laberge1/hw-openmower-universal/mech/PCB_02152026.FCStd

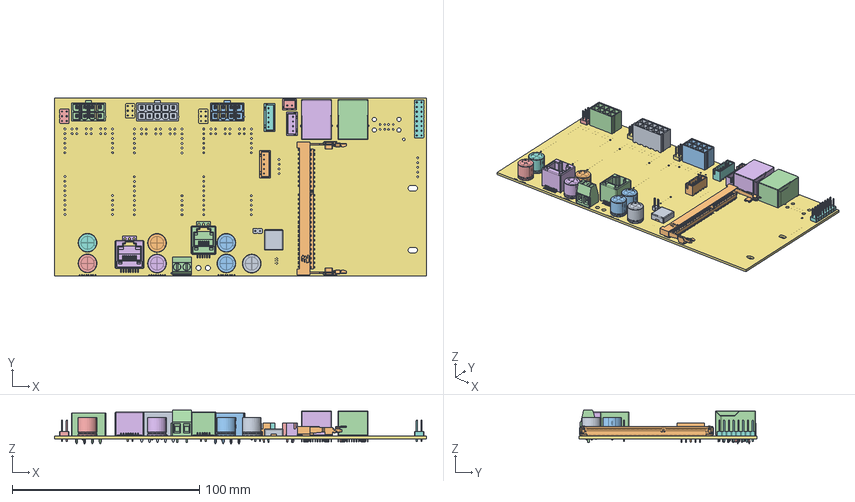
[picture p2: CAD file, 2026-03-07]
mech/PCB_02152026.FCStd
198.5 x 95.0 x 17.9 mm
10127820-1022LF
CP_Radial_D10.0mm_P5.00mm
CP_Radial_D10.0mm_P5.00mm001
10127820-082XXXLF
JST_XH_B2B-XH-A_1x02_P2.50mm_Vertical
JST_XH_B4B-XH-A_1x04_P2.50mm_Vertical
PinHeader_2x03_P2.54mm_Vertical
JST_XH_B5B-XH-A_1x05_P2.50mm_Vertical
CP_Radial_D10.0mm_P5.00mm002
JST_XH_B5B-XH-A_1x05_P2.50mm_Vertical002
10127820-082XXXLF001
HR911130A
HR911130A001
HR911130A002
HR911130A003
HR911130A004
HR911130A005
HR911130A006
HR911130A007
HR911130A008
HR911130A009
HR911130A010
HR911130A011
HR911130A012
HR911130A013
HR911130A014
HR911130A015
HR911130A016
HR911130A017
HR911130A018
HR911130A019
HR911130A020
HR911130A021
HR911130A022
HR911130A023
HR911130A024
HR911130A025
CP_Radial_D10.0mm_P5.00mm003
PinHeader_2x03_P2.54mm_Vertical001
CP_Radial_D10.0mm_P5.00mm004
hw-openmower-universal 1.61.005
hw-openmower-universal 1.61.006
hw-openmower-universal 1.61.007
TerminalBlock_Phoenix_MKDS-1,5-2-5.08_1x02_P5.08mm_Horizontal005
CP_Radial_D10.0mm_P5.00mm006
HR911130A027
HR911130A028
HR911130A029
HR911130A030
HR911130A031
HR911130A032
HR911130A033
HR911130A034
HR911130A035
HR911130A036
HR911130A037
HR911130A038
HR911130A039
HR911130A040
HR911130A041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
