laberge1/hw-openmower-universal/external_footprints/10127820_0621GLF/10127820-06xxlfc.stp

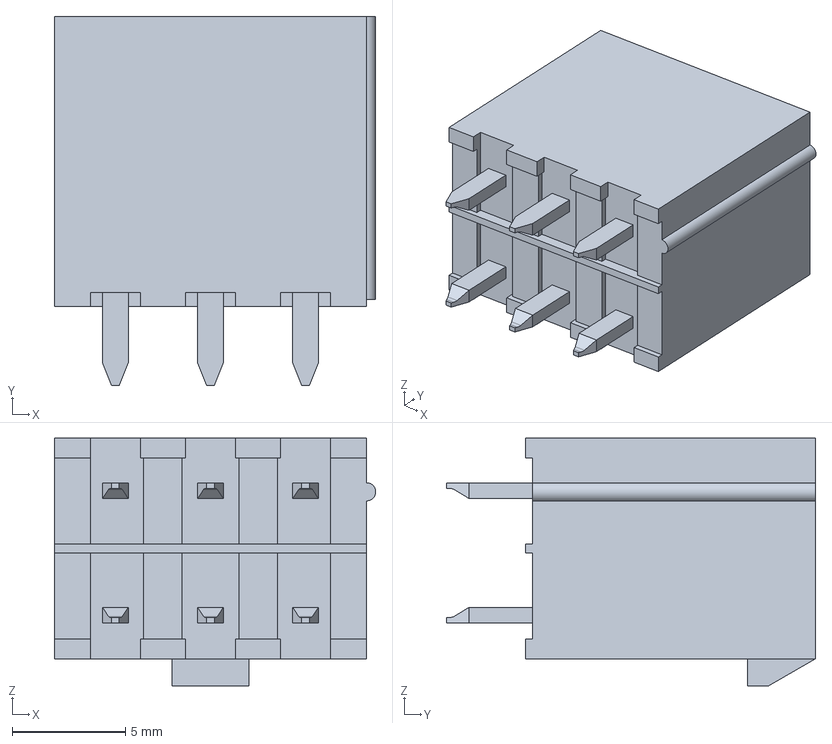
[picture p3: CAD file, 2026-03-07]
external_footprints/10127820_0621GLF/10127820-06xxlfc.stp
14.2 x 16.3 x 10.9 mm
