laberge1/hw-openmower-universal/external_footprints/10127820_0821LF/10127820-082XXXLF.stp

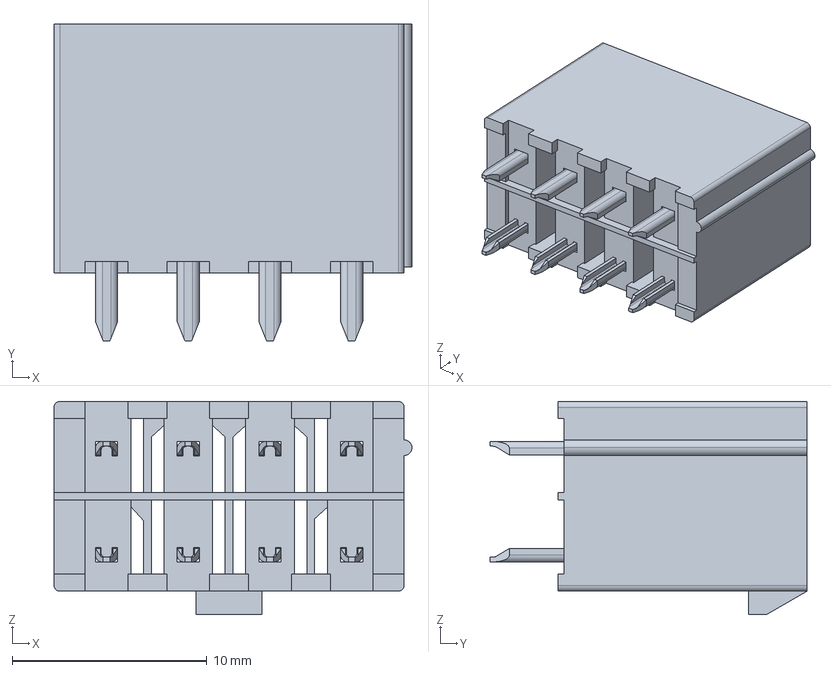
[picture p4: CAD file, 2026-03-07]
external_footprints/10127820_0821LF/10127820-082XXXLF.stp
18.4 x 16.3 x 11.0 mm
