laberge1/hw-openmower-universal/external_footprints/10127820_1022LF/10127820-10xxlfc.stp

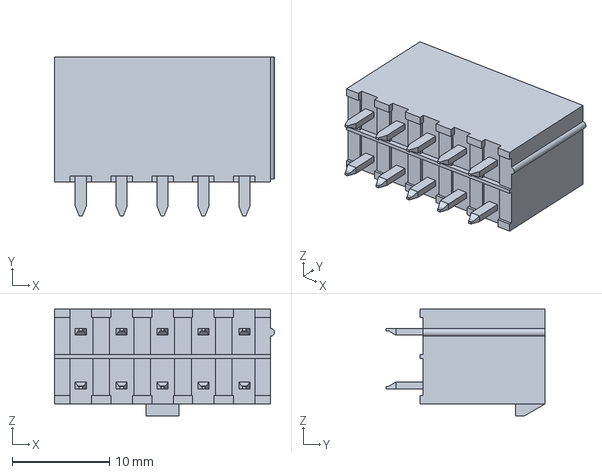
[picture p5: CAD file, 2026-03-07]
external_footprints/10127820_1022LF/10127820-10xxlfc.stp
22.6 x 16.3 x 10.9 mm
