laberge1/hw-openmower-universal/external_footprints/855135002/855135002.stp

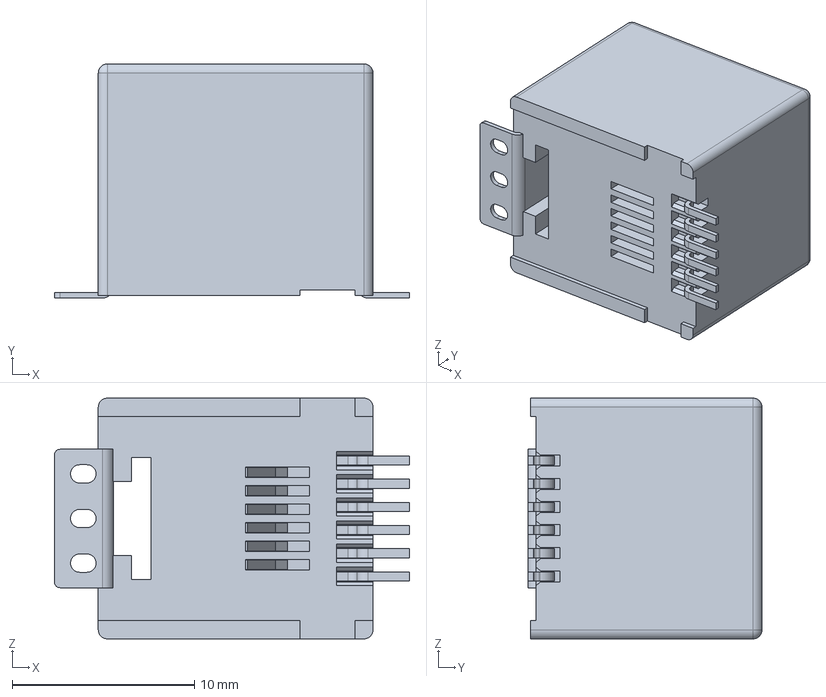
[picture p6: CAD file, 2026-03-07]
external_footprints/855135002/855135002.stp
19.5 x 12.8 x 13.2 mm
