laberge1/hw-openmower-universal/external_footprints/RJ45/855135113.stp

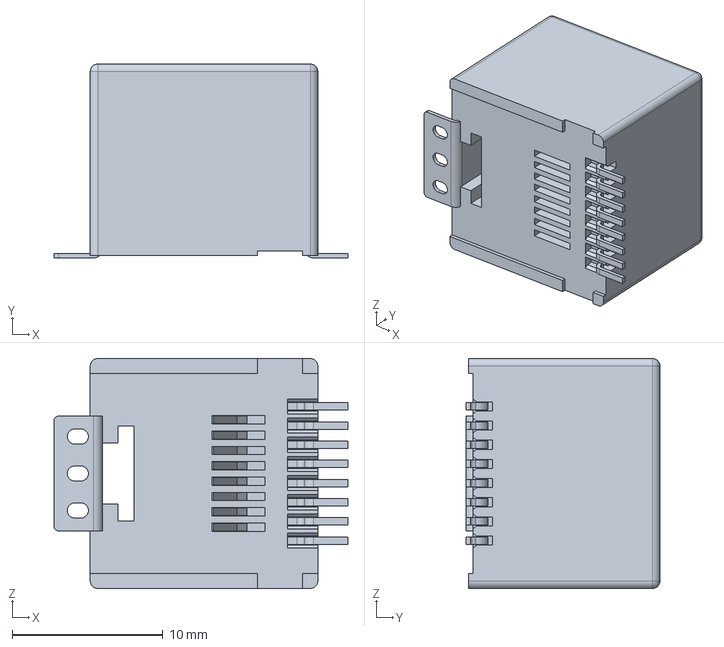
[picture p7: CAD file, 2026-03-07]
external_footprints/RJ45/855135113.stp
19.5 x 12.8 x 15.2 mm
