laberge1/hw-openmower-universal/(list of files, cad)

Other CAD files:
mech/2.FCStd
external_footprints/10127820_1022LF/10127820-1022LF.step
