laberge1/hw-openmower-universal/schematics/hw-openmower-universal.pdf

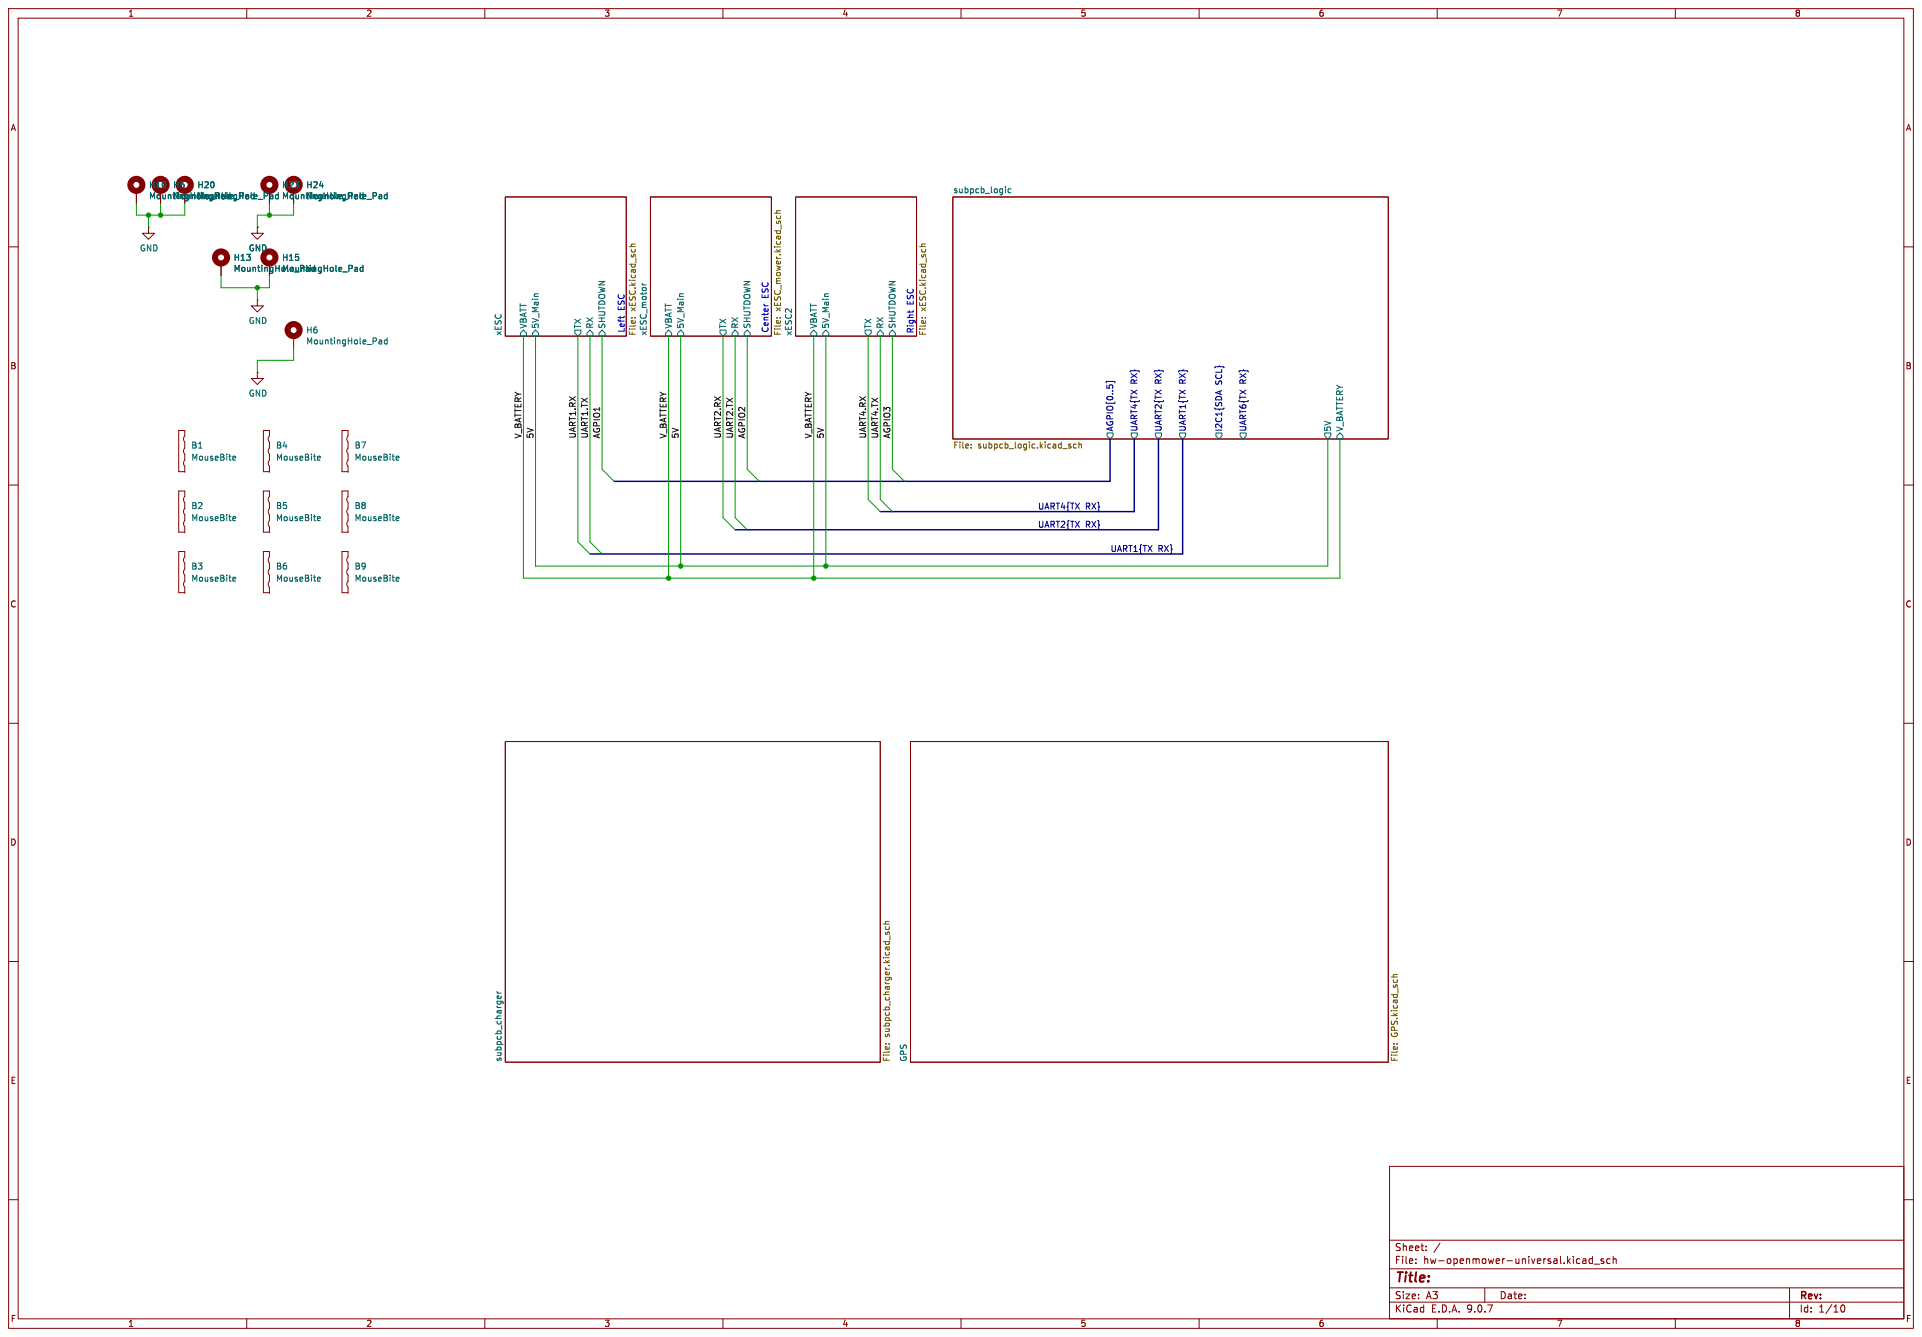
[picture p8: page 1]

UART1{TX RX} Right ESC Center ESC Left ESC

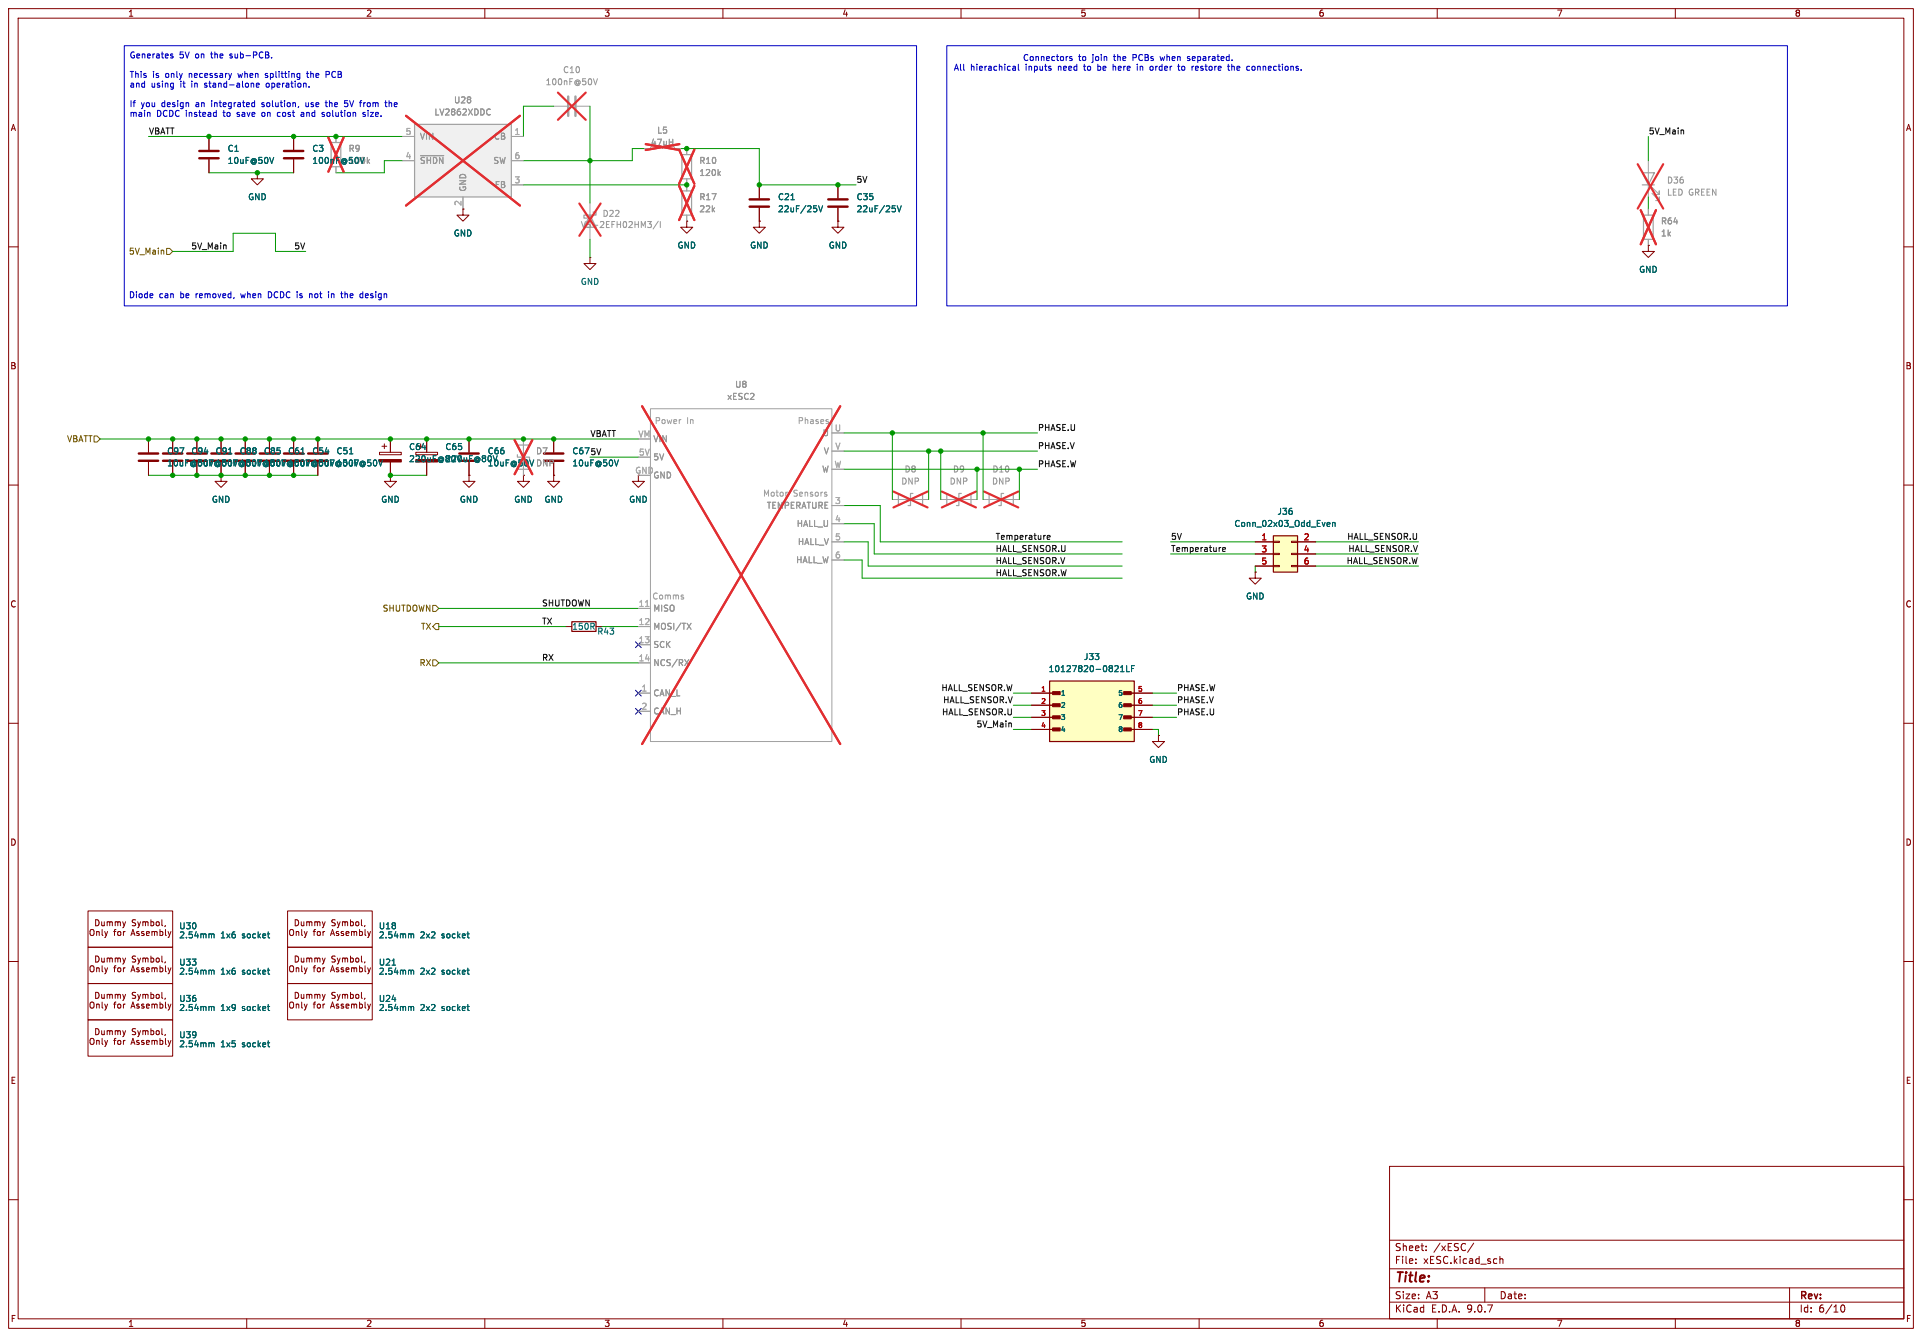
[picture p9: page 2]

2 CB 1 SW 6 FB 3 GND

D10 DNP D9 DNP D8 DNP GND

Id: 6/10 Title: File: xESC.kicad_sch Sheet: /xESC/

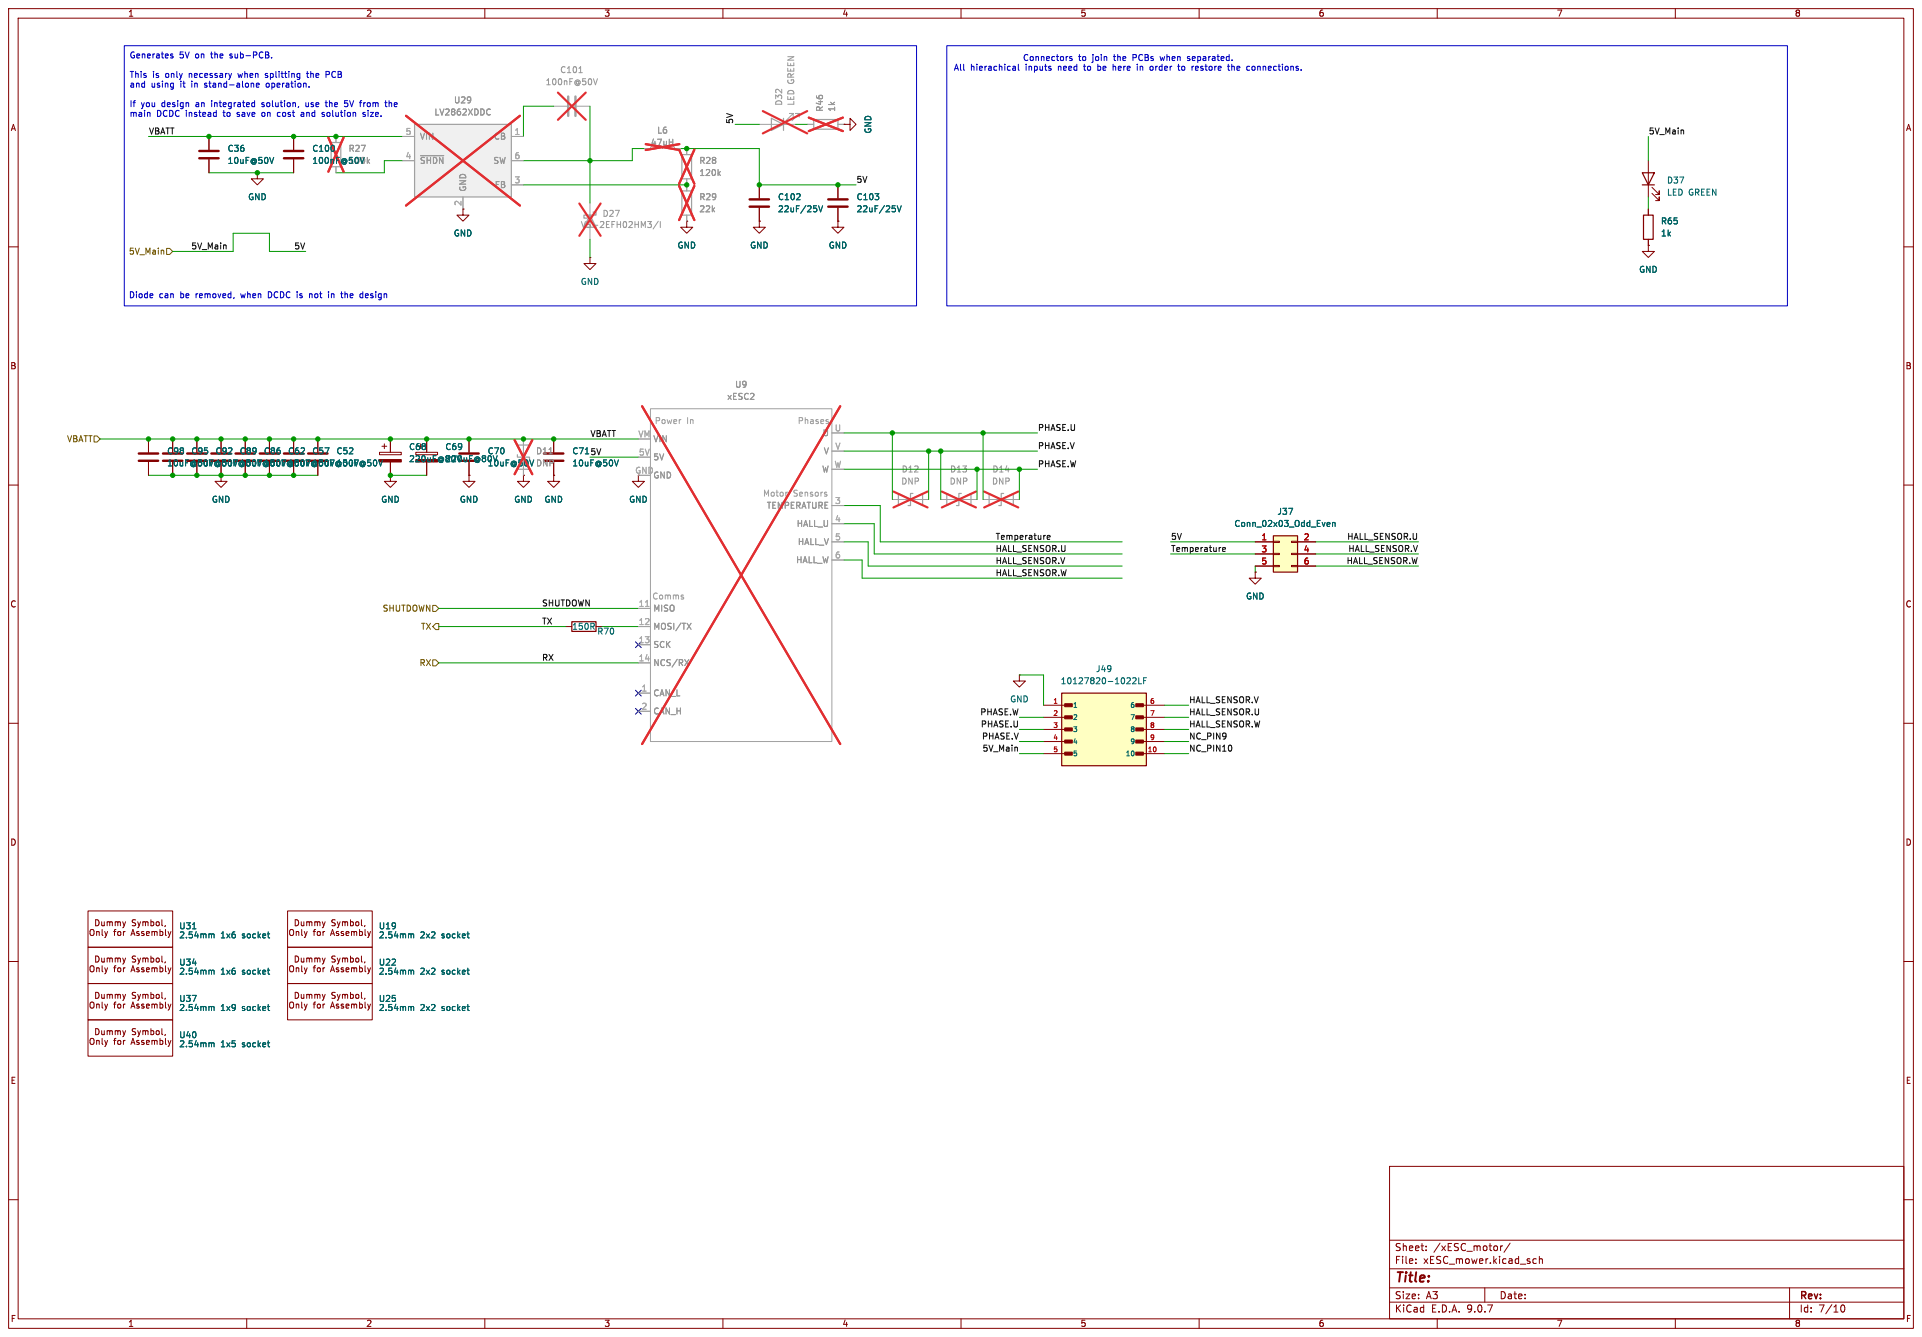
[picture p10: page 3]

2 CB 1 SW 6 FB 3 GND R46 1k L6 GND

Id: 7/10 Title: File: xESC_mower.kicad_sch Sheet: /xESC_motor/

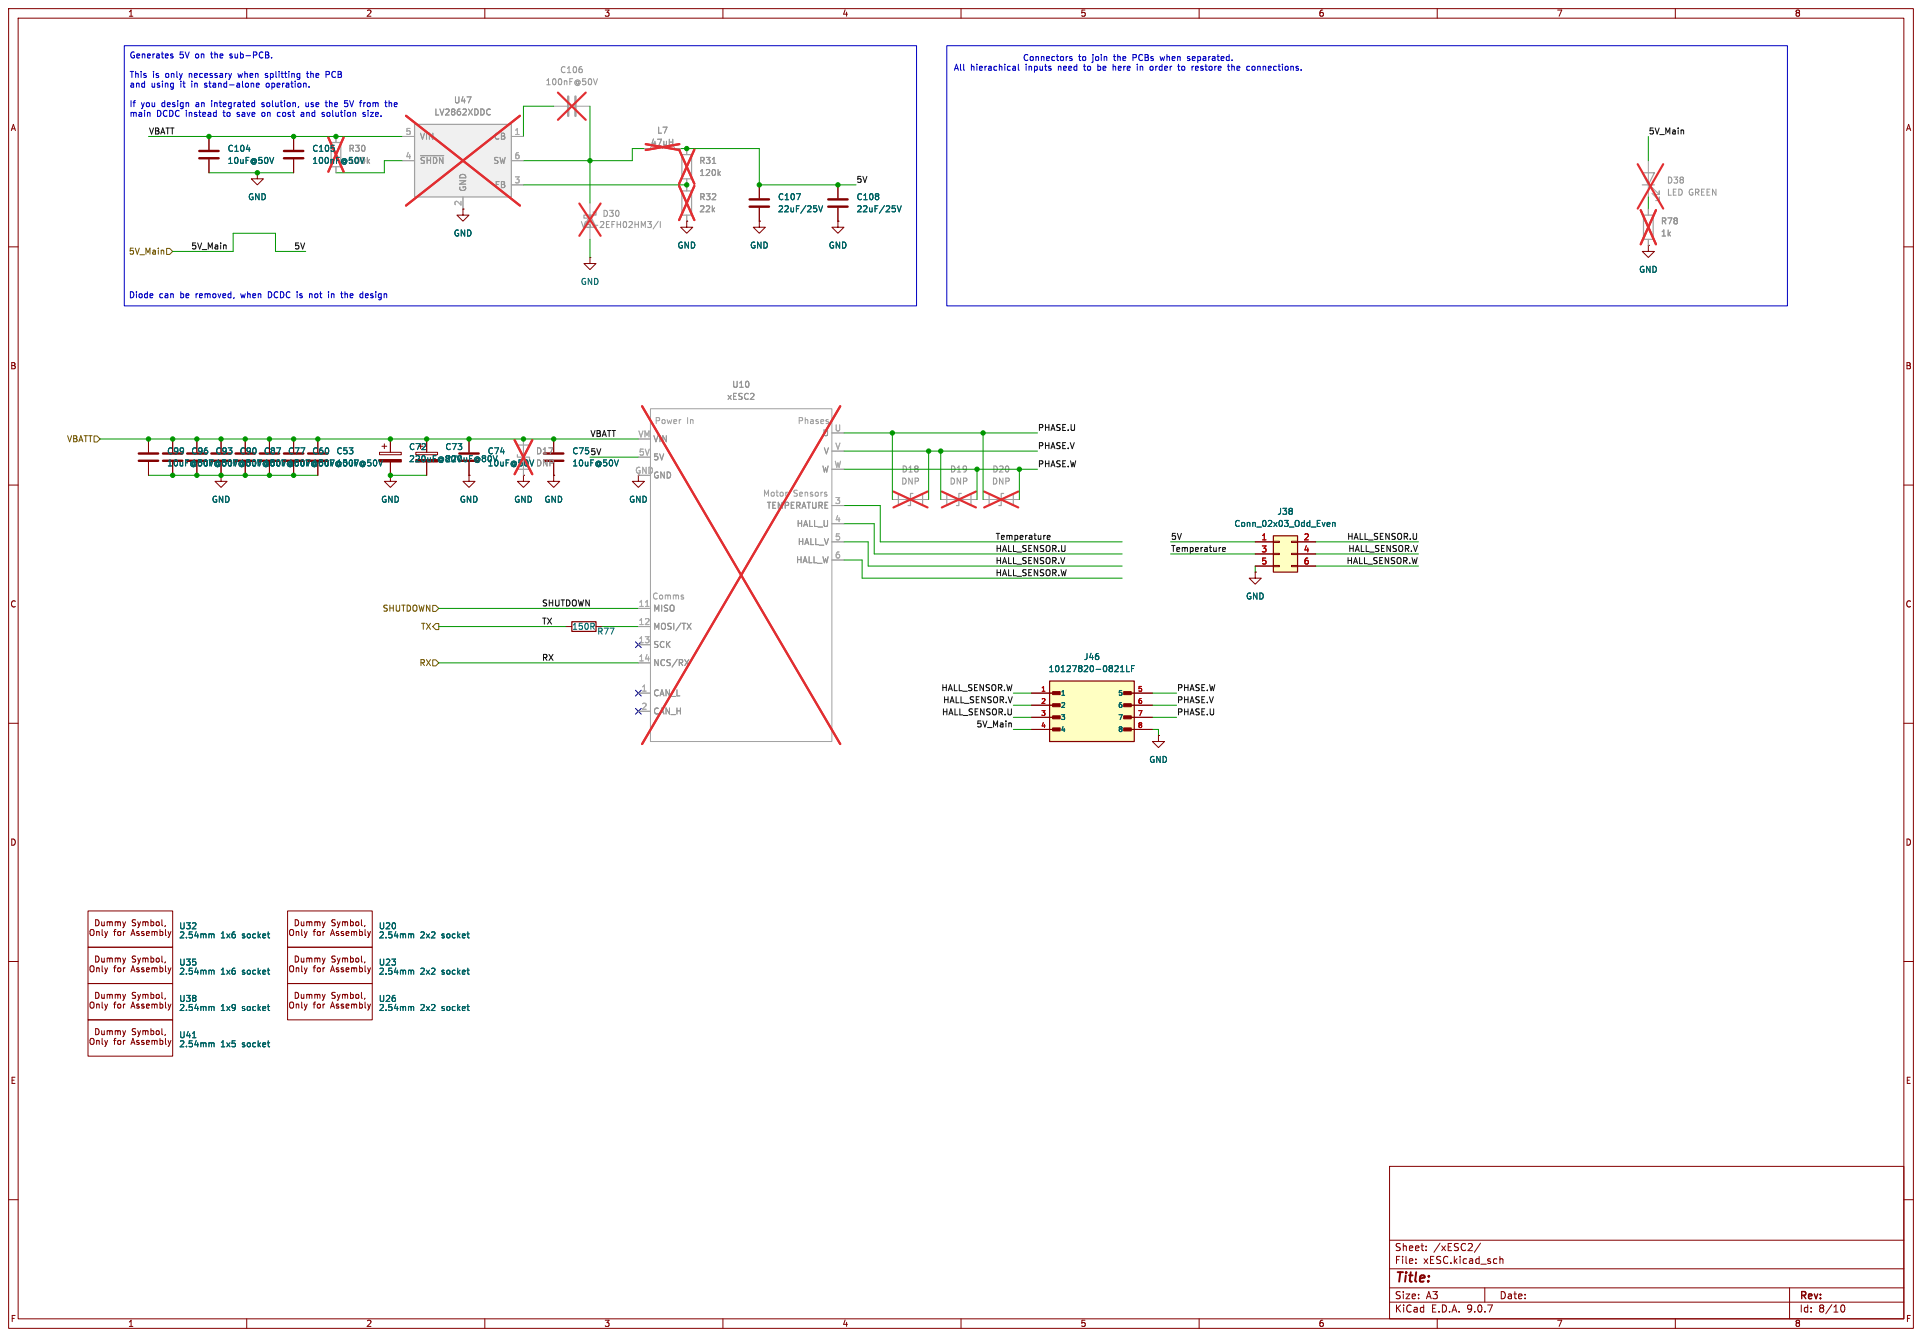
[picture p11: page 4]

2 CB 1 SW 6 FB 3 GND GND

Id: 8/10 Title: File: xESC.kicad_sch Sheet: /xESC2/

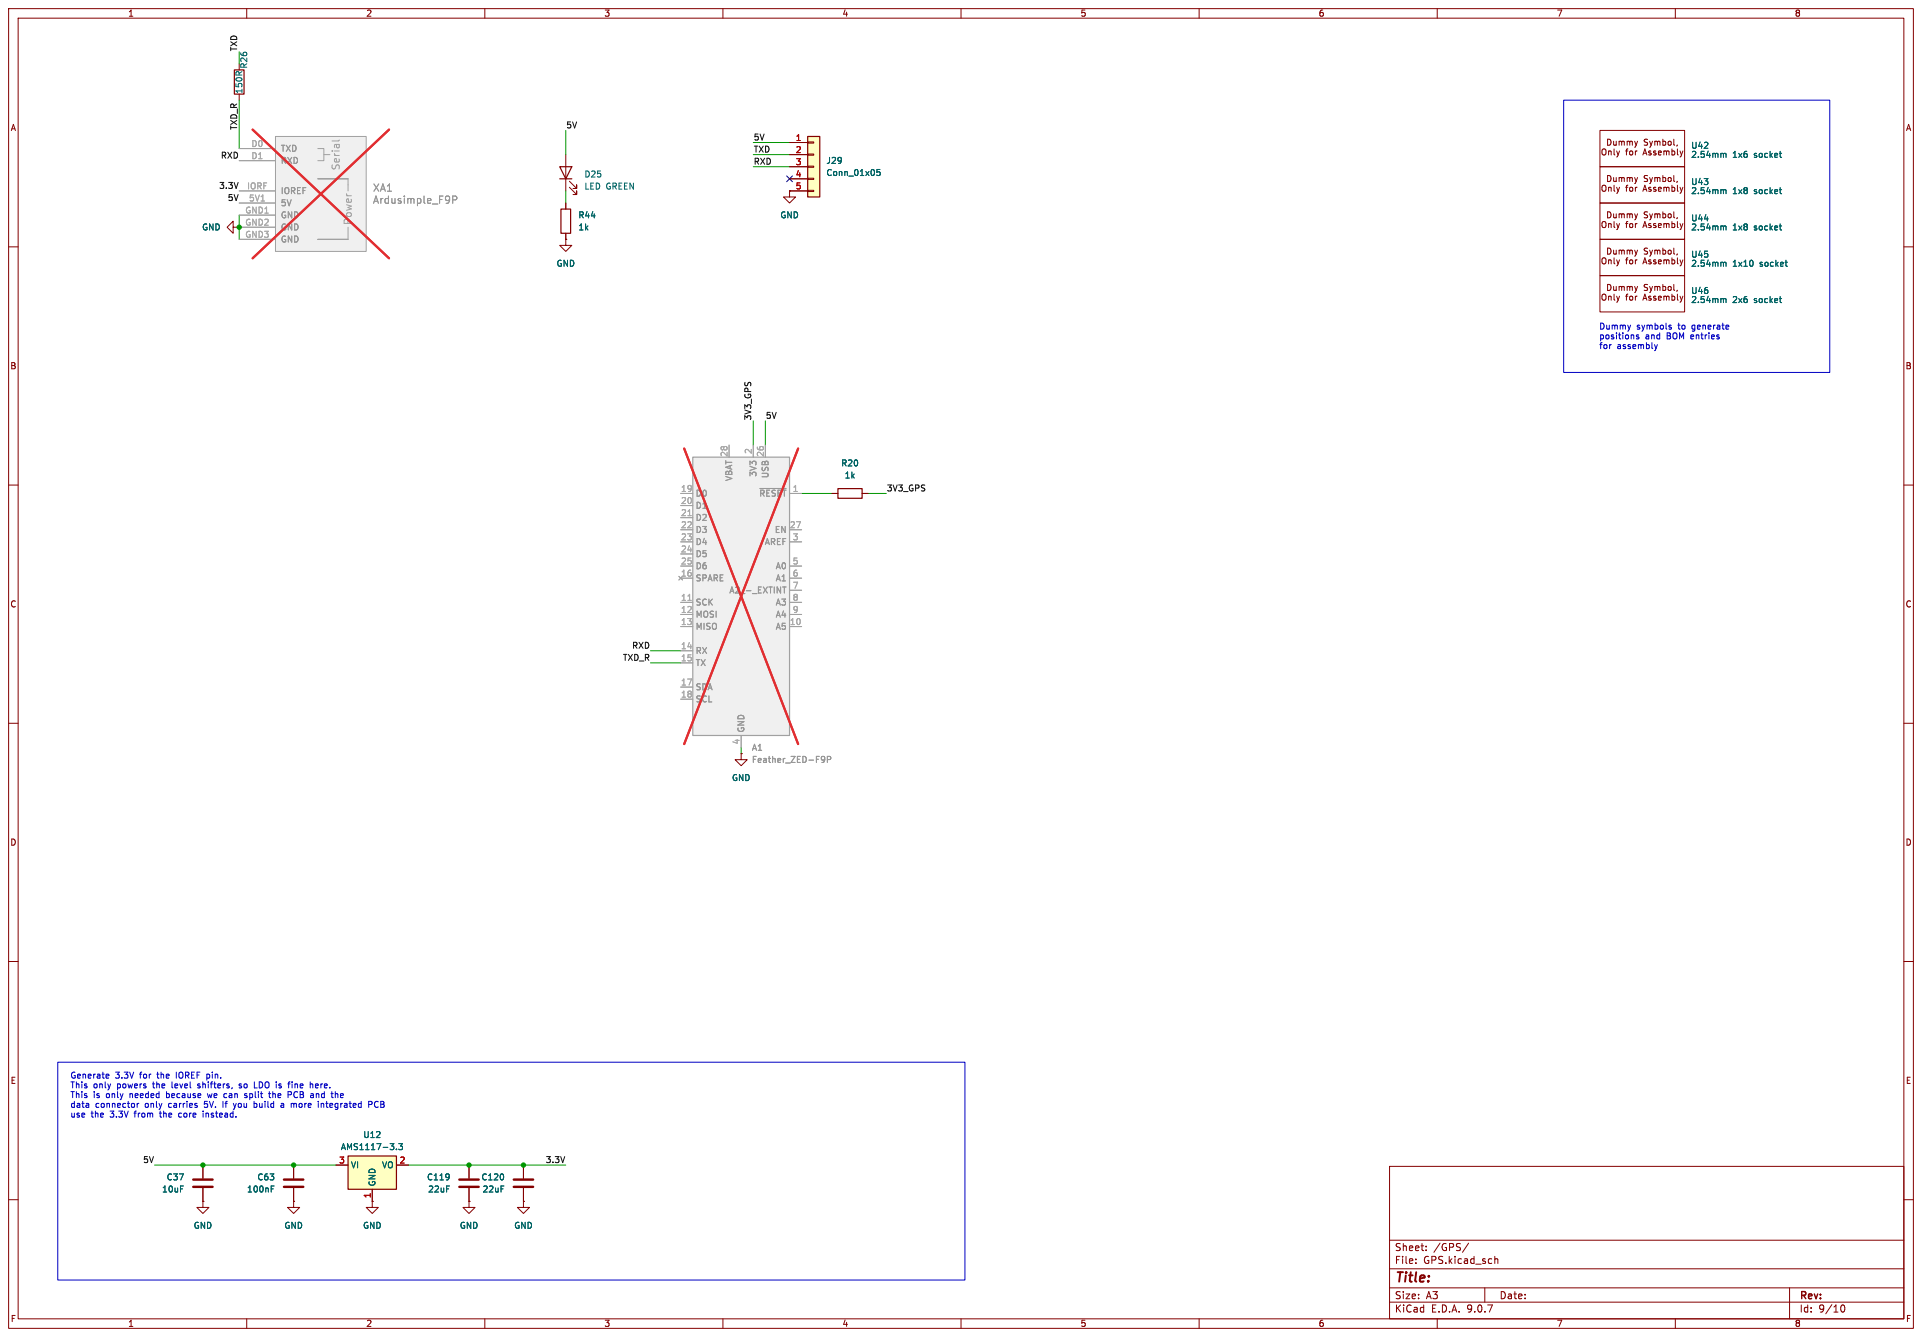
[picture p12: page 5]

Dummy symbols to generate
for assembly

use the 3.3V from the core instead.

Id: 9/10 Title: File: GPS.kicad_sch Sheet: /GPS/

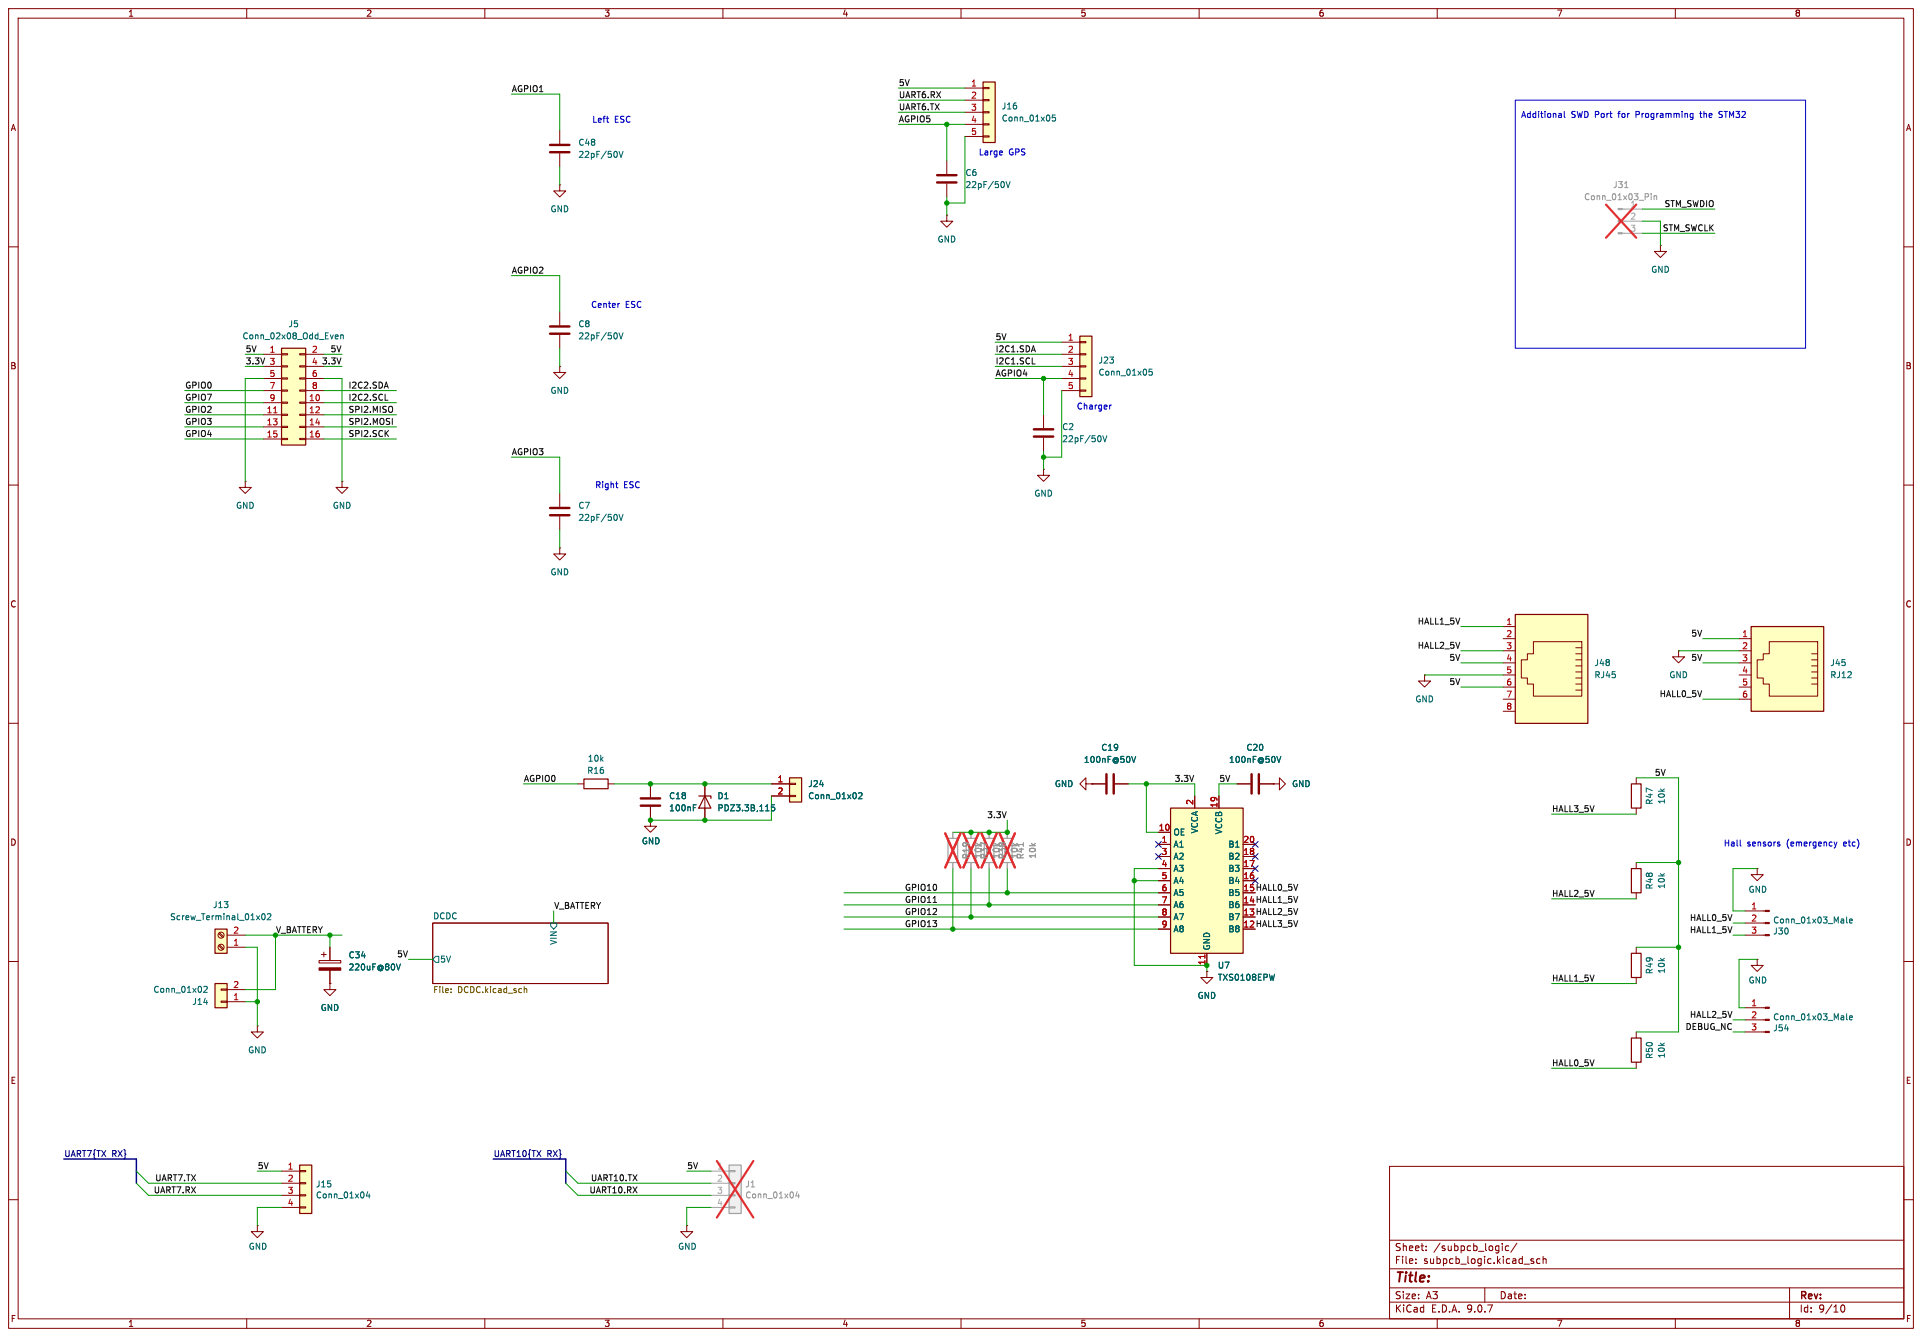
[picture p13: page 6]

Id: 9/10 Title: File: subpcb_logic.kicad_sch Sheet: /subpcb_logic/

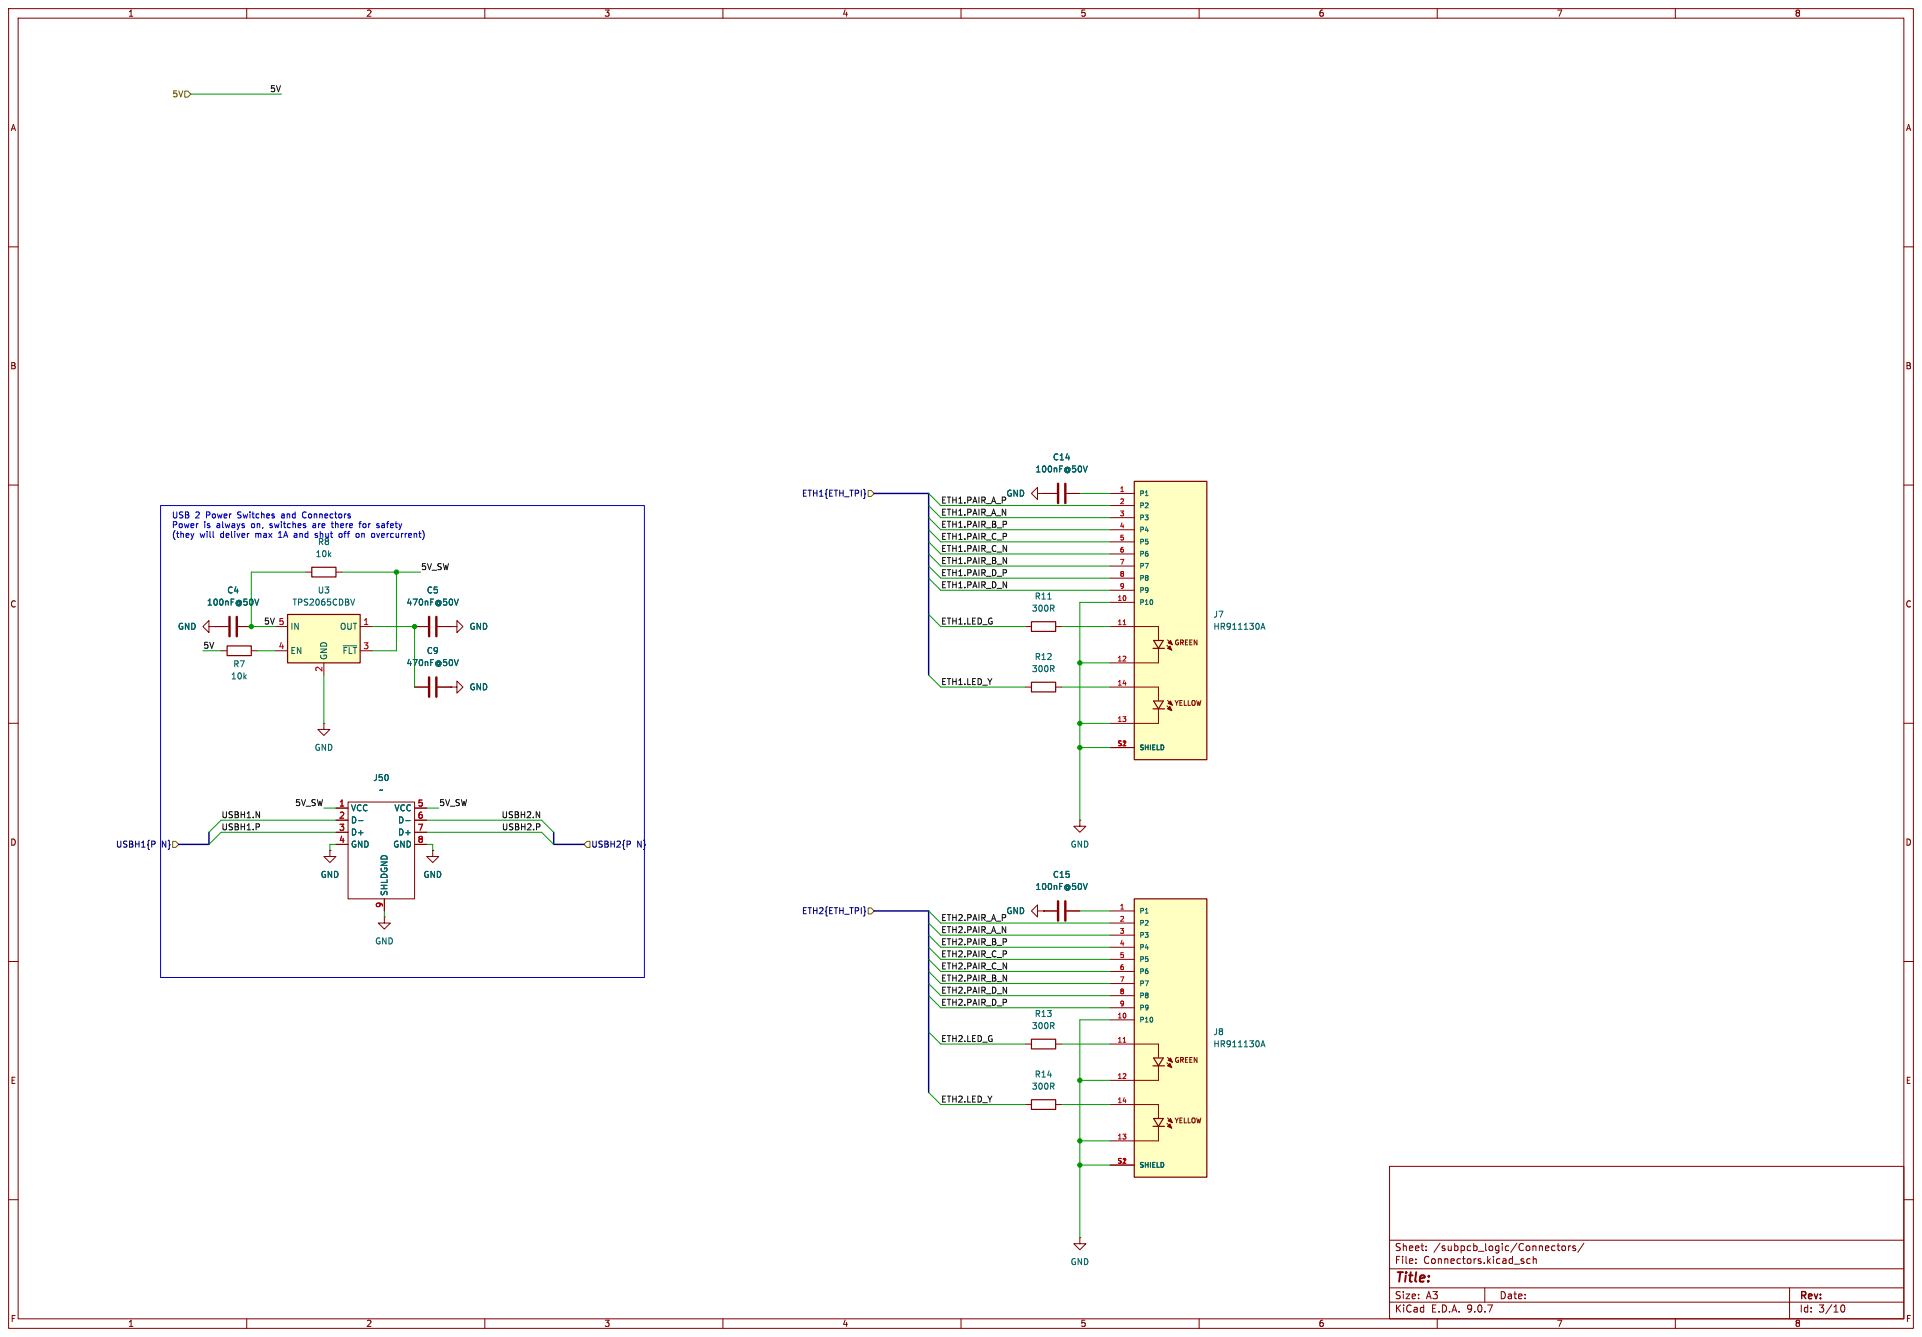
[picture p14: page 7]

USB 2 Power Switches and Connectors Power is always on, switches are there for safety

Id: 3/10 Title: File: Connectors.kicad_sch Sheet: /subpcb_logic/Connectors/

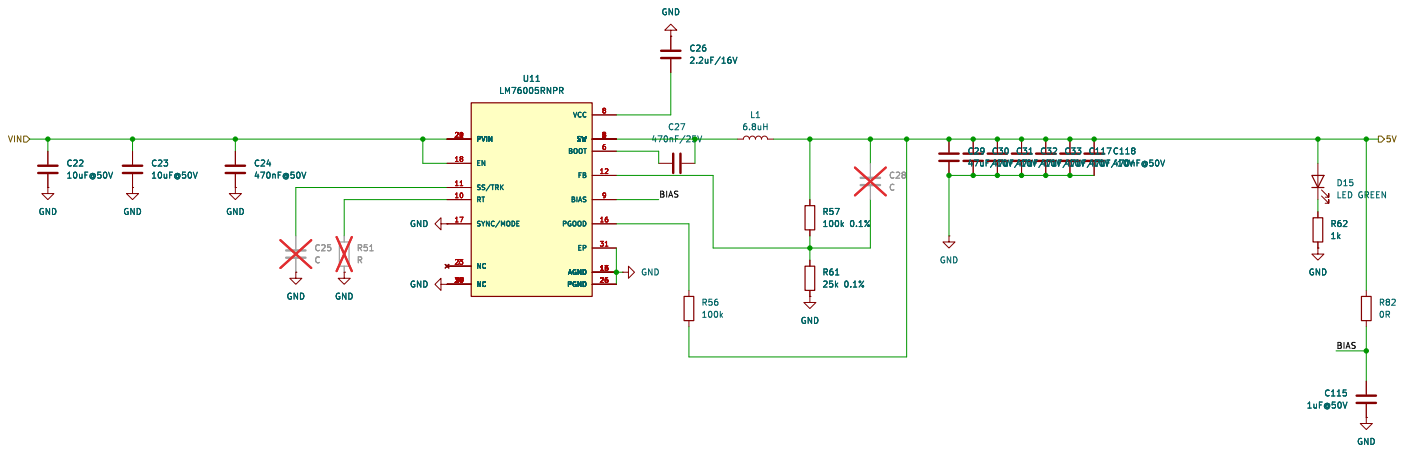
[picture p15: page 8]

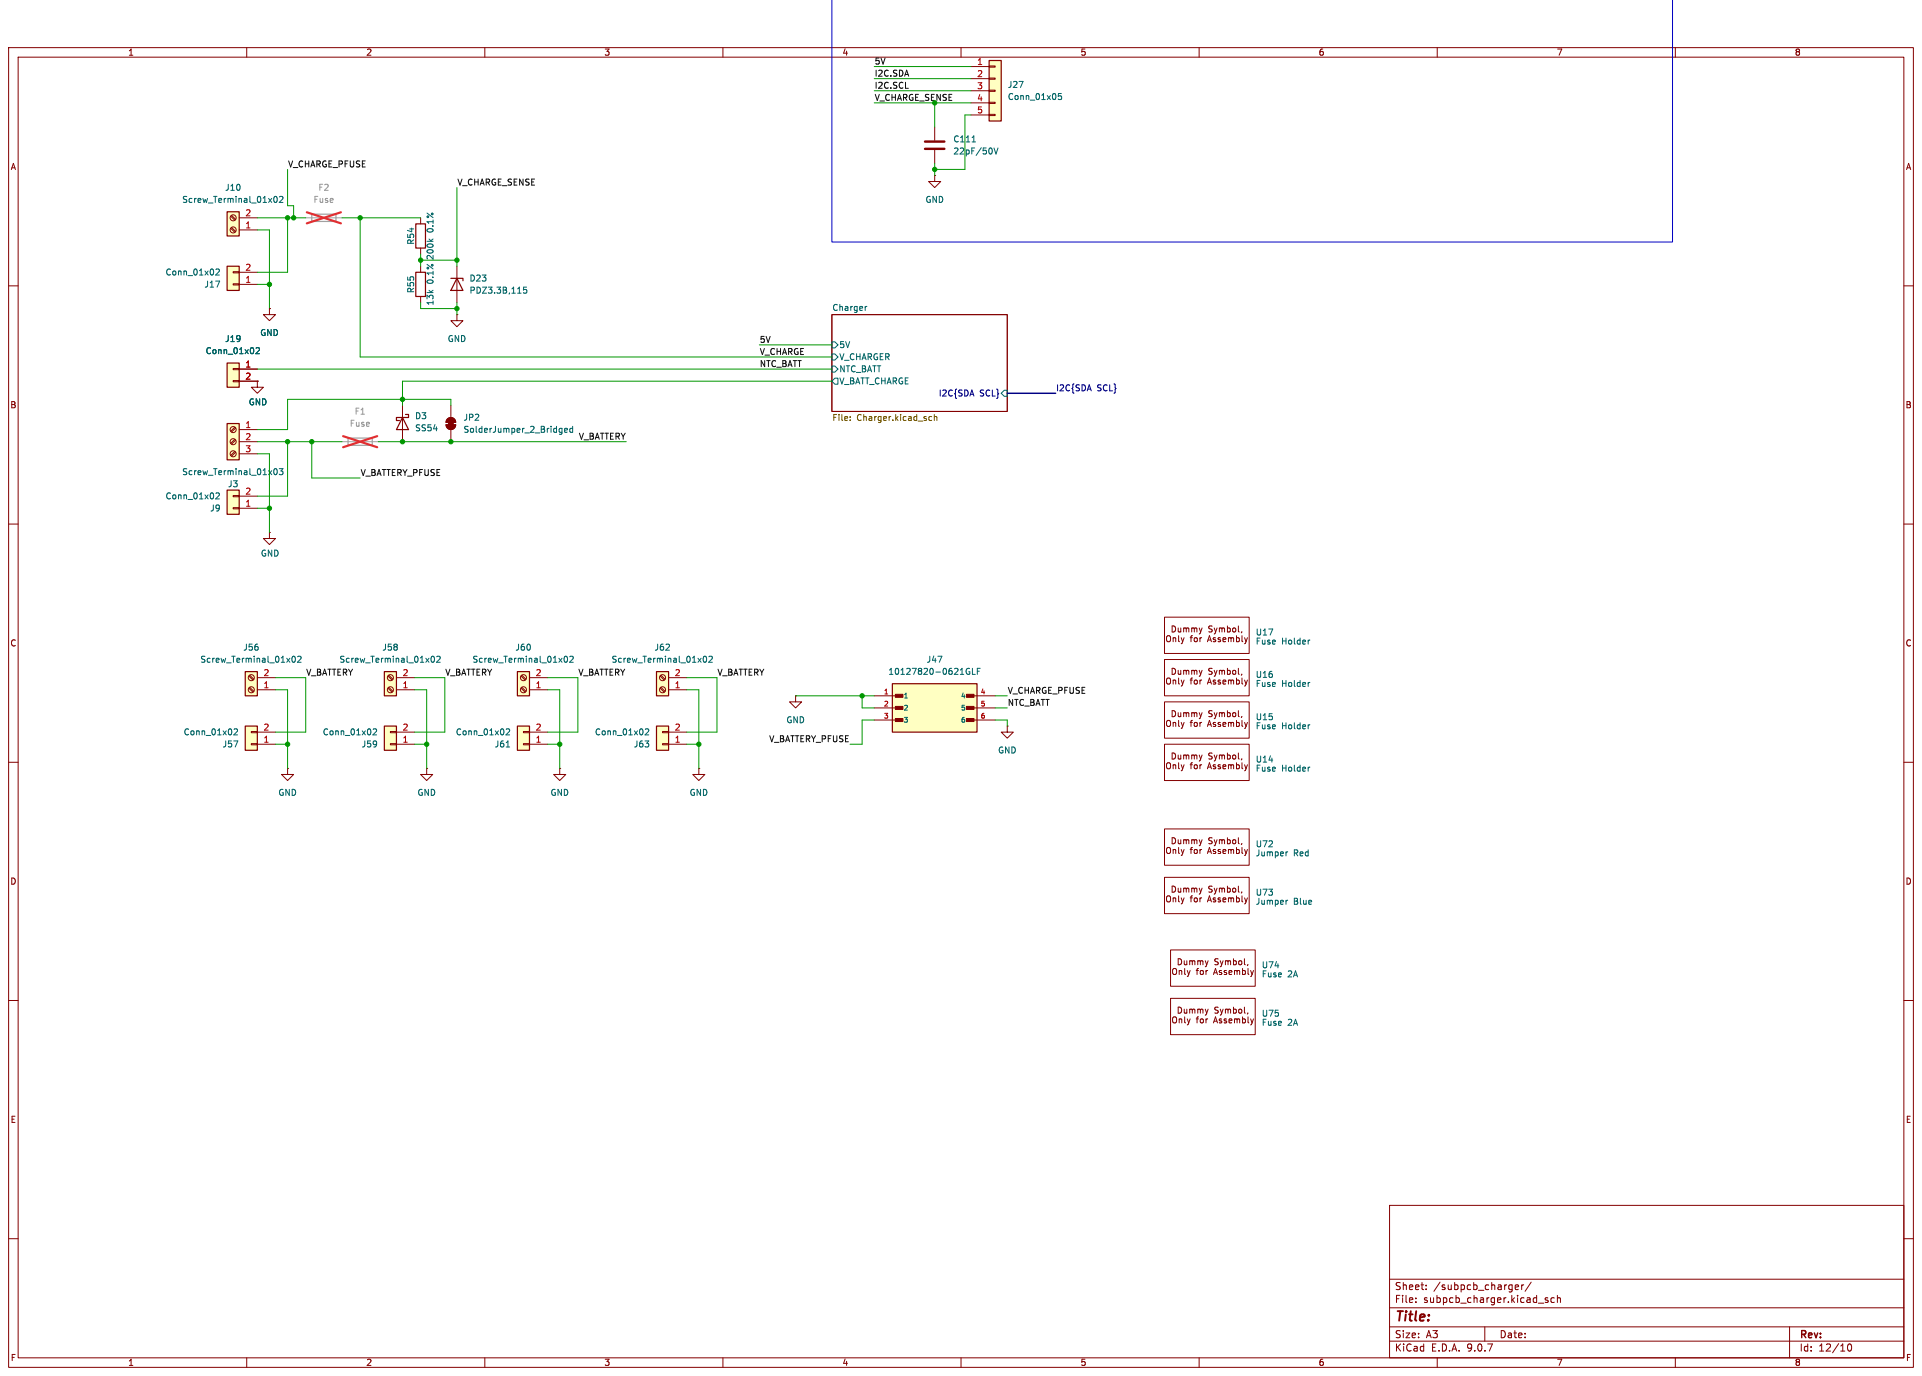
[picture p16: page 9]

I2C{SDA SCL} 5V Charger File: Charger.kicad_sch

Id: 12/10 Title: File: subpcb_charger.kicad_sch Sheet: /subpcb_charger/

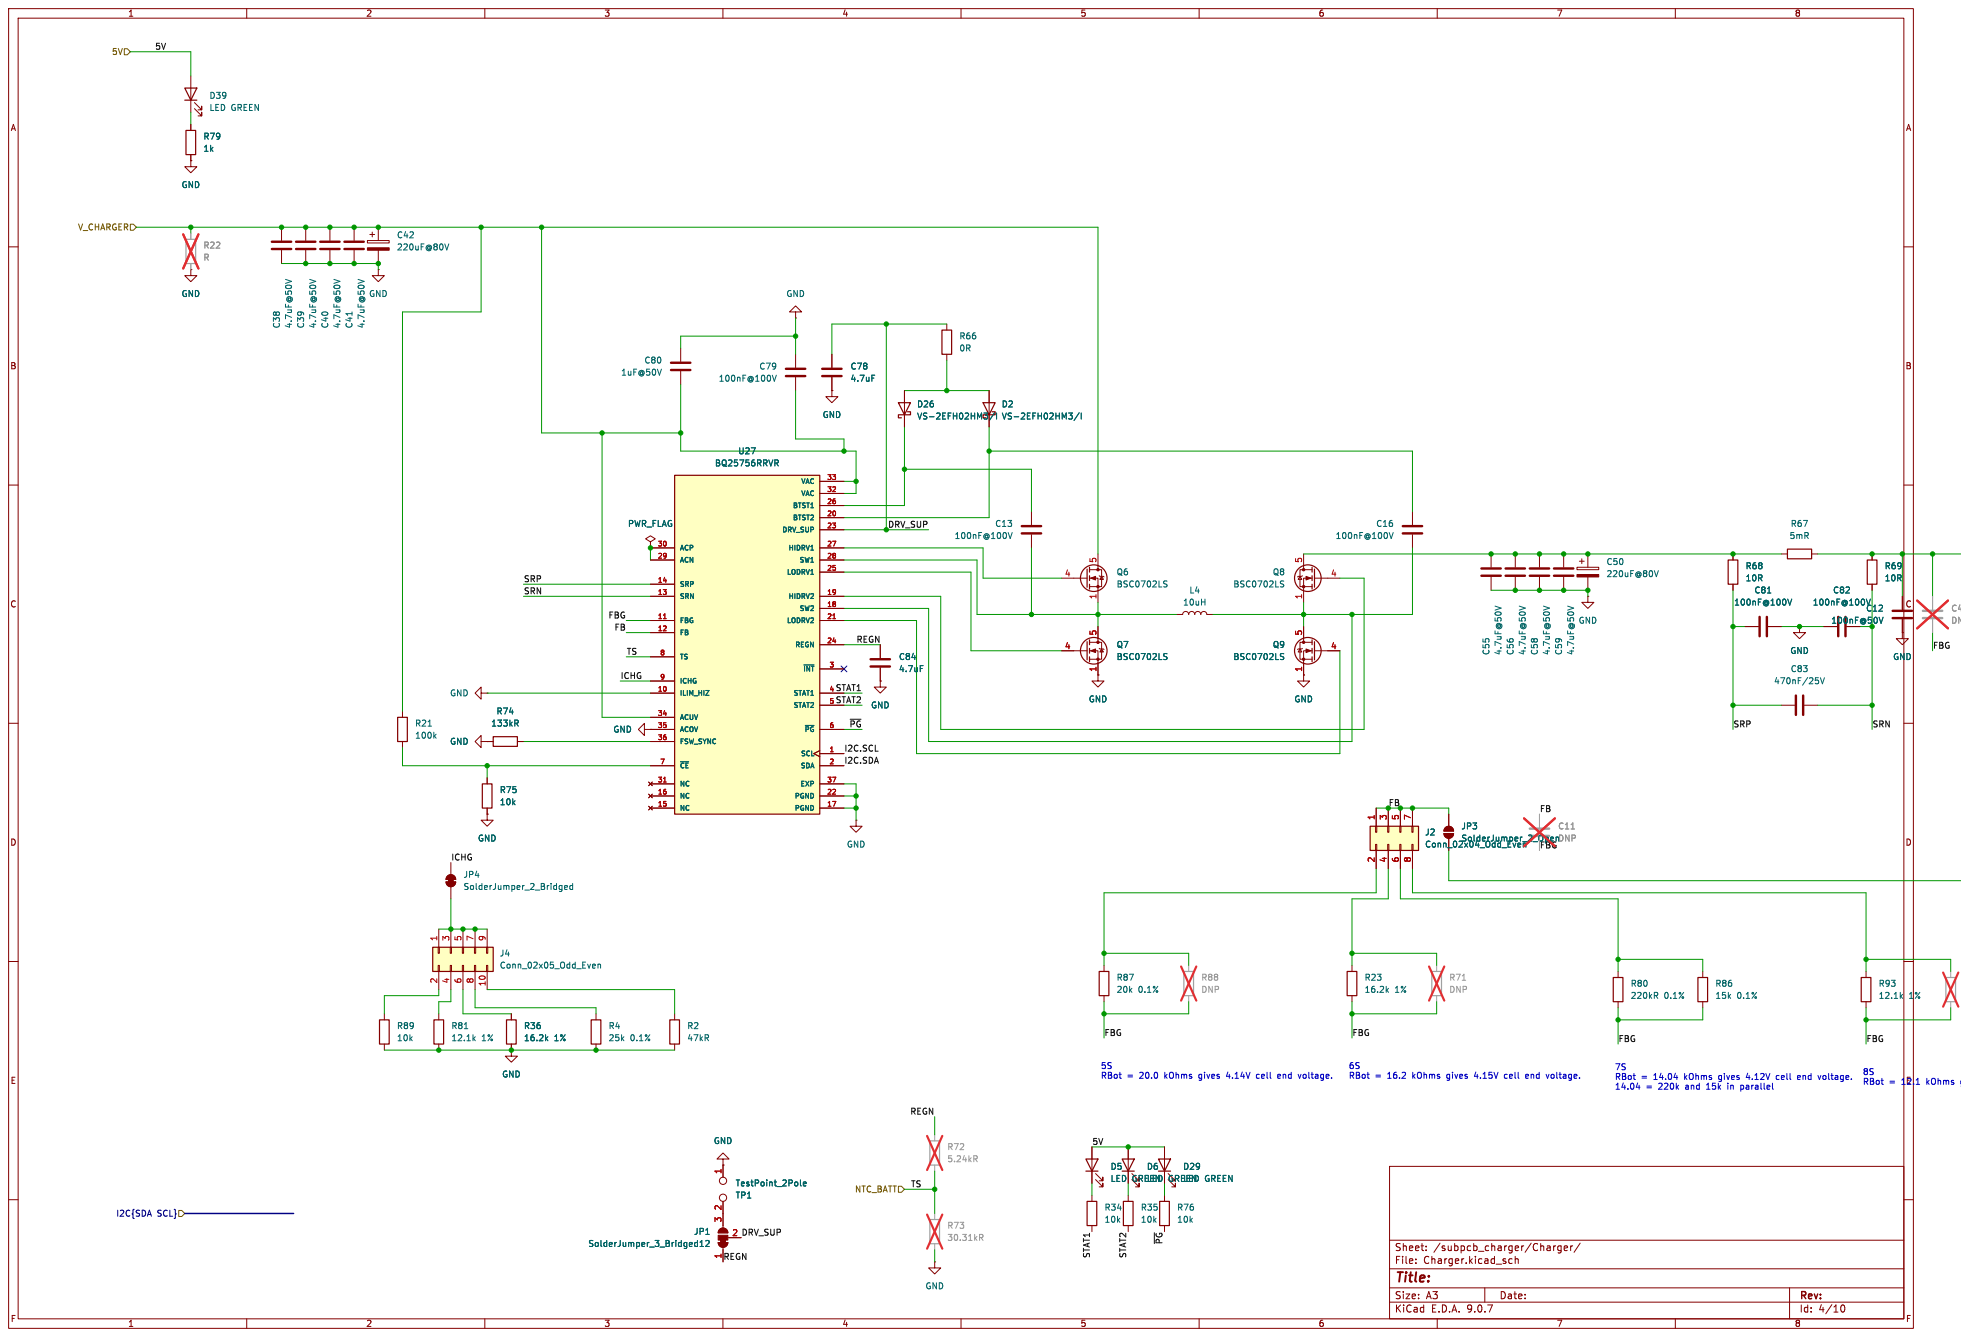
[picture p17: page 10]

Id: 4/10 Title: File: Charger.kicad_sch Sheet: /subpcb_charger/Charger/
