laberge1/hw-openmower-universal/hw-openmower-universal.kicad_pcb

## KiCad design hw-openmower-universal.kicad_pcb (2026-05-27)

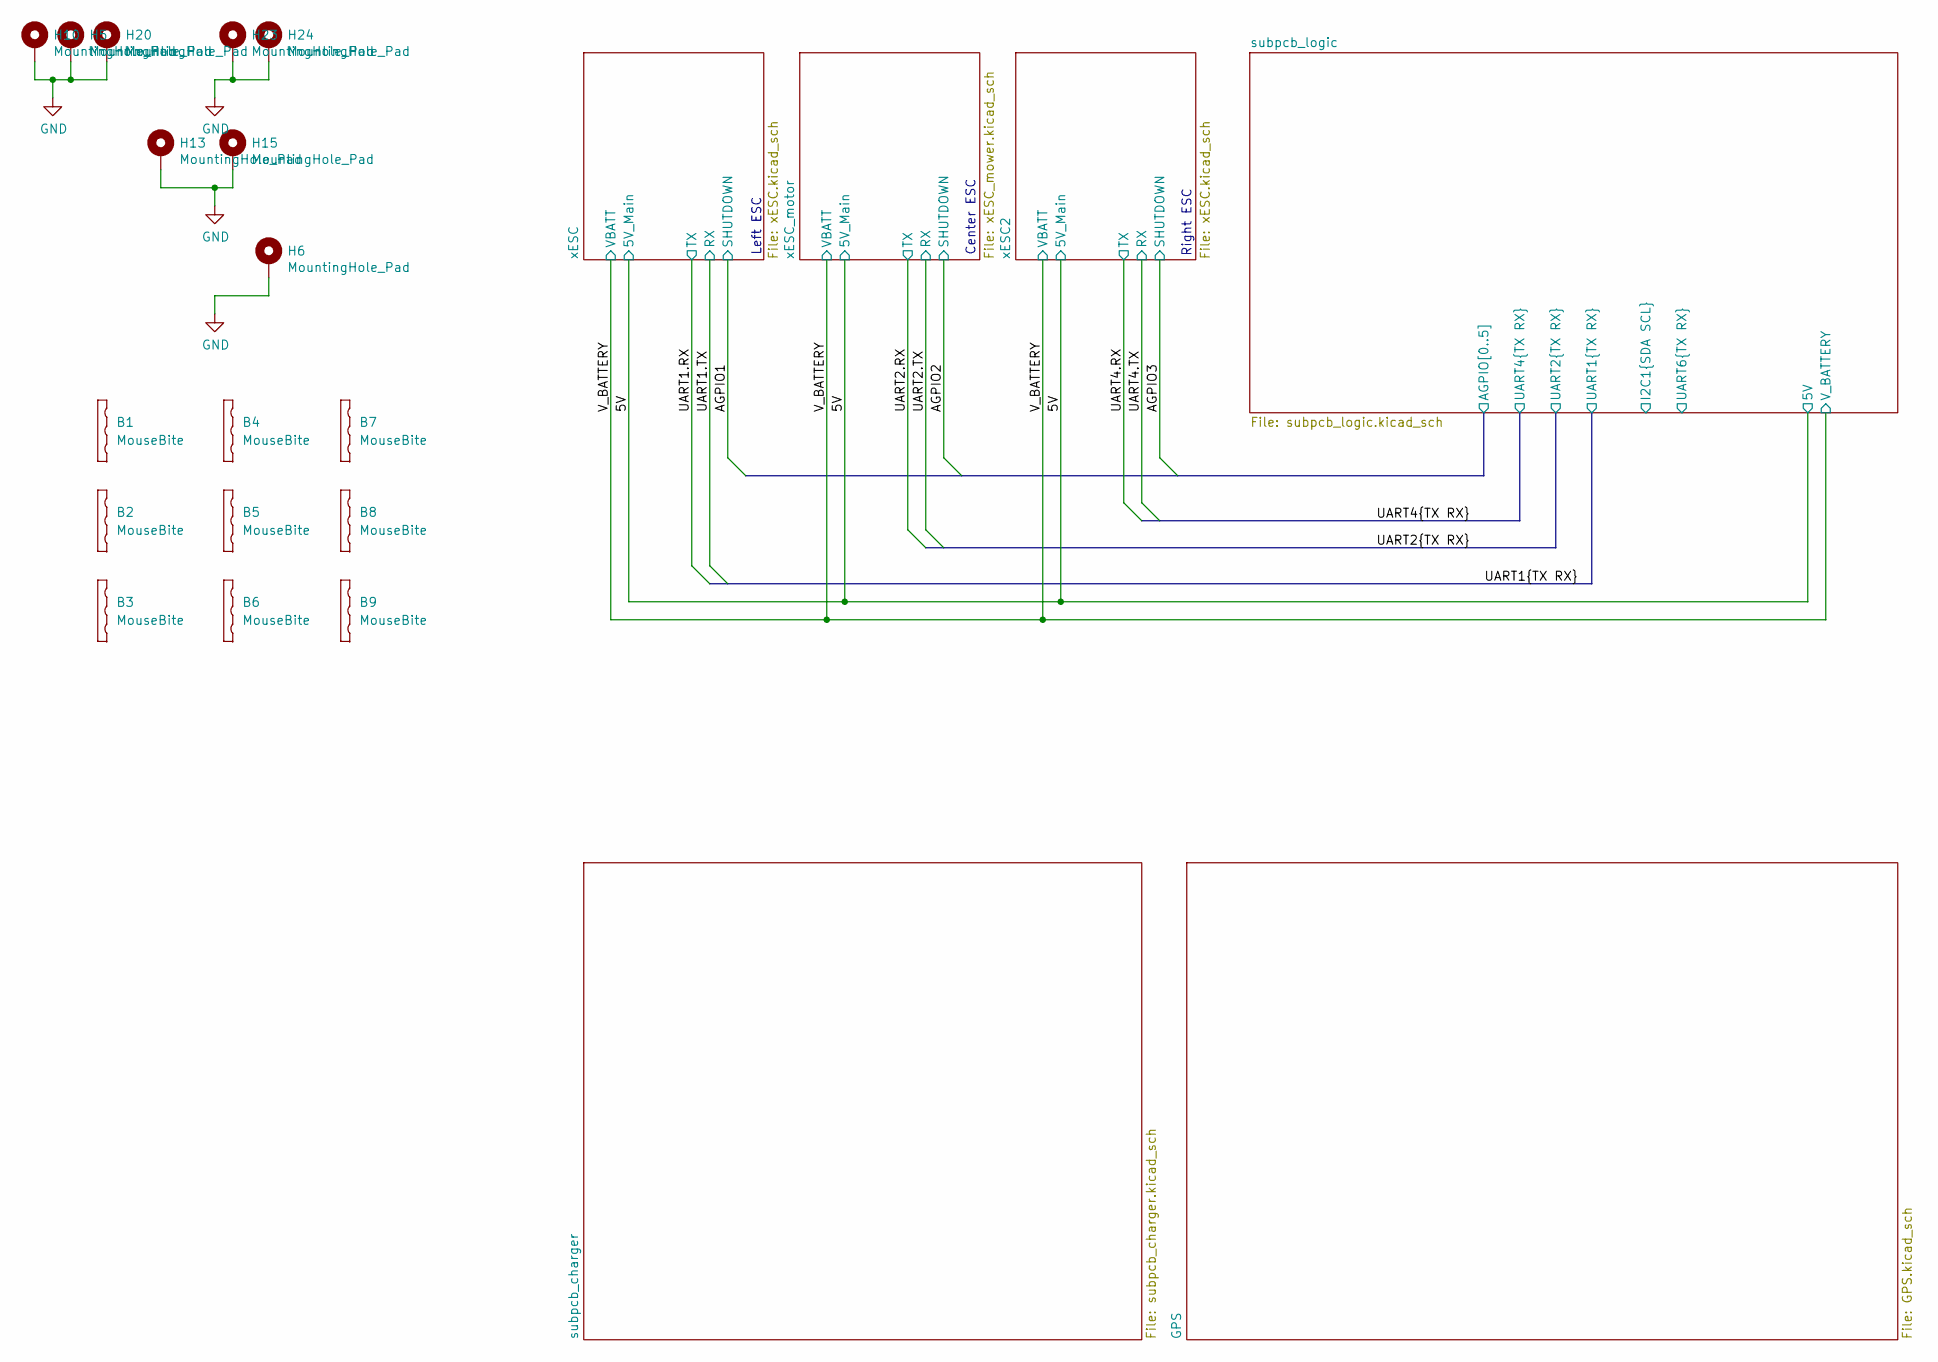
[picture p18: schematic hw-openmower-universal.kicad_sch]

Parts:
B1, B2, B3, B4, B5, B6, B7, B8, B9: MouseBite; MouseBite-Slot_2.0x2.0mm_inset_D0.5mm_P0.85mm_4h_Trace
H5, H6, H10, H13, H15, H20, H23, H24: MountingHole_Pad; MountingHole_4.3mm_M4_Pad_Via

Connections:
GND: H5.1, H6.1, H10.1, H13.1, H15.1, H20.1, H23.1, H24.1; also elsewhere on the board

Notes on the sheet:
Left ESC
Center ESC
Right ESC

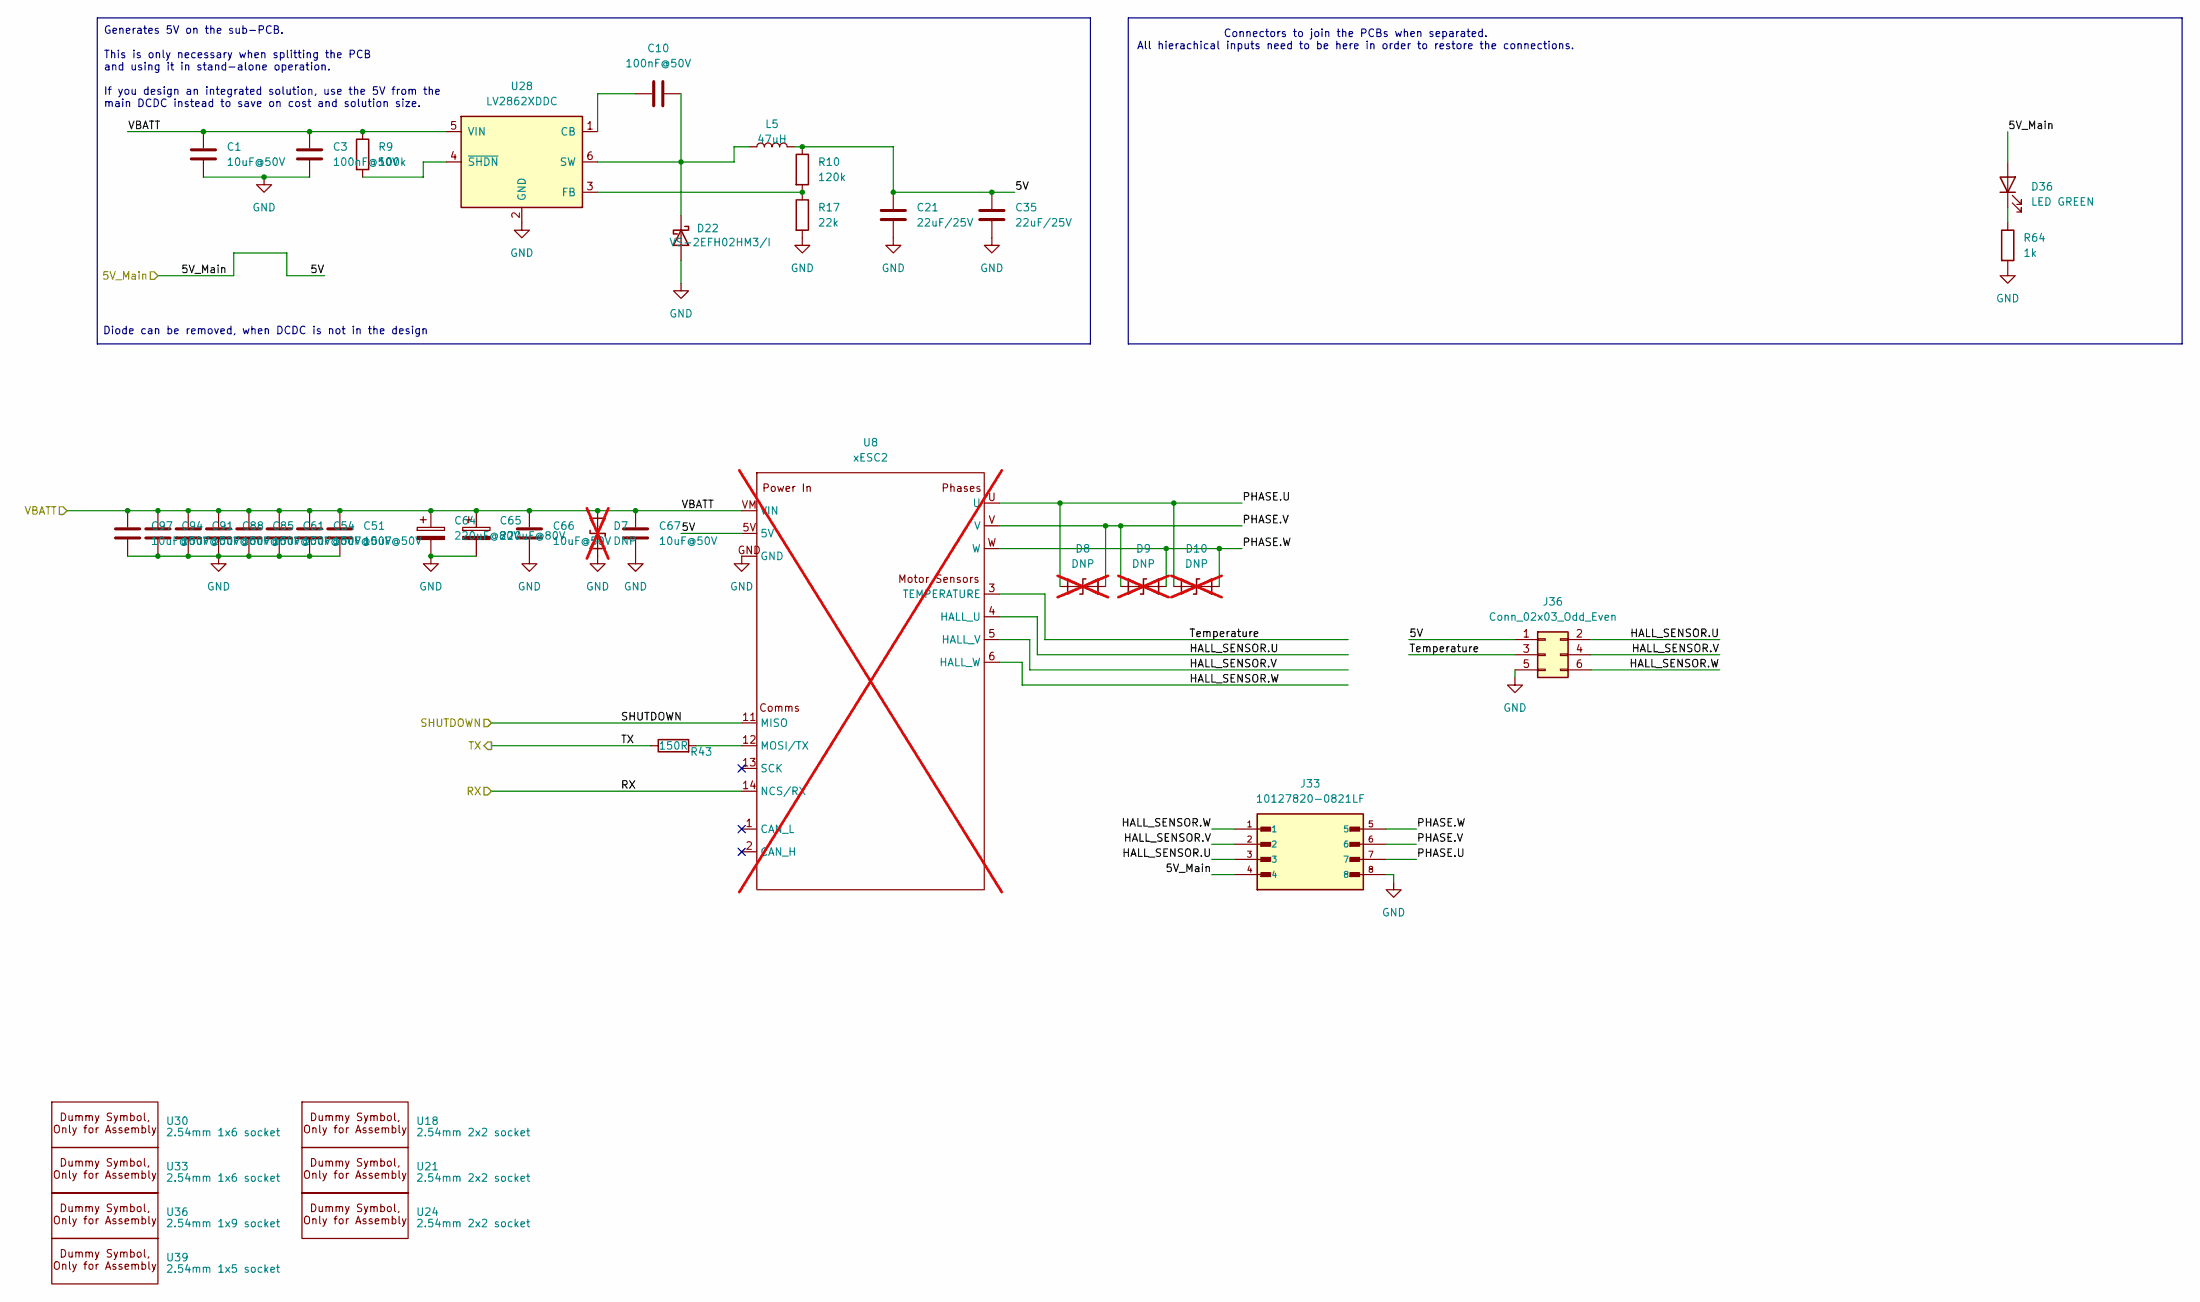
[picture p19: schematic xESC.kicad_sch]

Parts:
C1, C51, C54, C61, C66, C67, C85, C88, C91, C94, C97: 10uF@50V; C_1206_3216Metric; JLC C13585
C3, C10: 100nF@50V; C_0402_1005Metric; JLC C307331
C21, C35: 22uF/25V; C_0805_2012Metric; JLC C45783
C64, C65: 220uF@80V; CP_Radial_D10.0mm_P5.00mm; JLC C106516
D7: DNP; D_SMA; not fitted
D8, D9, D10: DNP; D_SMB; not fitted
D22: VS-2EFH02HM3/I; D_SMF; JLC C241868
D36: LED GREEN; LED_0805_2012Metric; JLC C2297
J33: 10127820-0821LF; AMPHENOL_10127820-0821LF; PARTREV R; DigikeyPN 609-10127820-0821LF-ND
J36: Conn_02x03_Odd_Even; PinHeader_2x03_P2.54mm_Vertical; JLC C5383104
L5: 47uH; L_Sunlord_SWPA5040S; JLC C86617
R9: 100k; R_0402_1005Metric; JLC C25741
R10: 120k; R_0603_1608Metric; JLC C25808
R17: 22k; R_0603_1608Metric; JLC C31850
R43: 150R; R_0603_1608Metric; JLC C22808
R64: 1k; R_0805_2012Metric; JLC C17513
U8: xESC2; xESC2-mini; not fitted
U18, U21, U24: 2.54mm 2x2 socket; Dummy; JLC C92273
U28: LV2862XDDC; SOT-23-6; JLC C3200285
U30, U33: 2.54mm 1x6 socket; Dummy; JLC C7509518
U36: 2.54mm 1x9 socket; Dummy; JLC C7509520
U39: 2.54mm 1x5 socket; Dummy; JLC C7509517

Connections:
/5V: C21.1, C35.1, D36.2 (A), J33.4, J36.1, L5.2, R10.1, U8.5V; also elsewhere on the board
/UART1.RX: R43.1; also elsewhere on the board
/UART1.TX: U8.14 (NCS/RX); also elsewhere on the board
/V_BATTERY: C1.1, C3.1, C51.1, C54.1, C61.1, C64.1, C65.1, C66.1, C67.1, C85.1, C88.1, C91.1, C94.1, C97.1, D7.2 (A2), R9.1, U8.VM (VIN), U28.5 (VIN); also elsewhere on the board
/subpcb_logic/AGPIO1: U8.11 (MISO); also elsewhere on the board
/xESC/HALL_SENSOR.U: J33.3, J36.2, U8.4 (HALL_U)
/xESC/HALL_SENSOR.V: J33.2, J36.4, U8.5 (HALL_V)
/xESC/HALL_SENSOR.W: J33.1, J36.6, U8.6 (HALL_W)
/xESC/PHASE.U: D8.2 (A2), D10.2 (A2), J33.7, U8.U
/xESC/PHASE.V: D8.1 (A1), D9.2 (A2), J33.6, U8.V
/xESC/PHASE.W: D9.1 (A1), D10.1 (A1), J33.5, U8.W
/xESC/Temperature: J36.3, U8.3 (TEMPERATURE)
GND: C1.2, C3.2, C21.2, C35.2, C51.2, C54.2, C61.2, C64.2, C65.2, C66.2, C67.2, C85.2, C88.2, C91.2, C94.2, C97.2, D7.1 (A1), D22.2 (A), J33.8, J36.5, R17.2, R64.2, U8.GND, U28.2 (GND); also elsewhere on the board
unnamed: C10.1, D22.1 (K), L5.1, U28.6 (SW)
unnamed: D36.1 (K), R64.1
unnamed: R43.2, U8.12 (MOSI/TX)
unnamed: C10.2, U28.1 (CB)
unnamed: R10.2, R17.1, U28.3 (FB)
unnamed: R9.2, U28.4 (~SHDN)

Parts of its further copies:
C53, C60, C74, C75, C77, C87, C90, C93, C96, C99, C104: 10uF@50V; C_1206_3216Metric; JLC C13585
C72, C73: 220uF@80V; CP_Radial_D10.0mm_P5.00mm; JLC C106516
C105, C106: 100nF@50V; C_0402_1005Metric; JLC C307331
C107, C108: 22uF/25V; C_0805_2012Metric; JLC C45783
D17: DNP; D_SMA; not fitted
D18, D19, D20: DNP; D_SMB; not fitted
D30: VS-2EFH02HM3/I; D_SMF; JLC C241868
D38: LED GREEN; LED_0805_2012Metric; JLC C2297
J38: Conn_02x03_Odd_Even; PinHeader_2x03_P2.54mm_Vertical; JLC C5383104
J46: 10127820-0821LF; AMPHENOL_10127820-0821LF; PARTREV R; DigikeyPN 609-10127820-0821LF-ND
L7: 47uH; L_Sunlord_SWPA5040S; JLC C86617
R30: 100k; R_0402_1005Metric; JLC C25741
R31: 120k; R_0603_1608Metric; JLC C25808
R32: 22k; R_0603_1608Metric; JLC C31850
R77: 150R; R_0603_1608Metric; JLC C22808
R78: 1k; R_0805_2012Metric; JLC C17513
U10: xESC2; xESC2-mini; not fitted
U20, U23, U26: 2.54mm 2x2 socket; Dummy; JLC C92273
U32, U35: 2.54mm 1x6 socket; Dummy; JLC C7509518
U38: 2.54mm 1x9 socket; Dummy; JLC C7509520
U41: 2.54mm 1x5 socket; Dummy; JLC C7509517
U47: LV2862XDDC; SOT-23-6; JLC C3200285

Connections of its further copies:
/5V: C107.1, C108.1, D38.2 (A), J38.1, J46.4, L7.2, R31.1, U10.5V; also elsewhere on the board
/UART4.RX: R77.1; also elsewhere on the board
/UART4.TX: U10.14 (NCS/RX); also elsewhere on the board
/V_BATTERY: C53.1, C60.1, C72.1, C73.1, C74.1, C75.1, C77.1, C87.1, C90.1, C93.1, C96.1, C99.1, C104.1, C105.1, D17.2 (A2), R30.1, U10.VM (VIN), U47.5 (VIN); also elsewhere on the board
/subpcb_logic/AGPIO3: U10.11 (MISO); also elsewhere on the board
/xESC2/HALL_SENSOR.U: J38.2, J46.3, U10.4 (HALL_U)
/xESC2/HALL_SENSOR.V: J38.4, J46.2, U10.5 (HALL_V)
/xESC2/HALL_SENSOR.W: J38.6, J46.1, U10.6 (HALL_W)
/xESC2/PHASE.U: D18.2 (A2), D20.2 (A2), J46.7, U10.U
/xESC2/PHASE.V: D18.1 (A1), D19.2 (A2), J46.6, U10.V
/xESC2/PHASE.W: D19.1 (A1), D20.1 (A1), J46.5, U10.W
/xESC2/Temperature: J38.3, U10.3 (TEMPERATURE)
GND: C53.2, C60.2, C72.2, C73.2, C74.2, C75.2, C77.2, C87.2, C90.2, C93.2, C96.2, C99.2, C104.2, C105.2, C107.2, C108.2, D17.1 (A1), D30.2 (A), J38.5, J46.8, R32.2, R78.2, U10.GND, U47.2 (GND); also elsewhere on the board
unnamed: C106.1, D30.1 (K), L7.1, U47.6 (SW)
unnamed: D38.1 (K), R78.1
unnamed: R77.2, U10.12 (MOSI/TX)
unnamed: C106.2, U47.1 (CB)
unnamed: R31.2, R32.1, U47.3 (FB)
unnamed: R30.2, U47.4 (~SHDN)

Notes on the sheet:
Diode can be removed, when DCDC is not in the design
Connectors to join the PCBs when separated. All hierachical inputs need to be here in order to restore the connections.
Generates 5V on the sub-PCB. This is only necessary when splitting the PCB and using it in stand-alone operation. If you design an integrated solution, use the 5V from the main DCDC instead to save on cost and solution size.

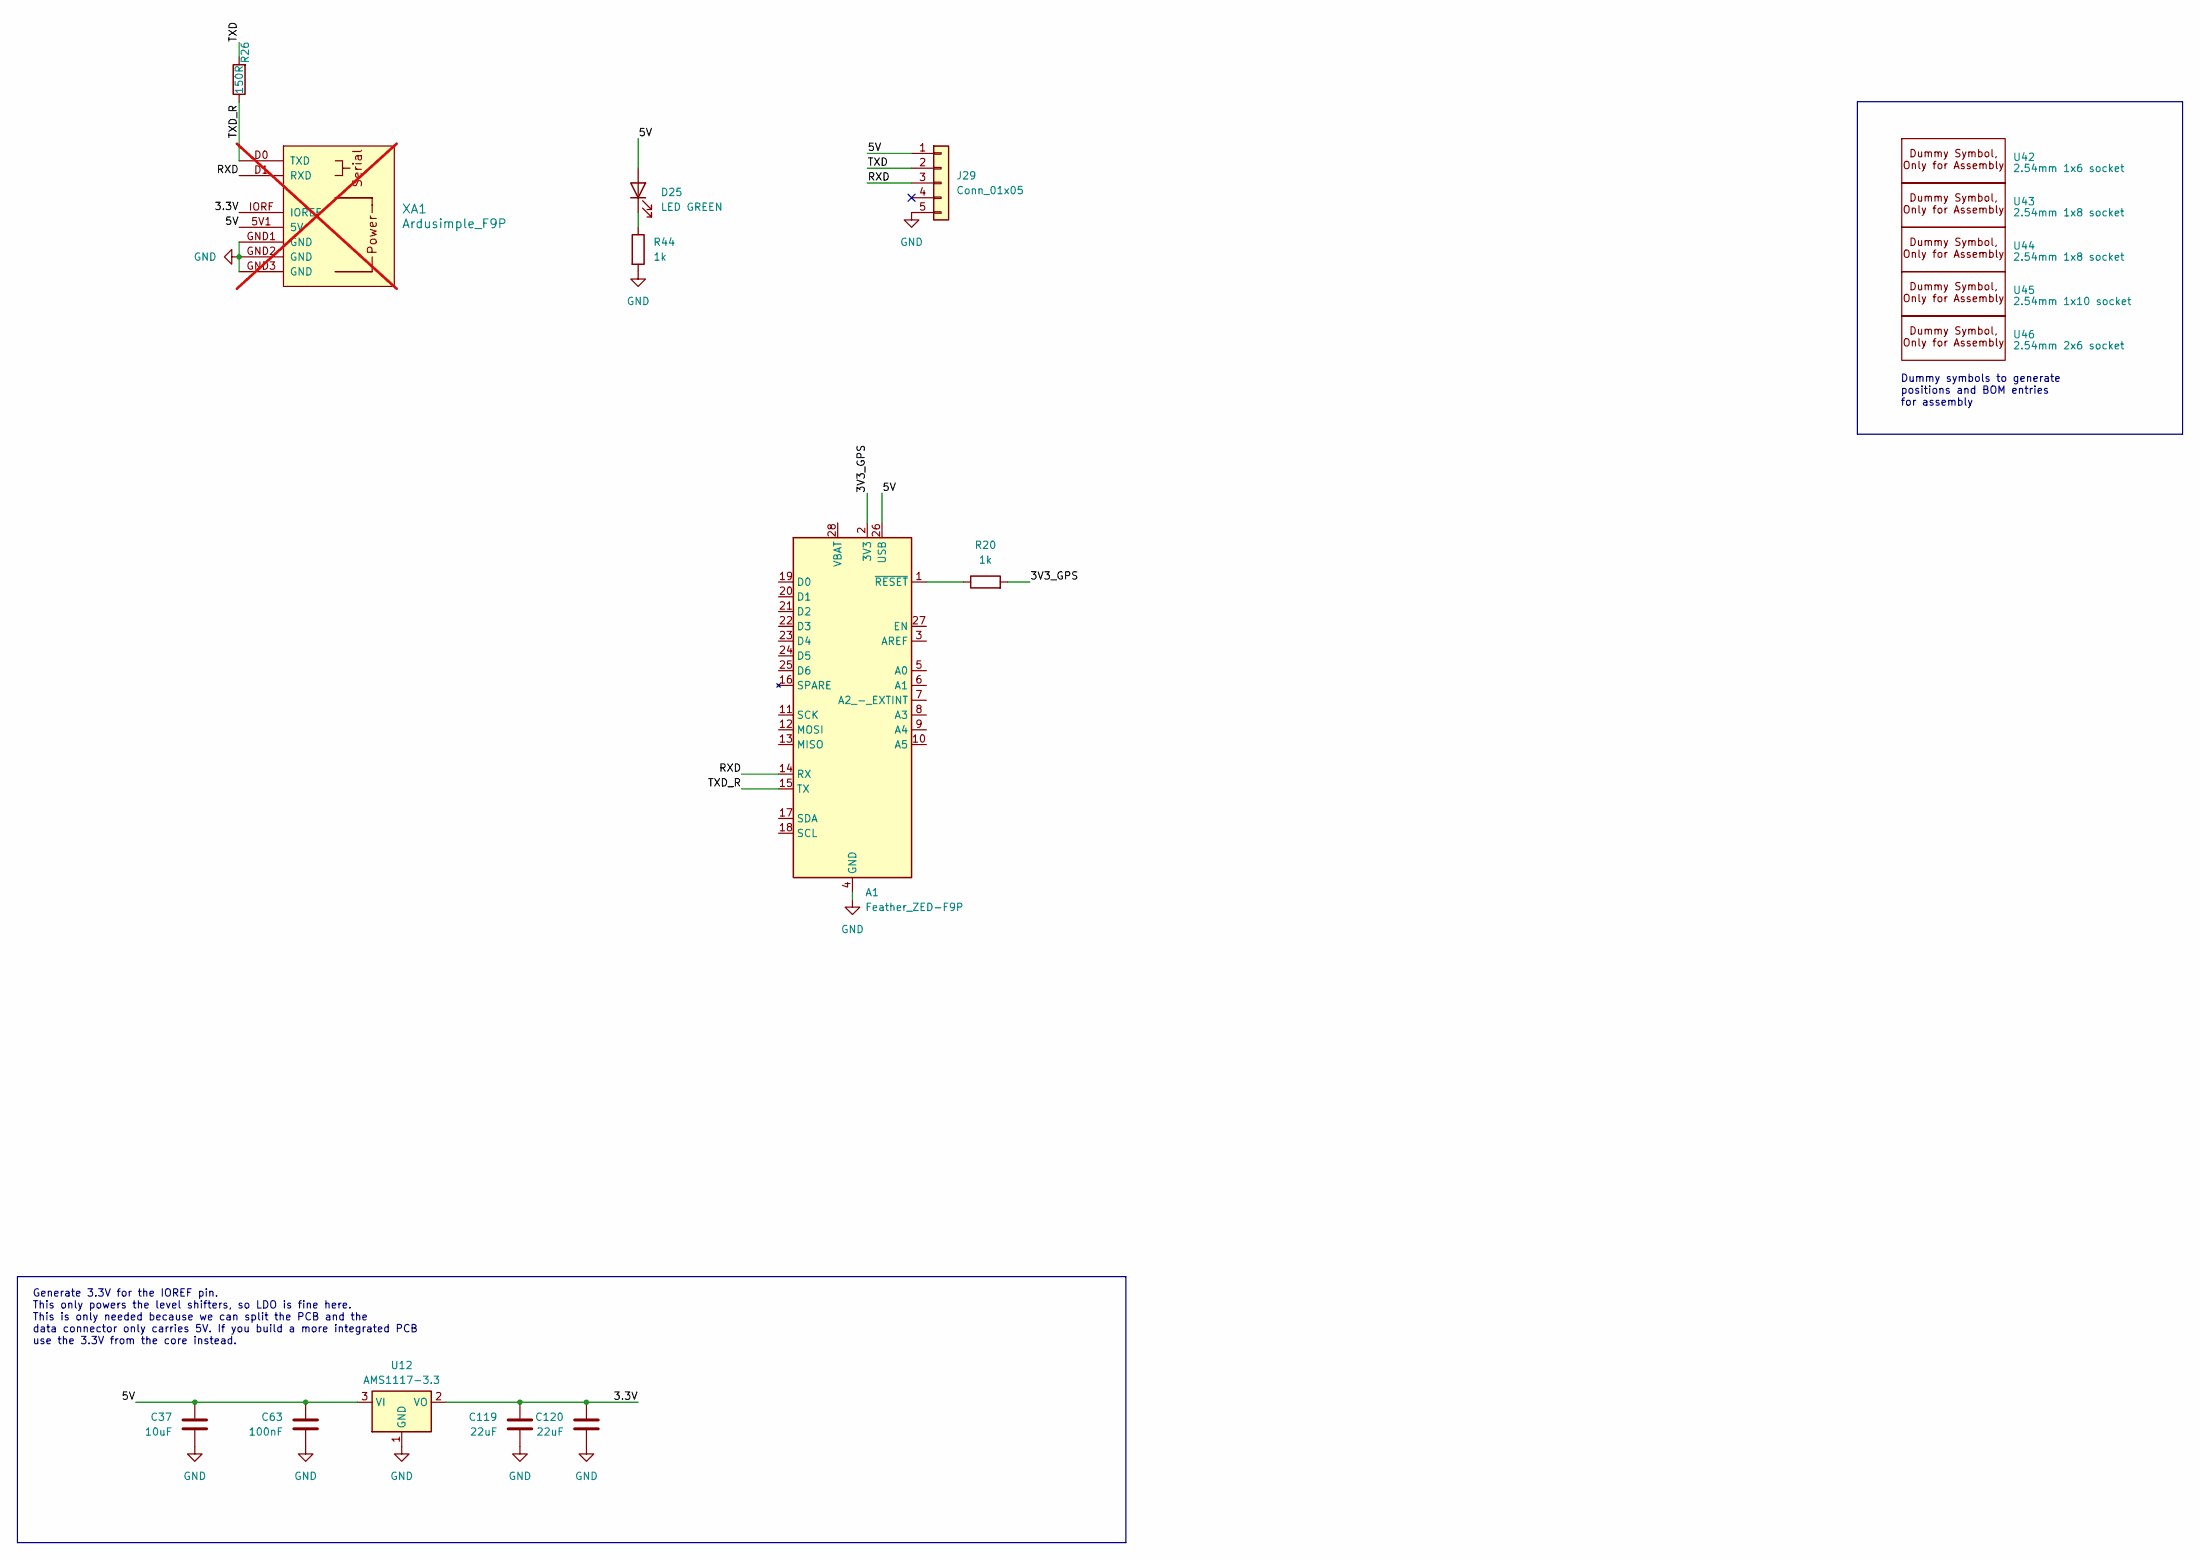
[picture p20: schematic GPS.kicad_sch]

Parts:
A1: Feather_ZED-F9P; Adafruit_Feather_WithMountingHoles
C37: 10uF; C_0402_1005Metric; JLC C15525
C63: 100nF; C_0402_1005Metric; JLC C307331
C119, C120: 22uF; C_0603_1608Metric; JLC C59461
D25: LED GREEN; LED_0805_2012Metric; JLC C2297
J29: Conn_01x05; JST_XH_B5B-XH-A_1x05_P2.50mm_Vertical; JLC C157991
R20, R44: 1k; R_0805_2012Metric; JLC C17513
R26: 150R; R_0603_1608Metric; JLC C22808
U12: AMS1117-3.3; SOT-223-3_TabPin2; JLC C6186
U42: 2.54mm 1x6 socket; Dummy; JLC C7509518
U43, U44: 2.54mm 1x8 socket; Dummy; JLC C7509515
U45: 2.54mm 1x10 socket; Dummy; JLC C7509514
U46: 2.54mm 2x6 socket; Dummy; JLC C718230
XA1: Ardusimple_F9P; Arduino_Uno_Shield_Ardusimple_Budget; not fitted

Connections:
/GPS/3.3V: C119.2, C120.2, U12.2 (VO), XA1.IORF (IOREF)
/GPS/3V3_GPS: A1.2 (3V3), R20.2
/GPS/5V: A1.26 (USB), C37.2, C63.2, D25.2 (A), J29.1, U12.3 (VI), XA1.5V1 (5V)
/GPS/RXD: A1.14 (RX), J29.3, XA1.D1 (RXD)
/GPS/TXD: J29.2, R26.2
/GPS/TXD_R: A1.15 (TX), R26.1, XA1.D0 (TXD)
GND: A1.4 (GND), C37.1, C63.1, C119.1, C120.1, J29.5, R44.2, U12.1 (GND), XA1.GND1 (GND), XA1.GND2 (GND), XA1.GND3 (GND); also elsewhere on the board
unnamed: A1.1 (~RESET), R20.1
unnamed: D25.1 (K), R44.1

Notes on the sheet:
Dummy symbols to generate positions and BOM entries for assembly
Generate 3.3V for the IOREF pin. This only powers the level shifters, so LDO is fine here. This is only needed because we can split the PCB and the data connector only carries 5V. If you build a more integrated PCB use the 3.3V from the core instead.

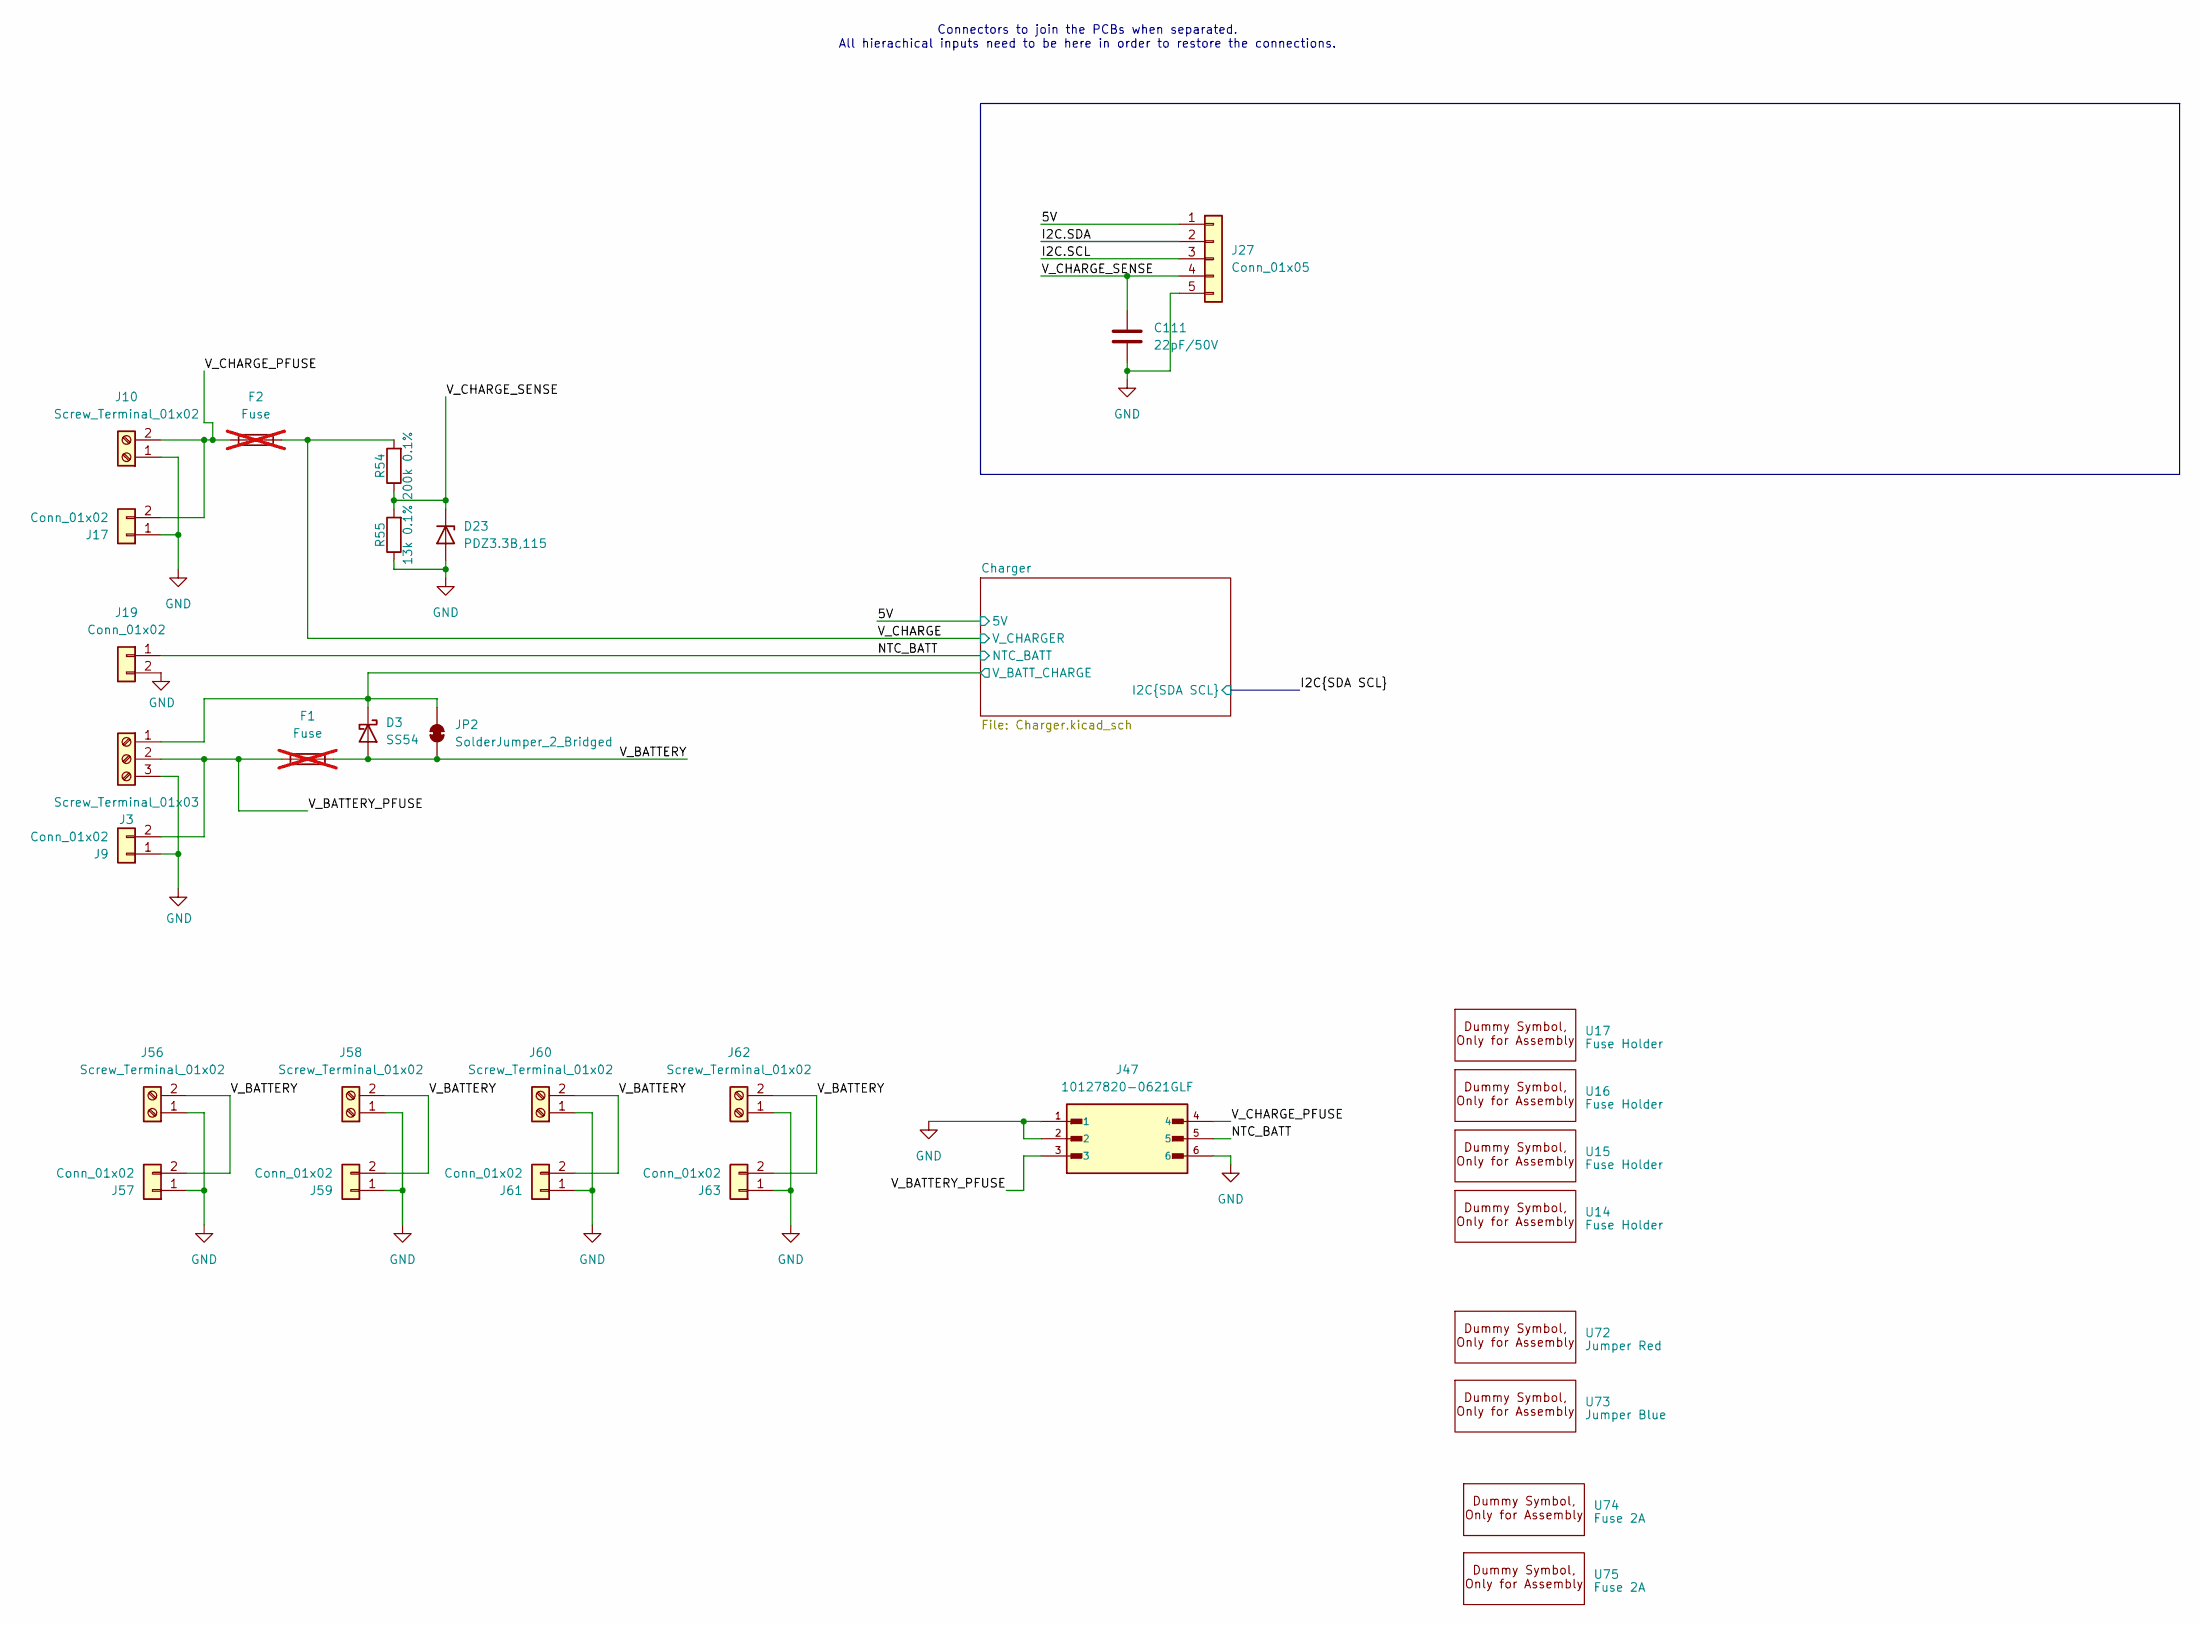
[picture p21: schematic subpcb_charger.kicad_sch]

Parts:
C111: 22pF/50V; C_0603_1608Metric; JLC C1653
D3: SS54; D_SMA; Part Number SB54AFC_R1_00001; Digikey 3757-SB54AFC_R1_00001CT-ND
D23: PDZ3.3B,115; D_SOD-323; JLC C426855
F1, F2: Fuse; Fuseholder5x20_horiz_open_inline_Type-I; not fitted
J3: Screw_Terminal_01x03; TerminalBlock_Phoenix_MKDS-1,5-3-5.08_1x03_P5.08mm_Horizont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; JLC C557666
J9, J17: Conn_01x02; AMASS_XT30U-M_1x02_P5.0mm_Vertical; JLC C99101
J10, J56, J58, J60, J62: Screw_Terminal_01x02; TerminalBlock_Phoenix_MKDS-1,5-2-5.08_1x02_P5.08mm_Horizont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; JLC C557665
J19: Conn_01x02; JST_XH_B2B-XH-A_1x02_P2.50mm_Vertical; JLC C2910525
J27: Conn_01x05; JST_XH_B5B-XH-A_1x05_P2.50mm_Vertical; JLC C157991
J47: 10127820-0621GLF; AMPHENOL_10127820-0621GLF; PARTREV R; Digikey PN 609-10127820-0621GLF-ND
J57, J59, J61, J63: Conn_01x02; AMASS_XT30U-F_1x02_P5.0mm_Vertical; JLC C99102
JP2: SolderJumper_2_Bridged; SolderJumper-2_P1.3mm_Bridged2Bar_Pad1.0x1.5mm
R54: 200k 0.1%; R_0402_1005Metric; JLC C728556
R55: 13k 0.1%; R_0402_1005Metric; JLC C852524
U14, U15, U16, U17: Fuse Holder; Dummy; JLC C3130
U72: Jumper Red; Dummy; JLC C20417889
U73: Jumper Blue; Dummy; JLC C20417886
U74, U75: Fuse 2A; Dummy; JLC C356459

Connections:
/subpcb_charger/5V: J27.1; also elsewhere on the board
/subpcb_charger/Charger/V_BATT_CHARGE: D3.1 (K), J3.1, JP2.2 (B); also elsewhere on the board
/subpcb_charger/I2C.SCL: J27.3; also elsewhere on the board
/subpcb_charger/I2C.SDA: J27.2; also elsewhere on the board
/subpcb_charger/NTC_BATT: J19.1, J47.5; also elsewhere on the board
/subpcb_charger/V_BATTERY: D3.2 (A), F1.2, J56.2, J57.2, J58.2, J59.2, J60.2, J61.2, J62.2, J63.2, JP2.1 (A)
/subpcb_charger/V_BATTERY_PFUSE: F1.1, J3.2, J9.2, J47.3
/subpcb_charger/V_CHARGE: F2.2, R54.2; also elsewhere on the board
/subpcb_charger/V_CHARGE_PFUSE: F2.1, J10.2, J17.2, J47.4
/subpcb_charger/V_CHARGE_SENSE: C111.1, D23.1 (K), J27.4, R54.1, R55.2
GND: C111.2, D23.2 (A), J3.3, J9.1, J10.1, J17.1, J19.2, J27.5, J47.1, J47.2, J47.6, J56.1, J57.1, J58.1, J59.1, J60.1, J61.1, J62.1, J63.1, R55.1; also elsewhere on the board

Notes on the sheet:
Connectors to join the PCBs when separated. All hierachical inputs need to be here in order to restore the connections.

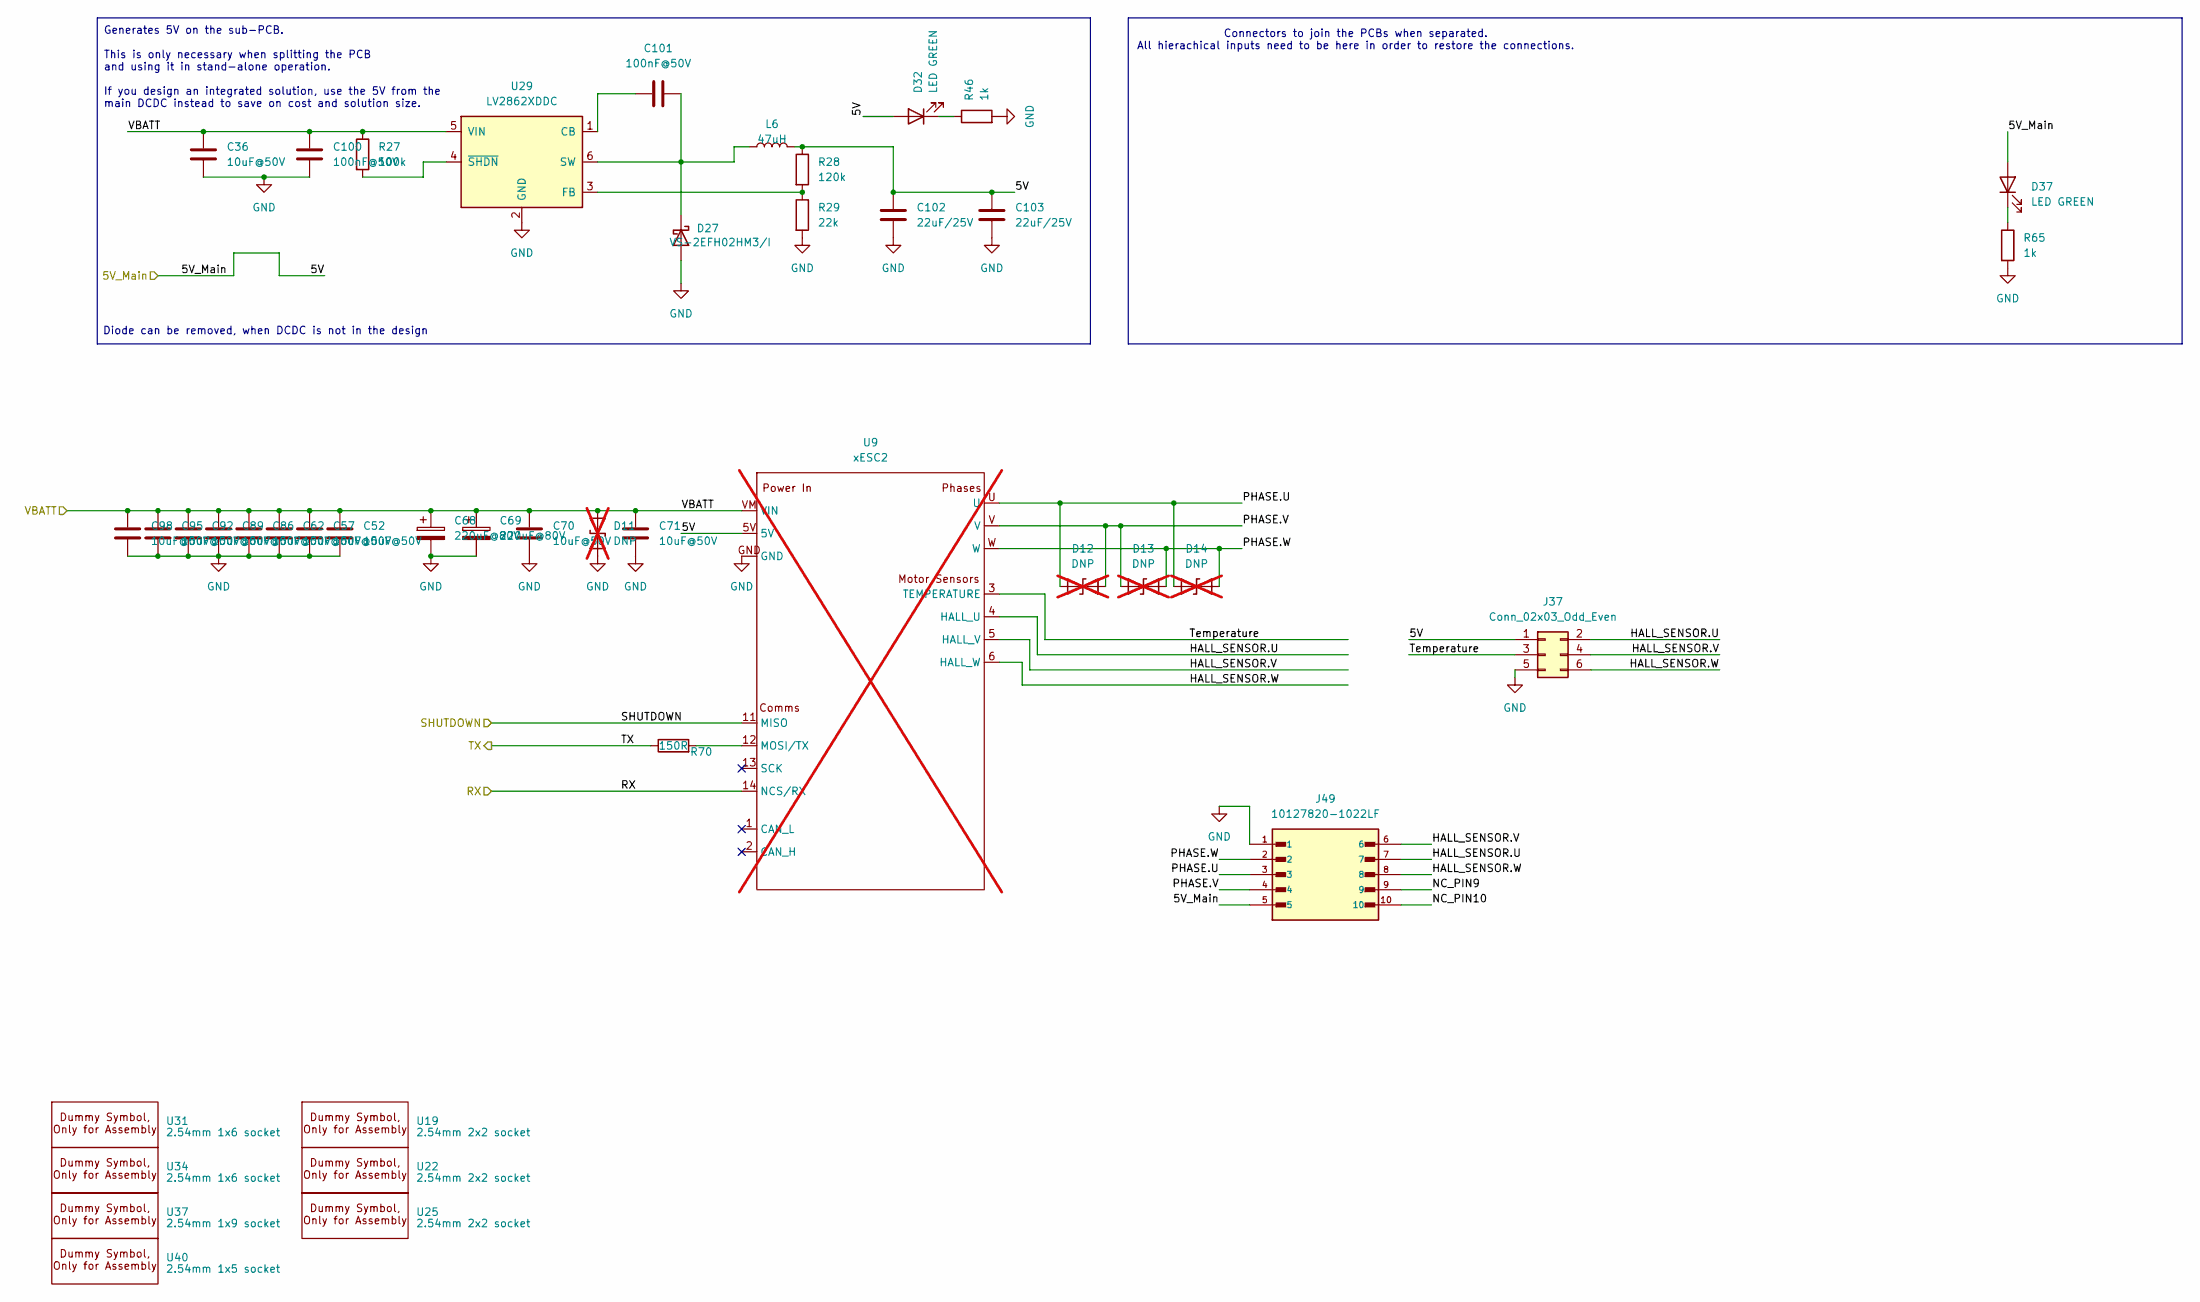
[picture p22: schematic xESC_mower.kicad_sch]

Parts:
C36, C52, C57, C62, C70, C71, C86, C89, C92, C95, C98: 10uF@50V; C_1206_3216Metric; JLC C13585
C68, C69: 220uF@80V; CP_Radial_D10.0mm_P5.00mm; JLC C106516
C100, C101: 100nF@50V; C_0402_1005Metric; JLC C307331
C102, C103: 22uF/25V; C_0805_2012Metric; JLC C45783
D11: DNP; D_SMA; not fitted
D12, D13, D14: DNP; D_SMB; not fitted
D27: VS-2EFH02HM3/I; D_SMF; JLC C241868
D32, D37: LED GREEN; LED_0805_2012Metric; JLC C2297
J37: Conn_02x03_Odd_Even; PinHeader_2x03_P2.54mm_Vertical; JLC C5383104
J49: 10127820-1022LF; AMPHENOL_10127820-1022LF; PARTREV R; Digikey PN 609-4876-ND
L6: 47uH; L_Sunlord_SWPA5040S; JLC C86617
R27: 100k; R_0402_1005Metric; JLC C25741
R28: 120k; R_0603_1608Metric; JLC C25808
R29: 22k; R_0603_1608Metric; JLC C31850
R46, R65: 1k; R_0805_2012Metric; JLC C17513
R70: 150R; R_0603_1608Metric; JLC C22808
U9: xESC2; xESC2-mini; not fitted
U19, U22, U25: 2.54mm 2x2 socket; Dummy; JLC C92273
U29: LV2862XDDC; SOT-23-6; JLC C3200285
U31, U34: 2.54mm 1x6 socket; Dummy; JLC C7509518
U37: 2.54mm 1x9 socket; Dummy; JLC C7509520
U40: 2.54mm 1x5 socket; Dummy; JLC C7509517

Connections:
/5V: C102.1, C103.1, D32.2 (A), D37.2 (A), J37.1, J49.5, L6.2, R28.1, U9.5V; also elsewhere on the board
/UART2.RX: R70.1; also elsewhere on the board
/UART2.TX: U9.14 (NCS/RX); also elsewhere on the board
/V_BATTERY: C36.1, C52.1, C57.1, C62.1, C68.1, C69.1, C70.1, C71.1, C86.1, C89.1, C92.1, C95.1, C98.1, C100.1, D11.2 (A2), R27.1, U9.VM (VIN), U29.5 (VIN); also elsewhere on the board
/subpcb_logic/AGPIO2: U9.11 (MISO); also elsewhere on the board
/xESC_motor/HALL_SENSOR.U: J37.2, J49.7, U9.4 (HALL_U)
/xESC_motor/HALL_SENSOR.V: J37.4, J49.6, U9.5 (HALL_V)
/xESC_motor/HALL_SENSOR.W: J37.6, J49.8, U9.6 (HALL_W)
/xESC_motor/NC_PIN9: J49.9
/xESC_motor/NC_PIN10: J49.10
/xESC_motor/PHASE.U: D12.2 (A2), D14.2 (A2), J49.3, U9.U
/xESC_motor/PHASE.V: D12.1 (A1), D13.2 (A2), J49.4, U9.V
/xESC_motor/PHASE.W: D13.1 (A1), D14.1 (A1), J49.2, U9.W
/xESC_motor/Temperature: J37.3, U9.3 (TEMPERATURE)
GND: C36.2, C52.2, C57.2, C62.2, C68.2, C69.2, C70.2, C71.2, C86.2, C89.2, C92.2, C95.2, C98.2, C100.2, C102.2, C103.2, D11.1 (A1), D27.2 (A), J37.5, J49.1, R29.2, R46.2, R65.2, U9.GND, U29.2 (GND); also elsewhere on the board
unnamed: C101.1, D27.1 (K), L6.1, U29.6 (SW)
unnamed: D32.1 (K), R46.1
unnamed: D37.1 (K), R65.1
unnamed: R70.2, U9.12 (MOSI/TX)
unnamed: C101.2, U29.1 (CB)
unnamed: R28.2, R29.1, U29.3 (FB)
unnamed: R27.2, U29.4 (~SHDN)

Notes on the sheet:
Diode can be removed, when DCDC is not in the design
Connectors to join the PCBs when separated. All hierachical inputs need to be here in order to restore the connections.
Generates 5V on the sub-PCB. This is only necessary when splitting the PCB and using it in stand-alone operation. If you design an integrated solution, use the 5V from the main DCDC instead to save on cost and solution size.
