laberge1/hw-openmower-universal/hw-openmower-universal.kicad_pcb

## KiCad design hw-openmower-universal.kicad_pcb (continued)

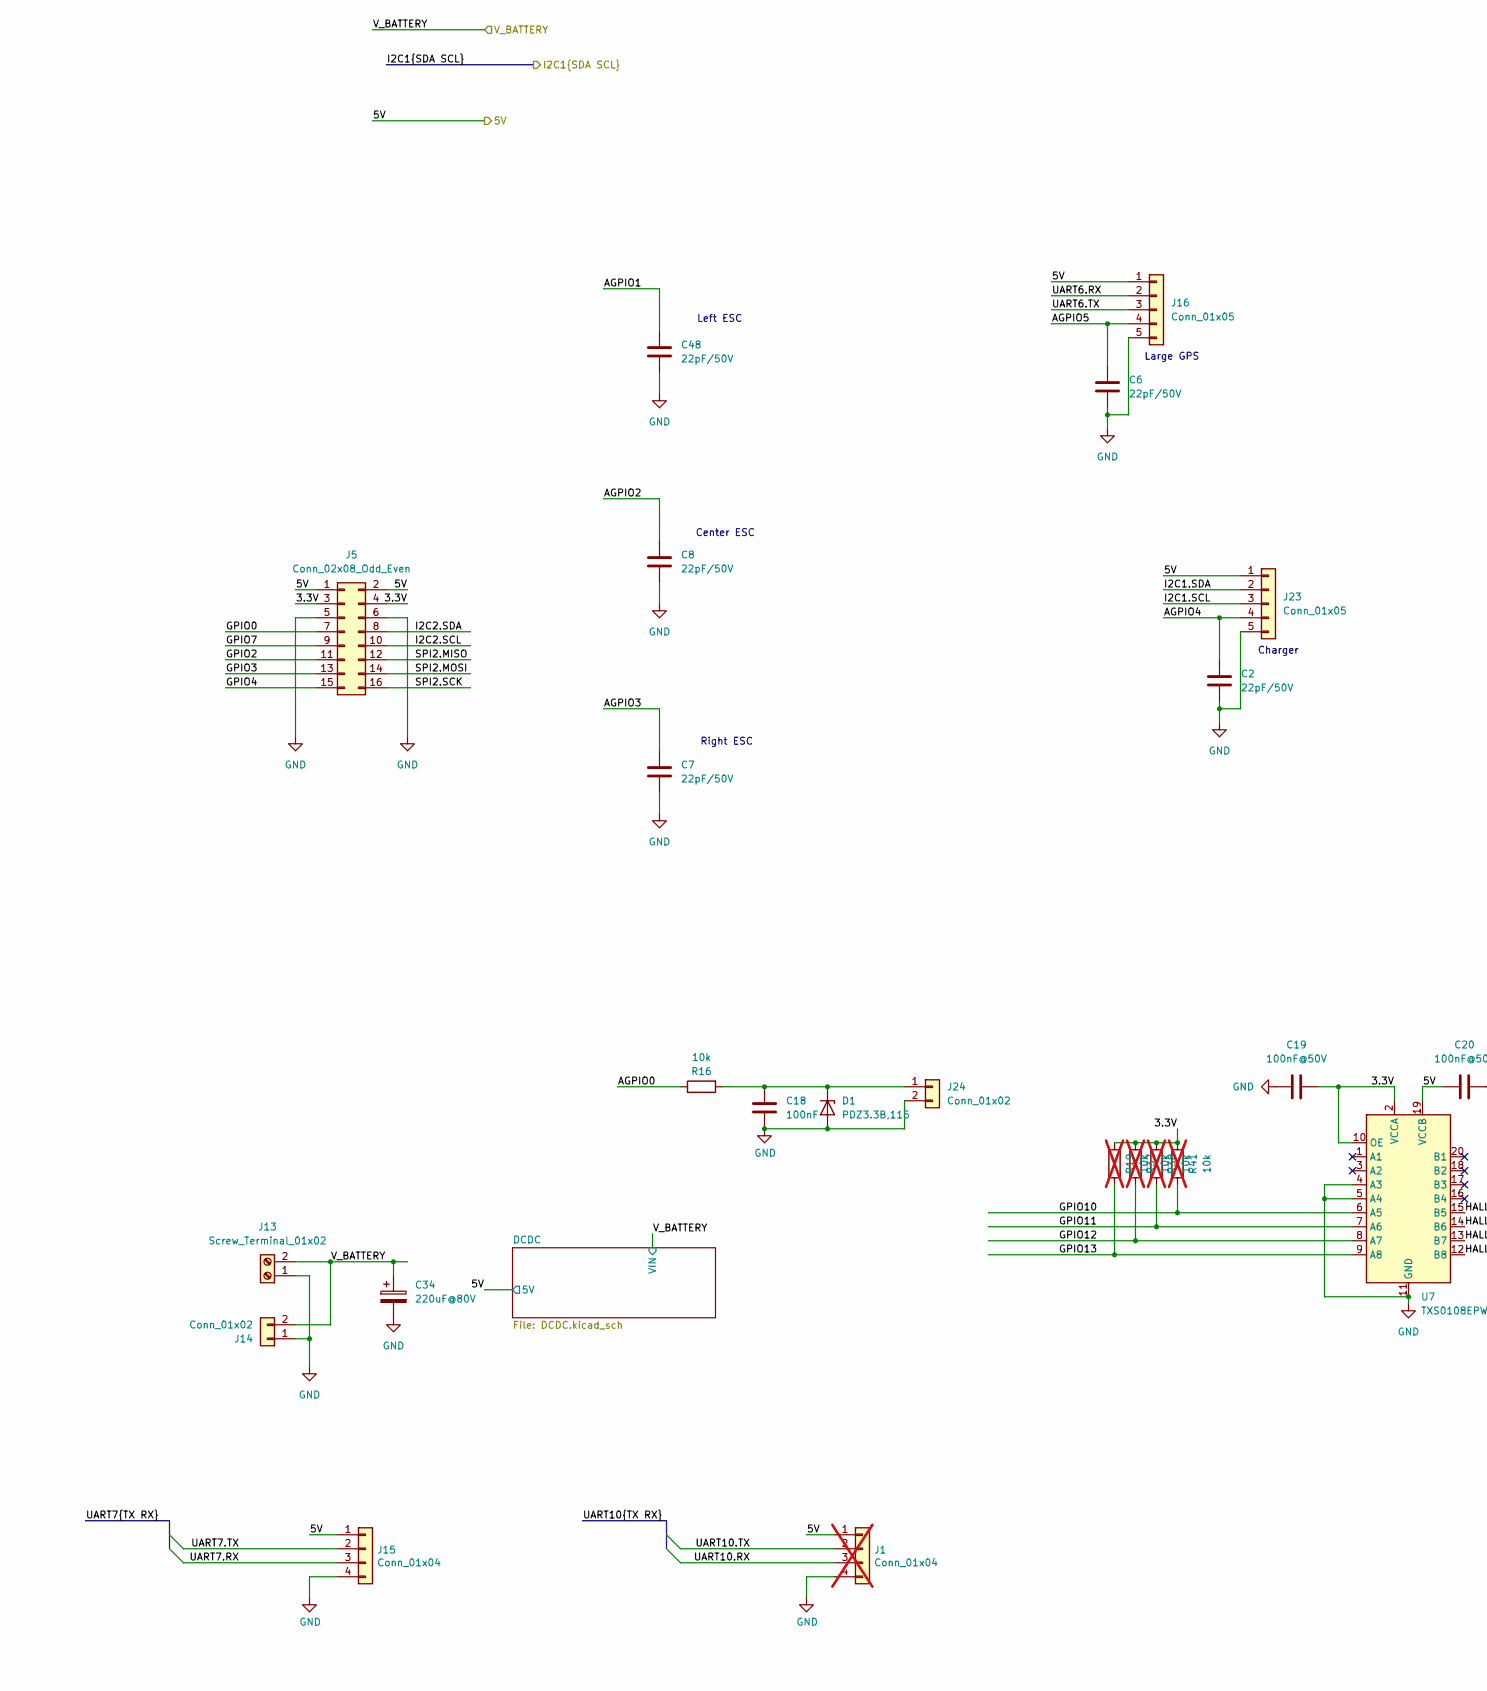
[picture p23: schematic subpcb_logic.kicad_sch, part in row 1, column 1]

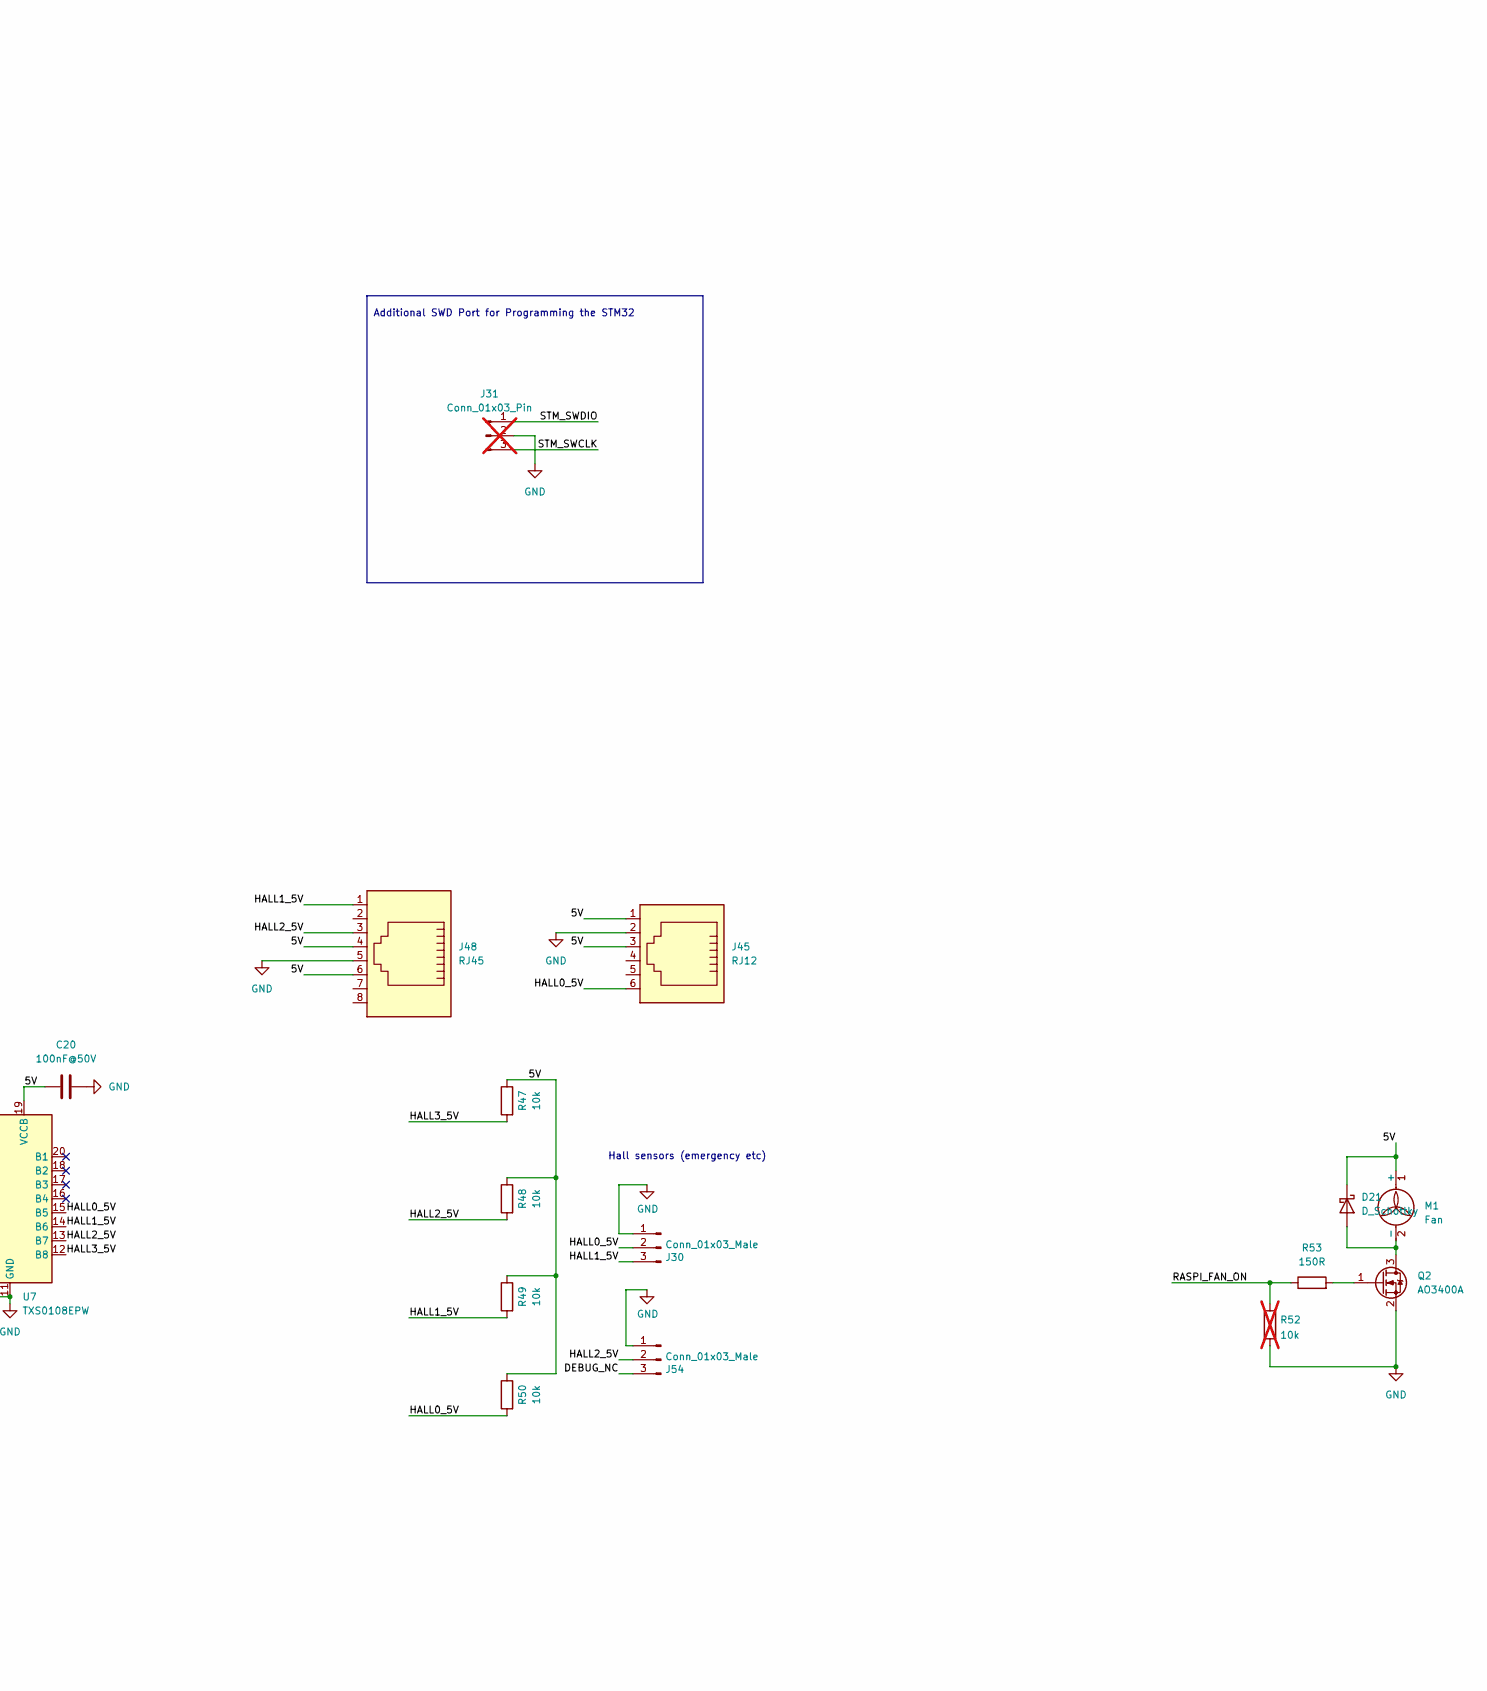
[picture p24: schematic subpcb_logic.kicad_sch, part in row 1, column 2]

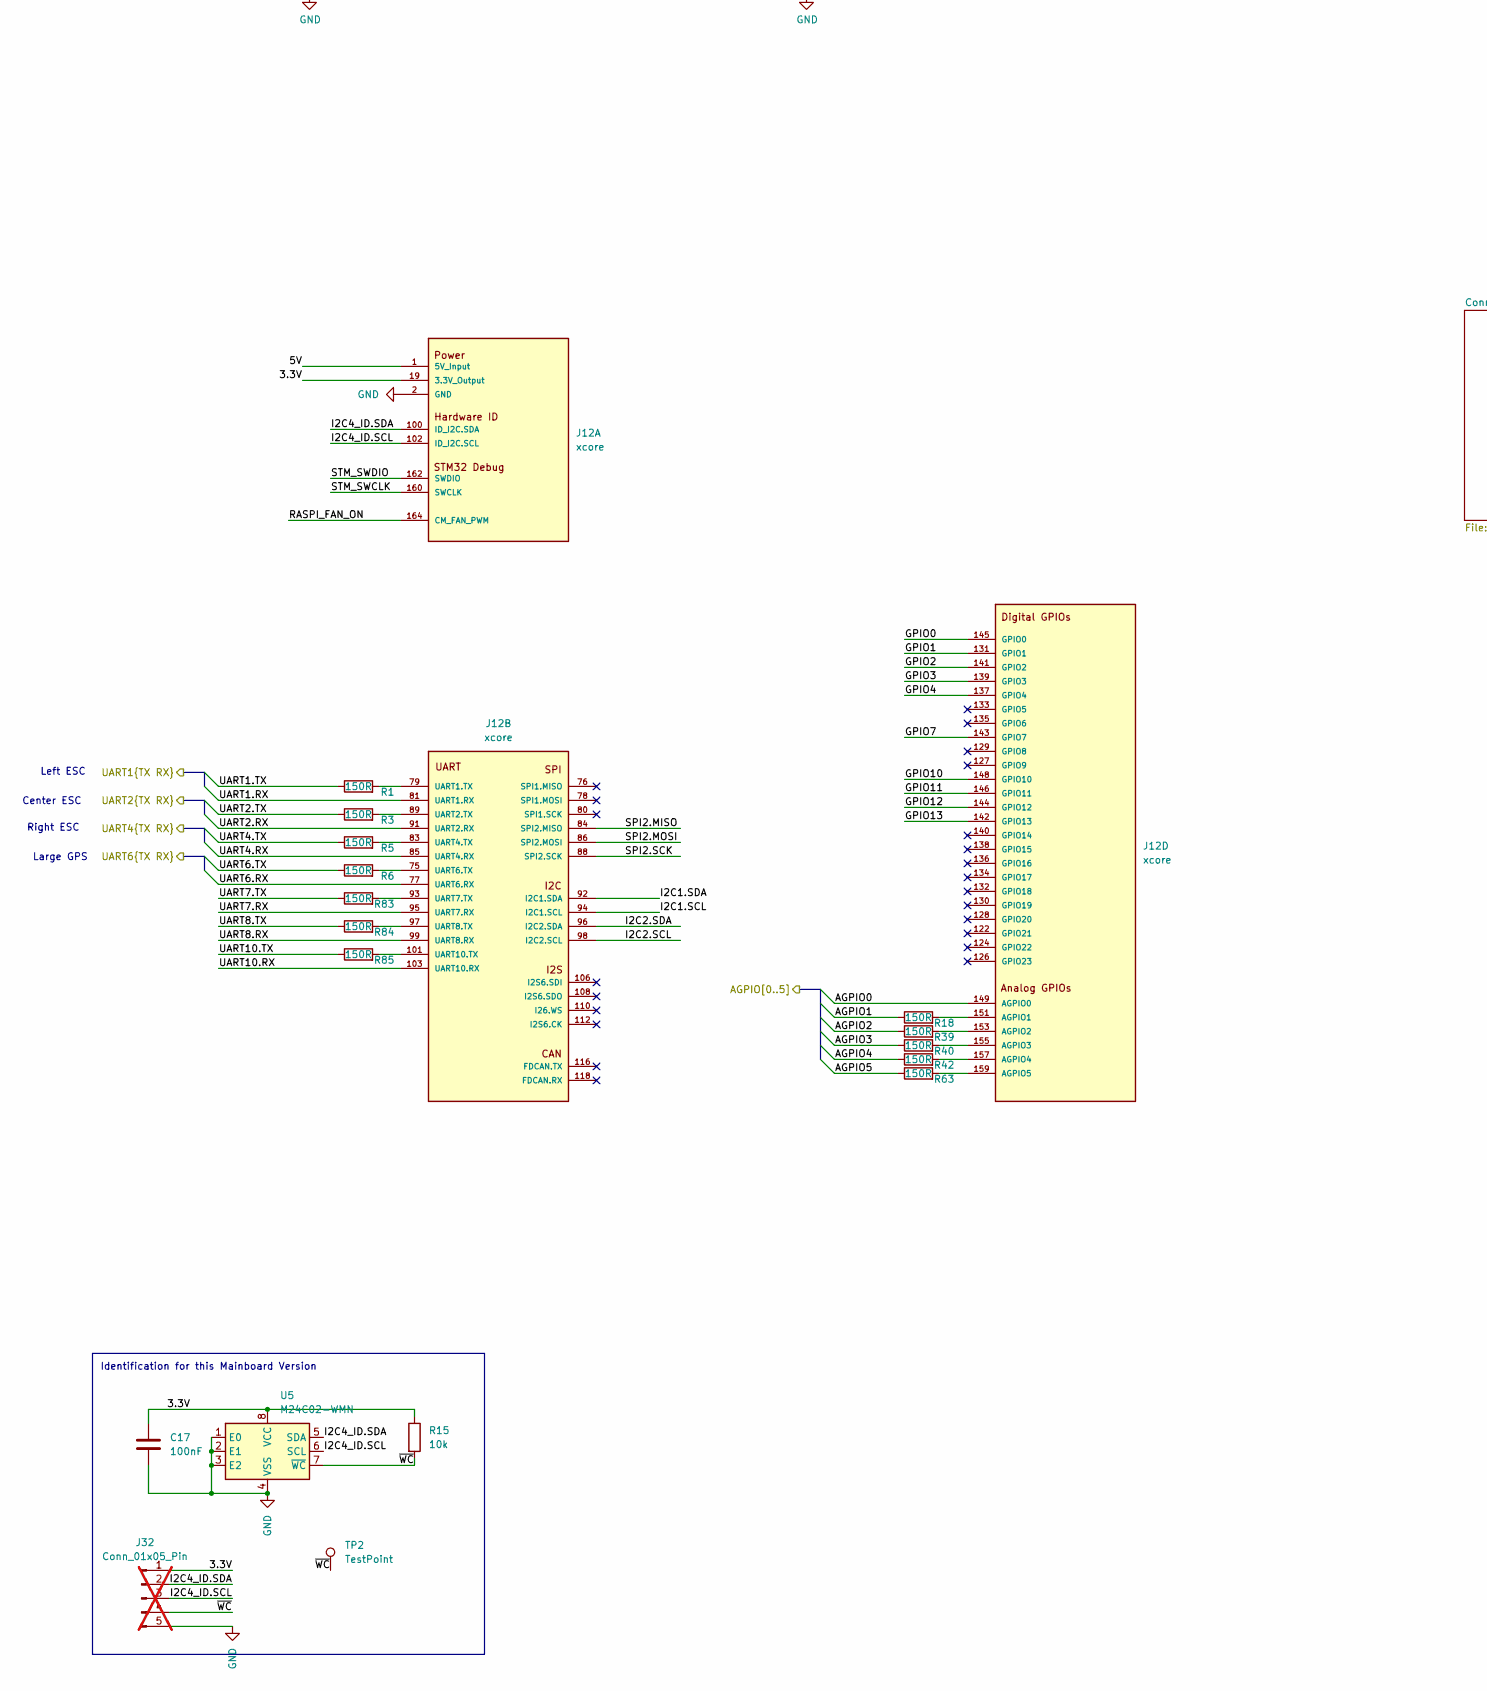
[picture p25: schematic subpcb_logic.kicad_sch, part in row 2, column 1]

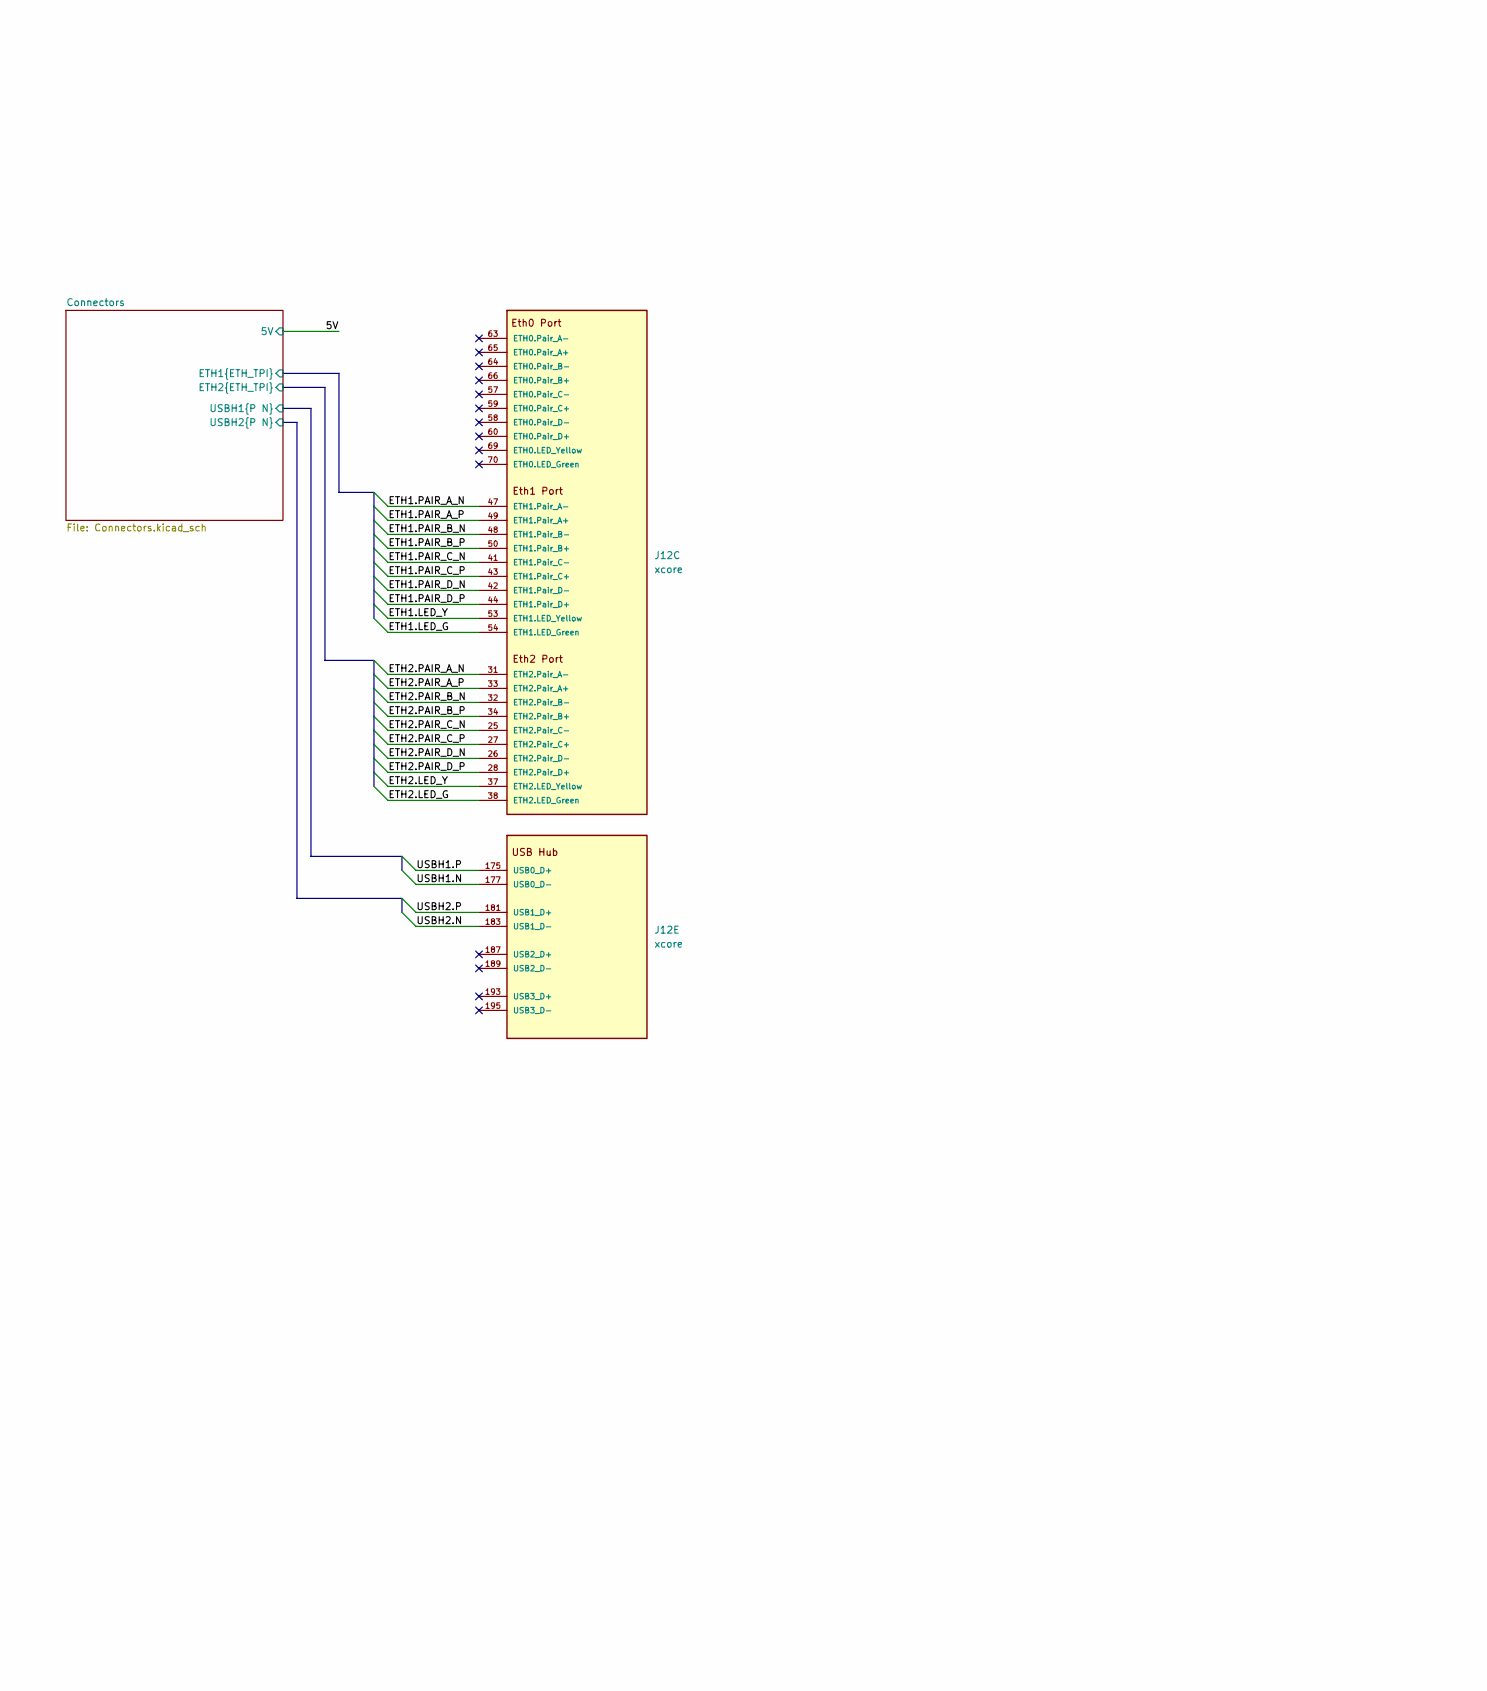
[picture p26: schematic subpcb_logic.kicad_sch, part in row 2, column 2]

Parts:
C2, C6, C7, C8, C48: 22pF/50V; C_0603_1608Metric; JLC C1653
C17, C18: 100nF; C_0402_1005Metric; JLC C307331
C19, C20: 100nF@50V; C_0402_1005Metric; JLC C307331
C34: 220uF@80V; CP_Radial_D10.0mm_P5.00mm; JLC C106516
D1: PDZ3.3B,115; D_SOD-323; JLC C426855
D21: D_Schottky; D_SOD-123F; Part Number AS160-M; Digikey 3757-SS0520_R1_00001CT-ND
J1: Conn_01x04; JST_XH_B4B-XH-A_1x04_P2.50mm_Vertical; Part Number B4B-XH-A(LF)(SN); Digikey 455-2249-ND; not fitted
J5: Conn_02x08_Odd_Even; PinHeader_2x08_P2.54mm_Vertical; JLC C779499
J12: xcore; JLC C306045
J13: Screw_Terminal_01x02; TerminalBlock_Phoenix_MKDS-1,5-2-5.08_1x02_P5.08mm_Horizont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; JLC C557665
J14: Conn_01x02; AMASS_XT30U-M_1x02_P5.0mm_Vertical; JLC C99101
J15: Conn_01x04; JST_XH_B4B-XH-A_1x04_P2.50mm_Vertical; Part Number B4B-XH-A(LF)(SN); Digikey 455-2249-ND
J16, J23: Conn_01x05; JST_XH_B5B-XH-A_1x05_P2.50mm_Vertical; JLC C157991
J24: Conn_01x02; JST_XH_B2B-XH-A_1x02_P2.50mm_Vertical; Part Number B2B-XH-A-GU; Digikey 455-2946-ND
J30, J54: Conn_01x03_Male; PinHeader_1x03_P2.54mm_Vertical; Part Number B3B-XH-AM(LF)(SN); Digikey 455-2231-ND
J31: Conn_01x03_Pin; PinHeader_1x03_P2.54mm_Vertical; not fitted
J32: Conn_01x05_Pin; PinHeader_1x05_P2.54mm_Vertical; not fitted
J45: RJ12; CONN_85513-5002_MOL; Digikey PN WM3789CT-ND
J48: RJ45; RJ45_Molex_0855135013_Vertical; Digikey PN WM3553CT-ND
M1: Fan; PinHeader_1x02_P2.54mm_Vertical; Part Number DZ254R-11-02-63; JLC C2935908
Q2: AO3400A; SOT-23; Part Number AP2300; Digikey BSS138K-13DICT-ND
R1, R3, R5, R6, R18, R39, R40, R42, R63, R83, R84, R85: 150R; R_0603_1608Metric; JLC C22808
R15, R16, R47, R48, R49, R50: 10k; R_0402_1005Metric; JLC C25744
R19, R37, R38, R41: 10k; R_0402_1005Metric; JLC C25744; not fitted
R52: 10k; R_0805_2012Metric_Pad1.20x1.40mm_HandSolder; Part Number RMCF0805FG10K0; Digikey 738-RMCF0805FG10K0CT-ND; not fitted
R53: 150R; R_0805_2012Metric_Pad1.20x1.40mm_HandSolder; Part Number RC0805FR-07150RL; Digikey 311-150CRCT-ND
TP2: TestPoint; Pin_D1.4mm_L8.5mm_W2.8mm_FlatFork
U5: M24C02-WMN; SOIC-8_3.9x4.9mm_P1.27mm; JLC C7562
U7: TXS0108EPW; TSSOP-20_4.4x6.5mm_P0.65mm; JLC C17206

Connections:
/5V: C20.1, D21.1 (K), J1.1, J5.1, J5.2, J12.1 (5V_Input), J12.3 (5V_Input), J12.5 (5V_Input), J12.7 (5V_Input), J12.9 (5V_Input), J12.11 (5V_Input), J12.13 (5V_Input), J12.15 (5V_Input), J12.17 (5V_Input), J15.1, J16.1, J23.1, J45.1, J45.3, J48.4, J48.6, M1.1 (+), R47.1, R48.1, R49.1, R50.1, U7.19 (VCCB); also elsewhere on the board
/UART1.RX: J12.81 (UART1.RX); also elsewhere on the board
/UART1.TX: R1.1; also elsewhere on the board
/UART2.RX: J12.91 (UART2.RX); also elsewhere on the board
/UART2.TX: R3.1; also elsewhere on the board
/UART4.RX: J12.85 (UART4.RX); also elsewhere on the board
/UART4.TX: R5.1; also elsewhere on the board
/V_BATTERY: C34.1, J13.2, J14.2; also elsewhere on the board
/subpcb_logic/3.3V: C17.1, C19.1, J5.3, J5.4, J12.19 (3.3V_Output), J12.21 (3.3V_Output), J32.1, R15.1, R19.1, R37.1, R38.1, R41.1, U5.8 (VCC), U7.2 (VCCA), U7.10 (OE)
/subpcb_logic/AGPIO0: J12.149 (AGPIO0), R16.1
/subpcb_logic/AGPIO1: C48.1, R18.1; also elsewhere on the board
/subpcb_logic/AGPIO2: C8.1, R39.1; also elsewhere on the board
/subpcb_logic/AGPIO3: C7.1, R40.1; also elsewhere on the board
/subpcb_logic/AGPIO4: C2.1, J23.4, R42.1
/subpcb_logic/AGPIO5: C6.1, J16.4, R63.1
/subpcb_logic/Connectors/ETH1.LED_G: J12.54 (ETH1.LED_Green); also elsewhere on the board
/subpcb_logic/Connectors/ETH1.LED_Y: J12.53 (ETH1.LED_Yellow); also elsewhere on the board
/subpcb_logic/Connectors/ETH1.PAIR_A_N: J12.47 (ETH1.Pair_A-); also elsewhere on the board
/subpcb_logic/Connectors/ETH1.PAIR_A_P: J12.49 (ETH1.Pair_A+); also elsewhere on the board
/subpcb_logic/Connectors/ETH1.PAIR_B_N: J12.48 (ETH1.Pair_B-); also elsewhere on the board
/subpcb_logic/Connectors/ETH1.PAIR_B_P: J12.50 (ETH1.Pair_B+); also elsewhere on the board
/subpcb_logic/Connectors/ETH1.PAIR_C_N: J12.41 (ETH1.Pair_C-); also elsewhere on the board
/subpcb_logic/Connectors/ETH1.PAIR_C_P: J12.43 (ETH1.Pair_C+); also elsewhere on the board
/subpcb_logic/Connectors/ETH1.PAIR_D_N: J12.42 (ETH1.Pair_D-); also elsewhere on the board
/subpcb_logic/Connectors/ETH1.PAIR_D_P: J12.44 (ETH1.Pair_D+); also elsewhere on the board
/subpcb_logic/Connectors/ETH2.LED_G: J12.38 (ETH2.LED_Green); also elsewhere on the board
/subpcb_logic/Connectors/ETH2.LED_Y: J12.37 (ETH2.LED_Yellow); also elsewhere on the board
/subpcb_logic/Connectors/ETH2.PAIR_A_N: J12.31 (ETH2.Pair_A-); also elsewhere on the board
/subpcb_logic/Connectors/ETH2.PAIR_A_P: J12.33 (ETH2.Pair_A+); also elsewhere on the board
/subpcb_logic/Connectors/ETH2.PAIR_B_N: J12.32 (ETH2.Pair_B-); also elsewhere on the board
/subpcb_logic/Connectors/ETH2.PAIR_B_P: J12.34 (ETH2.Pair_B+); also elsewhere on the board
/subpcb_logic/Connectors/ETH2.PAIR_C_N: J12.25 (ETH2.Pair_C-); also elsewhere on the board
/subpcb_logic/Connectors/ETH2.PAIR_C_P: J12.27 (ETH2.Pair_C+); also elsewhere on the board
/subpcb_logic/Connectors/ETH2.PAIR_D_N: J12.26 (ETH2.Pair_D-); also elsewhere on the board
/subpcb_logic/Connectors/ETH2.PAIR_D_P: J12.28 (ETH2.Pair_D+); also elsewhere on the board
/subpcb_logic/Connectors/USBH1.N: J12.177 (USB0_D-); also elsewhere on the board
/subpcb_logic/Connectors/USBH1.P: J12.175 (USB0_D+); also elsewhere on the board
/subpcb_logic/Connectors/USBH2.N: J12.183 (USB1_D-); also elsewhere on the board
/subpcb_logic/Connectors/USBH2.P: J12.181 (USB1_D+); also elsewhere on the board
/subpcb_logic/DEBUG_NC: J54.3
/subpcb_logic/GPIO0: J5.7, J12.145 (GPIO0)
/subpcb_logic/GPIO1: J12.131 (GPIO1)
/subpcb_logic/GPIO2: J5.11, J12.141 (GPIO2)
/subpcb_logic/GPIO3: J5.13, J12.139 (GPIO3)
/subpcb_logic/GPIO4: J5.15, J12.137 (GPIO4)
/subpcb_logic/GPIO7: J5.9, J12.143 (GPIO7)
/subpcb_logic/GPIO10: J12.148 (GPIO10), R41.2, U7.6 (A5)
/subpcb_logic/GPIO11: J12.146 (GPIO11), R38.2, U7.7 (A6)
/subpcb_logic/GPIO12: J12.144 (GPIO12), R37.2, U7.8 (A7)
/subpcb_logic/GPIO13: J12.142 (GPIO13), R19.2, U7.9 (A8)
/subpcb_logic/HALL0_5V: J30.2, J45.6, R50.2, U7.15 (B5)
/subpcb_logic/HALL1_5V: J30.3, J48.1, R49.2, U7.14 (B6)
/subpcb_logic/HALL2_5V: J48.3, J54.2, R48.2, U7.13 (B7)
/subpcb_logic/HALL3_5V: R47.2, U7.12 (B8)
/subpcb_logic/I2C1.SCL: J12.94 (I2C1.SCL), J23.3
/subpcb_logic/I2C1.SDA: J12.92 (I2C1.SDA), J23.2
/subpcb_logic/I2C2.SCL: J5.10, J12.98 (I2C2.SCL)
/subpcb_logic/I2C2.SDA: J5.8, J12.96 (I2C2.SDA)
/subpcb_logic/I2C4_ID.SCL: J12.102 (ID_I2C.SCL), J32.3, U5.6 (SCL)
/subpcb_logic/I2C4_ID.SDA: J12.100 (ID_I2C.SDA), J32.2, U5.5 (SDA)
/subpcb_logic/RASPI_FAN_ON: J12.164 (CM_FAN_PWM), R52.2, R53.1
/subpcb_logic/SPI2.MISO: J5.12, J12.84 (SPI2.MISO)
/subpcb_logic/SPI2.MOSI: J5.14, J12.86 (SPI2.MOSI)
/subpcb_logic/SPI2.SCK: J5.16, J12.88 (SPI2.SCK)
/subpcb_logic/STM_SWCLK: J12.160 (SWCLK), J31.3
/subpcb_logic/STM_SWDIO: J12.162 (SWDIO), J31.1
/subpcb_logic/UART6.RX: J12.77 (UART6.RX), J16.2
/subpcb_logic/UART6.TX: J16.3, R6.1
/subpcb_logic/UART7.RX: J12.95 (UART7.RX), J15.3
/subpcb_logic/UART7.TX: J15.2, R83.1
/subpcb_logic/UART8.RX: J12.99 (UART8.RX)
/subpcb_logic/UART8.TX: R84.1
/subpcb_logic/UART10.RX: J1.3, J12.103 (UART10.RX)
/subpcb_logic/UART10.TX: J1.2, R85.1
/subpcb_logic/~WC: J32.4, R15.2, TP2.1, U5.7 (~WC)
GND: C2.2, C6.2, C7.2, C8.2, C17.2, C18.2, C19.2, C20.2, C34.2, C48.2, D1.2 (A), J1.4, J5.5, J5.6, J12.2 (GND), J12.4 (GND), J12.6 (GND), J12.8 (GND), J12.10 (GND), J12.12 (GND), J12.14 (GND), J12.16 (GND), J12.18 (GND), J12.23 (GND), J12.24 (GND), J12.29 (GND), J12.30 (GND), J12.35 (GND), J12.36 (GND), J12.39 (GND), J12.40 (GND), J12.45 (GND), J12.46 (GND), J12.51 (GND), J12.52 (GND), J12.55 (GND), J12.56 (GND), J12.61 (GND), J12.62 (GND), J12.67 (GND), J12.68 (GND), J12.71 (GND), J12.72 (GND), J12.73 (GND), J12.74 (GND), J12.82 (GND), J12.87 (GND), J12.90 (GND), J12.104 (GND), J12.114 (GND), J12.120 (GND), J12.147 (GND), J12.168 (GND), J12.173 (GND), J12.174 (GND), J12.179 (GND), J12.180 (GND), J12.185 (GND), J12.186 (GND), J12.191 (GND), J12.192 (GND), J12.197 (GND), J12.198 (GND), J12.203 (GND), J12.204 (GND), J12.SH1 (GND), J12.SH2 (GND), J13.1, J14.1, J15.4, J16.5, J23.5, J24.2, J30.1, J31.2, J32.5, J45.2, J48.5, J54.1, Q2.2 (S), R52.1, U5.1 (E0), U5.2 (E1), U5.3 (E2), U5.4 (VSS), U7.4 (A3), U7.5 (A4), U7.11 (GND); also elsewhere on the board
unnamed: C18.1, D1.1 (K), J24.1, R16.2
unnamed: D21.2 (A), M1.2 (-), Q2.3 (D)
unnamed: J12.79 (UART1.TX), R1.2
unnamed: J12.89 (UART2.TX), R3.2
unnamed: J12.83 (UART4.TX), R5.2
unnamed: J12.75 (UART6.TX), R6.2
unnamed: J12.93 (UART7.TX), R83.2
unnamed: J12.97 (UART8.TX), R84.2
unnamed: J12.101 (UART10.TX), R85.2
unnamed: J12.151 (AGPIO1), R18.2
unnamed: J12.153 (AGPIO2), R39.2
unnamed: J12.155 (AGPIO3), R40.2
unnamed: J12.157 (AGPIO4), R42.2
unnamed: J12.159 (AGPIO5), R63.2
unnamed: Q2.1 (G), R53.2

Notes on the sheet:
Hall sensors (emergency etc)
Right ESC
Charger
Center ESC
Identification for this Mainboard Version
Large GPS
Additional SWD Port for Programming the STM32
Left ESC

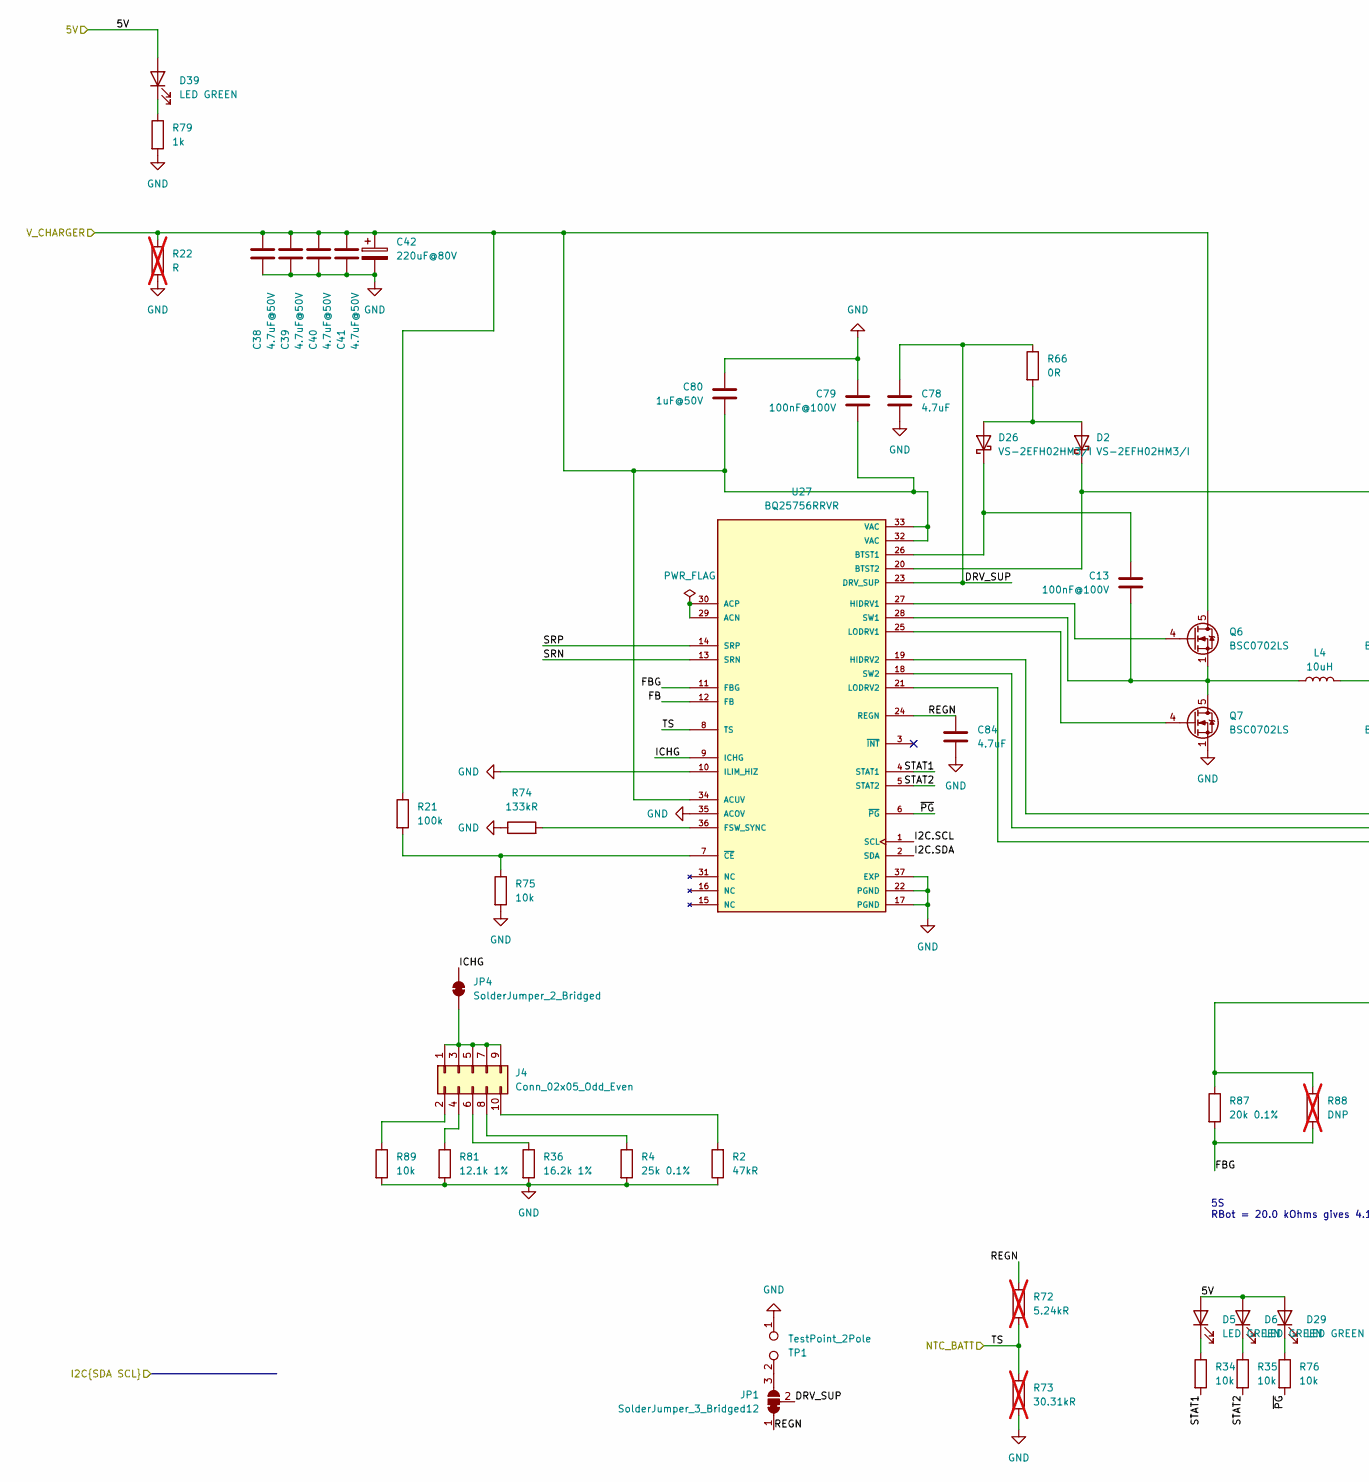
[picture p27: schematic Charger.kicad_sch, part in row 1, column 1]

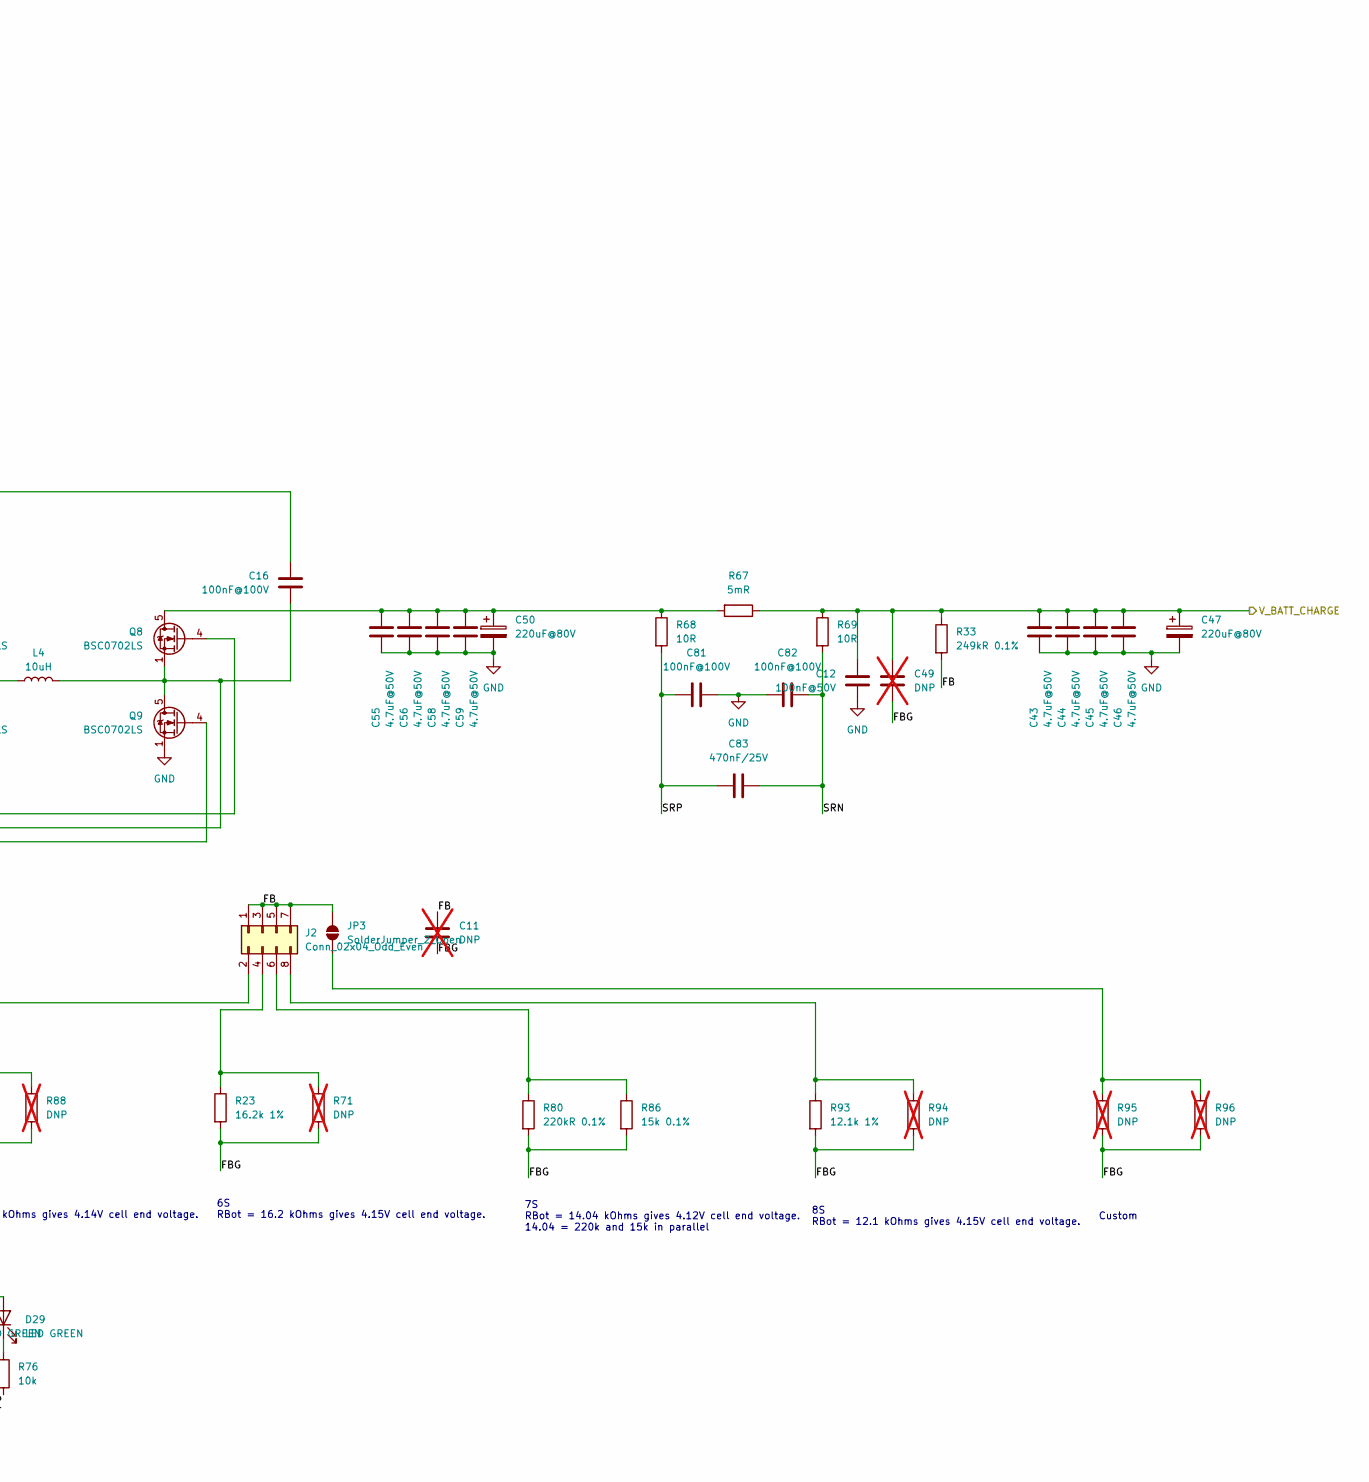
[picture p28: schematic Charger.kicad_sch, part in row 1, column 2]

Parts:
C11, C49: DNP; C_0603_1608Metric; not fitted
C12: 100nF@50V; C_0603_1608Metric; JLC C14663
C13, C16, C79, C81, C82: 100nF@100V; C_0805_2012Metric; JLC C28233
C38, C39, C40, C41, C43, C44, C45, C46, C55, C56, C58, C59: 4.7uF@50V; C_1206_3216Metric; JLC C29823
C42, C47, C50: 220uF@80V; CP_Radial_D10.0mm_P5.00mm; JLC C106516
C78, C84: 4.7uF; C_0805_2012Metric; JLC C1779
C80: 1uF@50V; C_0805_2012Metric; JLC C354368
C83: 470nF/25V; C_0603_1608Metric; JLC C1623
D2, D26: VS-2EFH02HM3/I; D_SMF; JLC C241868
D5, D6, D29, D39: LED GREEN; LED_0805_2012Metric; JLC C2297
J2: Conn_02x04_Odd_Even; PinHeader_2x04_P2.54mm_Vertical; JLC C5383105
J4: Conn_02x05_Odd_Even; PinHeader_2x05_P2.54mm_Vertical; JLC C706895
JP1: SolderJumper_3_Bridged12; SolderJumper-3_P1.3mm_Bridged12_Pad1.0x1.5mm
JP3: SolderJumper_2_Open; SolderJumper-2_P1.3mm_Open_Pad1.0x1.5mm
JP4: SolderJumper_2_Bridged; SolderJumper-2_P1.3mm_Bridged_Pad1.0x1.5mm
L4: 10uH; L_Sunlord_MWSA1004S; JLC C408487
Q6, Q7, Q8, Q9: BSC0702LS; TDSON-8-1; JLC C501503
R2: 47kR; R_0603_1608Metric; JLC C25819
R4: 25k 0.1%; R_0603_1608Metric; JLC C2828637
R21: 100k; R_0402_1005Metric; JLC C25741
R22: R; R_1206_3216Metric; not fitted
R23, R36: 16.2k 1%; R_0603_1608Metric; JLC C22885
R33: 249kR 0.1%; R_0603_1608Metric; JLC C705752
R34, R35, R75, R76: 10k; R_0402_1005Metric; JLC C25744
R66: 0R; R_0805_2012Metric; JLC C17477
R67: 5mR; R_2512_6332Metric; JLC C309526
R68, R69: 10R; R_0603_1608Metric; JLC C22859
R71, R88, R94, R95, R96: DNP; R_0603_1608Metric; not fitted
R72: 5.24kR; R_0603_1608Metric; not fitted
R73: 30.31kR; R_0603_1608Metric; not fitted
R74: 133kR; R_0603_1608Metric; JLC C227577
R79: 1k; R_0805_2012Metric; JLC C17513
R80: 220kR 0.1%; R_0603_1608Metric; JLC C861231
R81, R93: 12.1k 1%; R_0603_1608Metric; JLC C22864
R86: 15k 0.1%; R_0603_1608Metric; JLC C2692707
R87: 20k 0.1%; R_0603_1608Metric; JLC C4184
R89: 10k; R_0603_1608Metric; JLC C25804
TP1: TestPoint_2Pole; PinHeader_1x02_P2.54mm_Vertical
U27: BQ25756RRVR; PARTREV August 2023; JLC C19272232

Connections:
/subpcb_charger/5V: D5.2 (A), D6.2 (A), D29.2 (A), D39.2 (A); also elsewhere on the board
/subpcb_charger/Charger/DRV_SUP: C78.1, JP1.2 (C), R66.1, U27.23 (DRV_SUP)
/subpcb_charger/Charger/FB: C11.1, J2.1, J2.3, J2.5, J2.7, JP3.2 (B), R33.2, U27.12 (FB)
/subpcb_charger/Charger/FBG: C11.2, C49.2, R23.2, R71.2, R80.2, R86.2, R87.2, R88.2, R93.2, R94.2, R95.2, R96.2, U27.11 (FBG)
/subpcb_charger/Charger/ICHG: JP4.2 (B), U27.9 (ICHG)
/subpcb_charger/Charger/REGN: C84.1, JP1.1 (A), R72.1, U27.24 (REGN)
/subpcb_charger/Charger/SRN: C82.1, C83.2, R69.2, U27.13 (SRN)
/subpcb_charger/Charger/SRP: C81.2, C83.1, R68.2, U27.14 (SRP)
/subpcb_charger/Charger/STAT1: R34.2, U27.4 (STAT1)
/subpcb_charger/Charger/STAT2: R35.2, U27.5 (STAT2)
/subpcb_charger/Charger/V_BATT_CHARGE: C12.2, C43.1, C44.1, C45.1, C46.1, C47.1, C49.1, R33.1, R67.1, R69.1; also elsewhere on the board
/subpcb_charger/Charger/~PG: R76.2, U27.6 (~PG)
/subpcb_charger/I2C.SCL: U27.1 (SCL); also elsewhere on the board
/subpcb_charger/I2C.SDA: U27.2 (SDA); also elsewhere on the board
/subpcb_charger/NTC_BATT: R72.2, R73.1, U27.8 (TS); also elsewhere on the board
/subpcb_charger/V_CHARGE: C38.1, C39.1, C40.1, C41.1, C42.1, C79.1, C80.1, Q6.5 (D), R21.1, R22.1, U27.32 (VAC), U27.33 (VAC), U27.34 (ACUV); also elsewhere on the board
GND: C12.1, C38.2, C39.2, C40.2, C41.2, C42.2, C43.2, C44.2, C45.2, C46.2, C47.2, C50.2, C55.2, C56.2, C58.2, C59.2, C78.2, C79.2, C80.2, C81.1, C82.2, C84.2, Q7.1 (S), Q7.2 (S), Q7.3 (S), Q9.1 (S), Q9.2 (S), Q9.3 (S), R2.1, R4.2, R22.2, R36.2, R73.2, R74.1, R75.2, R79.2, R81.2, R89.2, TP1.1, U27.10 (ILIM_HIZ), U27.17 (PGND), U27.22 (PGND), U27.35 (ACOV), U27.37 (EXP); also elsewhere on the board
unnamed: D2.2 (A), D26.2 (A), R66.2
unnamed: C16.2, D2.1 (K), U27.20 (BTST2)
unnamed: D5.1 (K), R34.1
unnamed: D6.1 (K), R35.1
unnamed: C13.2, D26.1 (K), U27.26 (BTST1)
unnamed: D29.1 (K), R76.1
unnamed: D39.1 (K), R79.1
unnamed: J2.2, R87.1, R88.1
unnamed: J2.4, R23.1, R71.1
unnamed: J2.6, R80.1, R86.1
unnamed: J2.8, R93.1, R94.1
unnamed: J4.1, J4.3, J4.5, J4.7, J4.9, JP4.1 (A)
unnamed: J4.2, R89.1
unnamed: J4.4, R81.1
unnamed: J4.6, R36.1
unnamed: J4.8, R4.1
unnamed: J4.10, R2.2
unnamed: JP1.3 (B), TP1.2
unnamed: JP3.1 (A), R95.1, R96.1
unnamed: Q6.4 (G), U27.27 (HIDRV1)
unnamed: C13.1, L4.1, Q6.1 (S), Q6.2 (S), Q6.3 (S), Q7.5 (D), U27.28 (SW1)
unnamed: Q7.4 (G), U27.25 (LODRV1)
unnamed: C50.1, C55.1, C56.1, C58.1, C59.1, Q8.5 (D), R67.2, R68.1
unnamed: Q8.4 (G), U27.19 (HIDRV2)
unnamed: C16.1, L4.2, Q8.1 (S), Q8.2 (S), Q8.3 (S), Q9.5 (D), U27.18 (SW2)
unnamed: Q9.4 (G), U27.21 (LODRV2)
unnamed: U27.29 (ACN), U27.30 (ACP)
unnamed: R74.2, U27.36 (FSW_SYNC)
unnamed: R21.2, R75.1, U27.7 (~CE)

Notes on the sheet:
6S RBot = 16.2 kOhms gives 4.15V cell end voltage.
Custom
7S RBot = 14.04 kOhms gives 4.12V cell end voltage. 14.04 = 220k and 15k in parallel
5S RBot = 20.0 kOhms gives 4.14V cell end voltage.
8S RBot = 12.1 kOhms gives 4.15V cell end voltage.
