laberge1/hw-openmower-universal/hw-openmower-universal.kicad_pcb

## KiCad design hw-openmower-universal.kicad_pcb (continued)

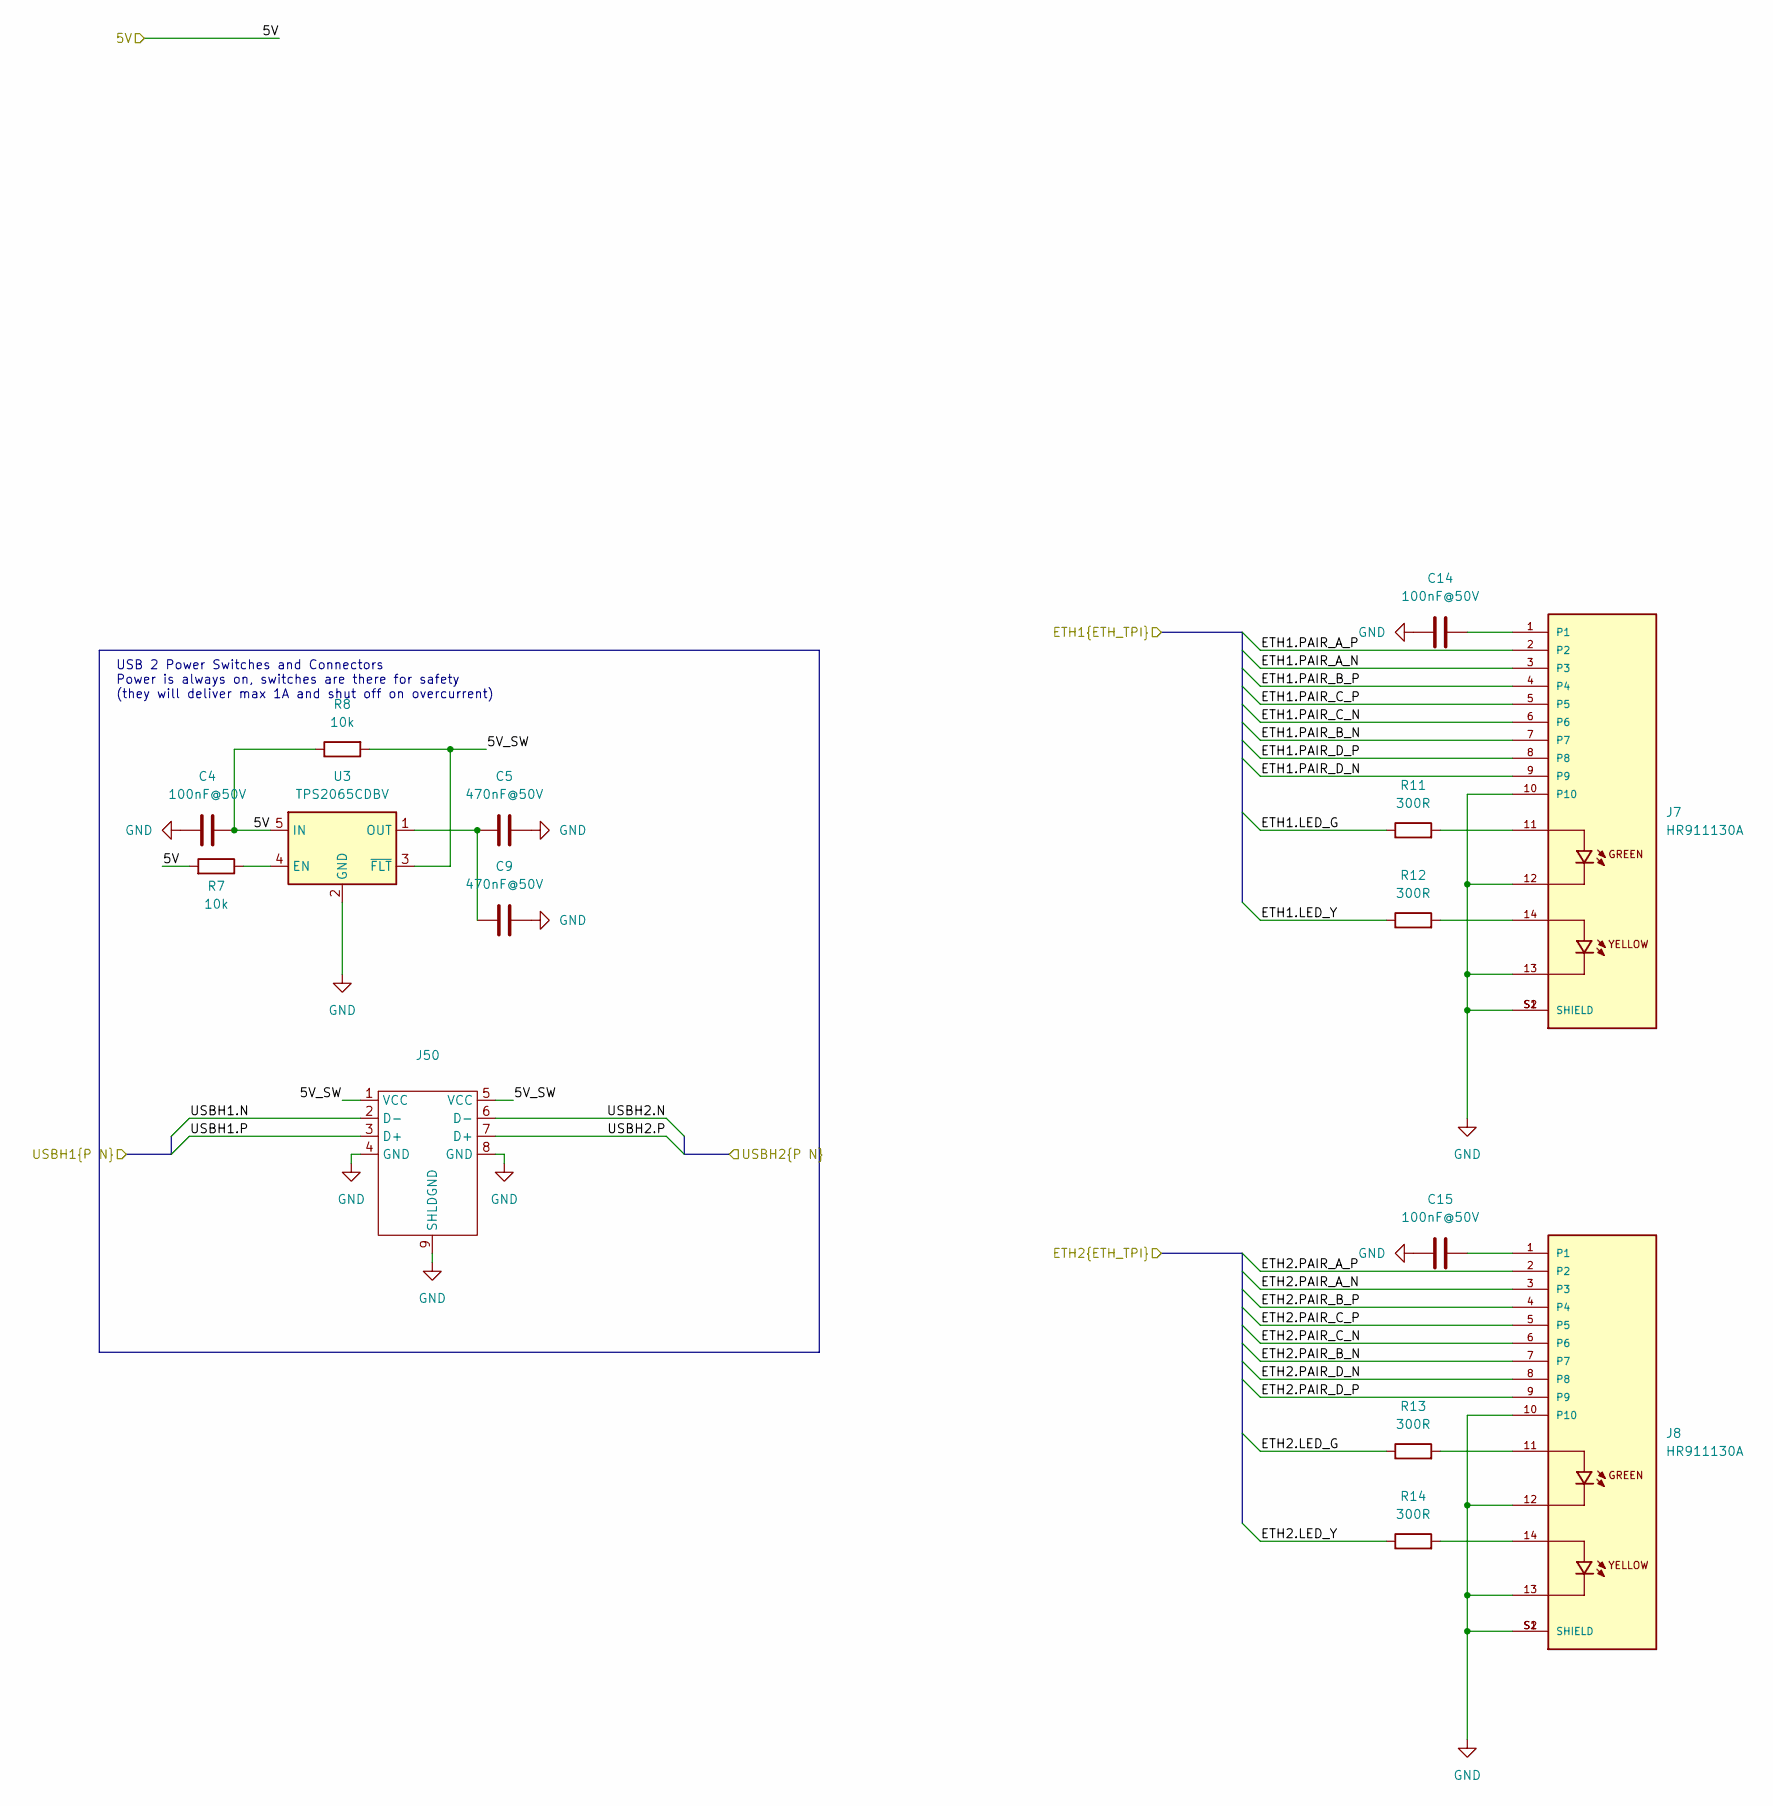
[picture p29: schematic Connectors.kicad_sch]

Parts:
C4, C14, C15: 100nF@50V; C_0402_1005Metric; JLC C307331
C5, C9: 470nF@50V; C_0805_2012Metric; JLC C13967
J7, J8: HR911130A; PARTREV A; JLC C54408
J50: Kinghelm_USB_dual_vert
R7, R8: 10k; R_0402_1005Metric; JLC C25744
R11, R12, R13, R14: 300R; R_0603_1608Metric; JLC C23025
U3: TPS2065CDBV; SOT-23-5; JLC C353882

Connections:
/5V: C4.1, R7.2, R8.1, U3.5 (IN); also elsewhere on the board
/subpcb_logic/Connectors/5V_SW: J50.1 (VCC), J50.5 (VCC), R8.2, U3.3 (~FLT)
/subpcb_logic/Connectors/ETH1.LED_G: R11.1; also elsewhere on the board
/subpcb_logic/Connectors/ETH1.LED_Y: R12.1; also elsewhere on the board
/subpcb_logic/Connectors/ETH1.PAIR_A_N: J7.3; also elsewhere on the board
/subpcb_logic/Connectors/ETH1.PAIR_A_P: J7.2; also elsewhere on the board
/subpcb_logic/Connectors/ETH1.PAIR_B_N: J7.7; also elsewhere on the board
/subpcb_logic/Connectors/ETH1.PAIR_B_P: J7.4; also elsewhere on the board
/subpcb_logic/Connectors/ETH1.PAIR_C_N: J7.6; also elsewhere on the board
/subpcb_logic/Connectors/ETH1.PAIR_C_P: J7.5; also elsewhere on the board
/subpcb_logic/Connectors/ETH1.PAIR_D_N: J7.9; also elsewhere on the board
/subpcb_logic/Connectors/ETH1.PAIR_D_P: J7.8; also elsewhere on the board
/subpcb_logic/Connectors/ETH2.LED_G: R13.1; also elsewhere on the board
/subpcb_logic/Connectors/ETH2.LED_Y: R14.1; also elsewhere on the board
/subpcb_logic/Connectors/ETH2.PAIR_A_N: J8.3; also elsewhere on the board
/subpcb_logic/Connectors/ETH2.PAIR_A_P: J8.2; also elsewhere on the board
/subpcb_logic/Connectors/ETH2.PAIR_B_N: J8.7; also elsewhere on the board
/subpcb_logic/Connectors/ETH2.PAIR_B_P: J8.4; also elsewhere on the board
/subpcb_logic/Connectors/ETH2.PAIR_C_N: J8.6; also elsewhere on the board
/subpcb_logic/Connectors/ETH2.PAIR_C_P: J8.5; also elsewhere on the board
/subpcb_logic/Connectors/ETH2.PAIR_D_N: J8.8; also elsewhere on the board
/subpcb_logic/Connectors/ETH2.PAIR_D_P: J8.9; also elsewhere on the board
/subpcb_logic/Connectors/USBH1.N: J50.2 (D-); also elsewhere on the board
/subpcb_logic/Connectors/USBH1.P: J50.3 (D+); also elsewhere on the board
/subpcb_logic/Connectors/USBH2.N: J50.6 (D-); also elsewhere on the board
/subpcb_logic/Connectors/USBH2.P: J50.7 (D+); also elsewhere on the board
GND: C4.2, C5.2, C9.2, C14.1, C15.1, J7.10, J7.12, J7.13, J7.S1 (SHIELD), J7.S2 (SHIELD), J8.10, J8.12, J8.13, J8.S1 (SHIELD), J8.S2 (SHIELD), J50.4 (GND), J50.8 (GND), J50.9 (SHLDGND), U3.2 (GND); also elsewhere on the board
unnamed: C14.2, J7.1
unnamed: J7.11, R11.2
unnamed: J7.14, R12.2
unnamed: C15.2, J8.1
unnamed: J8.11, R13.2
unnamed: J8.14, R14.2
unnamed: R7.1, U3.4 (EN)
unnamed: C5.1, C9.1, U3.1 (OUT)

Notes on the sheet:
USB 2 Power Switches and Connectors Power is always on, switches are there for safety (they will deliver max 1A and shut off on overcurrent)

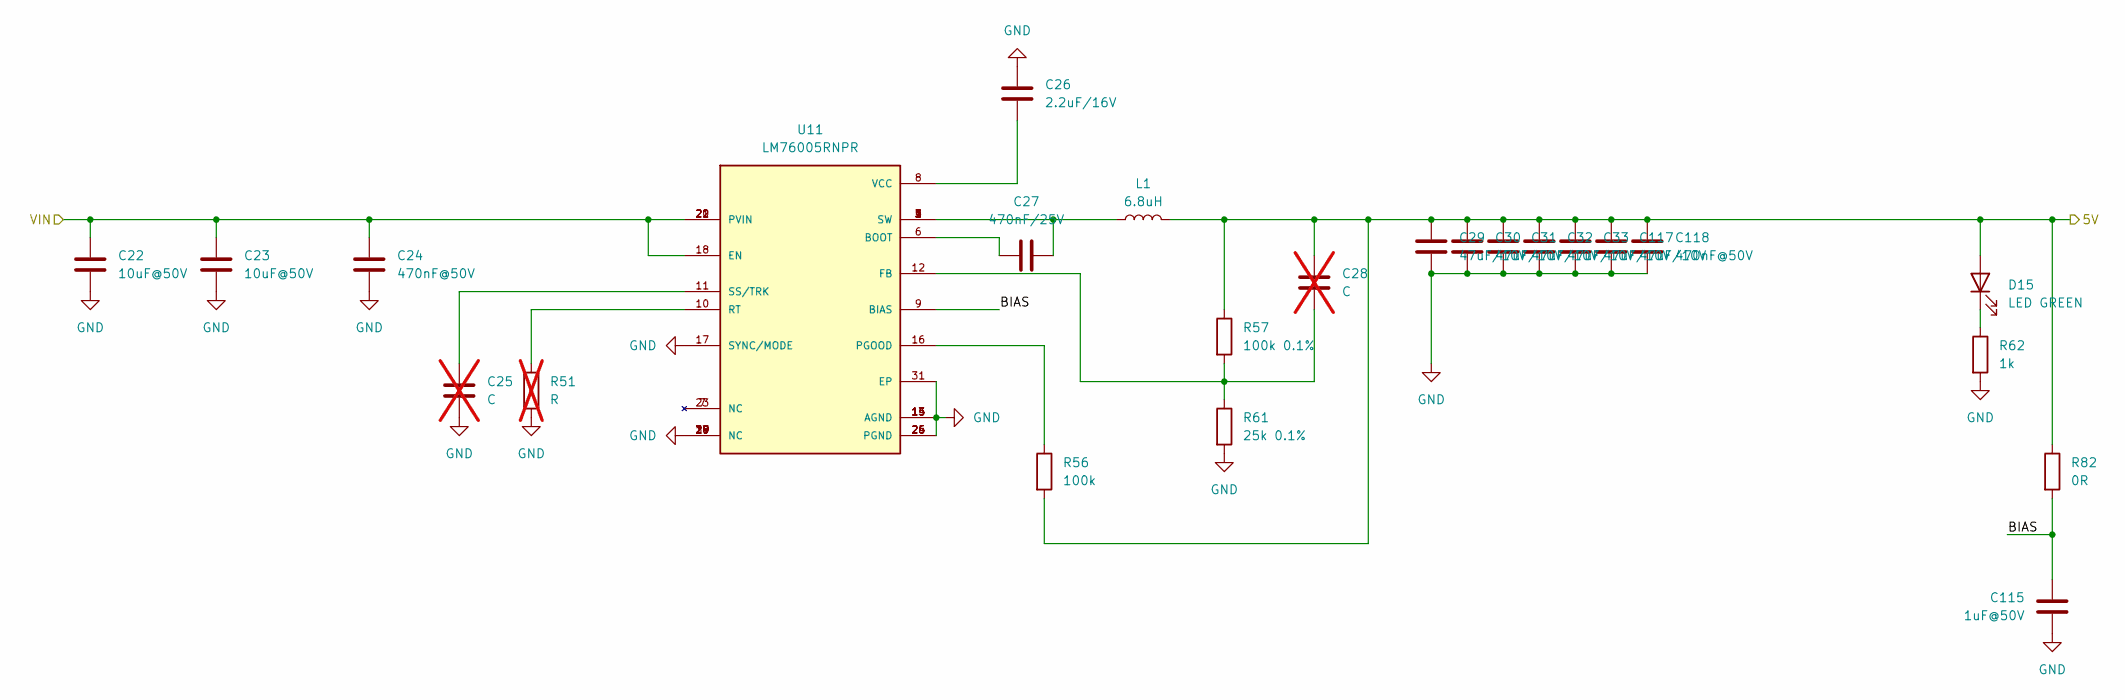
[picture p30: schematic DCDC.kicad_sch]

Parts:
C22, C23: 10uF@50V; C_1206_3216Metric; JLC C13585
C24, C118: 470nF@50V; C_0805_2012Metric; JLC C13967
C25, C28: C; C_0603_1608Metric; not fitted
C26: 2.2uF/16V; C_0603_1608Metric; JLC C23630
C27: 470nF/25V; C_0603_1608Metric; JLC C1623
C29, C30, C31, C32, C33, C117: 47uF/10V; C_1206_3216Metric; JLC C96123
C115: 1uF@50V; C_0603_1608Metric; JLC C15849
D15: LED GREEN; LED_0805_2012Metric; JLC C2297
L1: 6.8uH; L_Sunlord_MWSA1004S; JLC C408485
R51: R; R_0603_1608Metric; not fitted
R56: 100k; R_0603_1608Metric; JLC C25803
R57: 100k 0.1%; R_0603_1608Metric; JLC C122538
R61: 25k 0.1%; R_0603_1608Metric; JLC C2828637
R62: 1k; R_0805_2012Metric; JLC C17513
R82: 0R; R_0603_1608Metric; JLC C21189
U11: LM76005RNPR; PARTREV A; JLC C2866241

Connections:
/5V: C28.1, C29.1, C30.1, C31.1, C32.1, C33.1, C117.1, C118.1, D15.2 (A), L1.2, R56.2, R57.1, R82.1; also elsewhere on the board
/V_BATTERY: C22.1, C23.1, C24.1, U11.18 (EN), U11.20 (PVIN), U11.21 (PVIN), U11.22 (PVIN); also elsewhere on the board
/subpcb_logic/DCDC/BIAS: C115.2, R82.2, U11.9 (BIAS)
GND: C22.2, C23.2, C24.2, C25.2, C26.1, C29.2, C30.2, C31.2, C32.2, C33.2, C115.1, C117.2, C118.2, R51.2, R61.2, R62.2, U11.13 (AGND), U11.14 (AGND), U11.15 (AGND), U11.17 (SYNC/MODE), U11.19 (NC), U11.24 (PGND), U11.25 (PGND), U11.26 (PGND), U11.27 (NC), U11.28 (NC), U11.29 (NC), U11.30 (NC), U11.31 (EP); also elsewhere on the board
unnamed: C27.2, L1.1, U11.1 (SW), U11.2 (SW), U11.3 (SW), U11.4 (SW), U11.5 (SW)
unnamed: D15.1 (K), R62.1
unnamed: C27.1, U11.6 (BOOT)
unnamed: C28.2, R57.2, R61.1, U11.12 (FB)
unnamed: R56.1, U11.16 (PGOOD)
unnamed: R51.1, U11.10 (RT)
unnamed: C25.1, U11.11 (SS/TRK)
unnamed: C26.2, U11.8 (VCC)

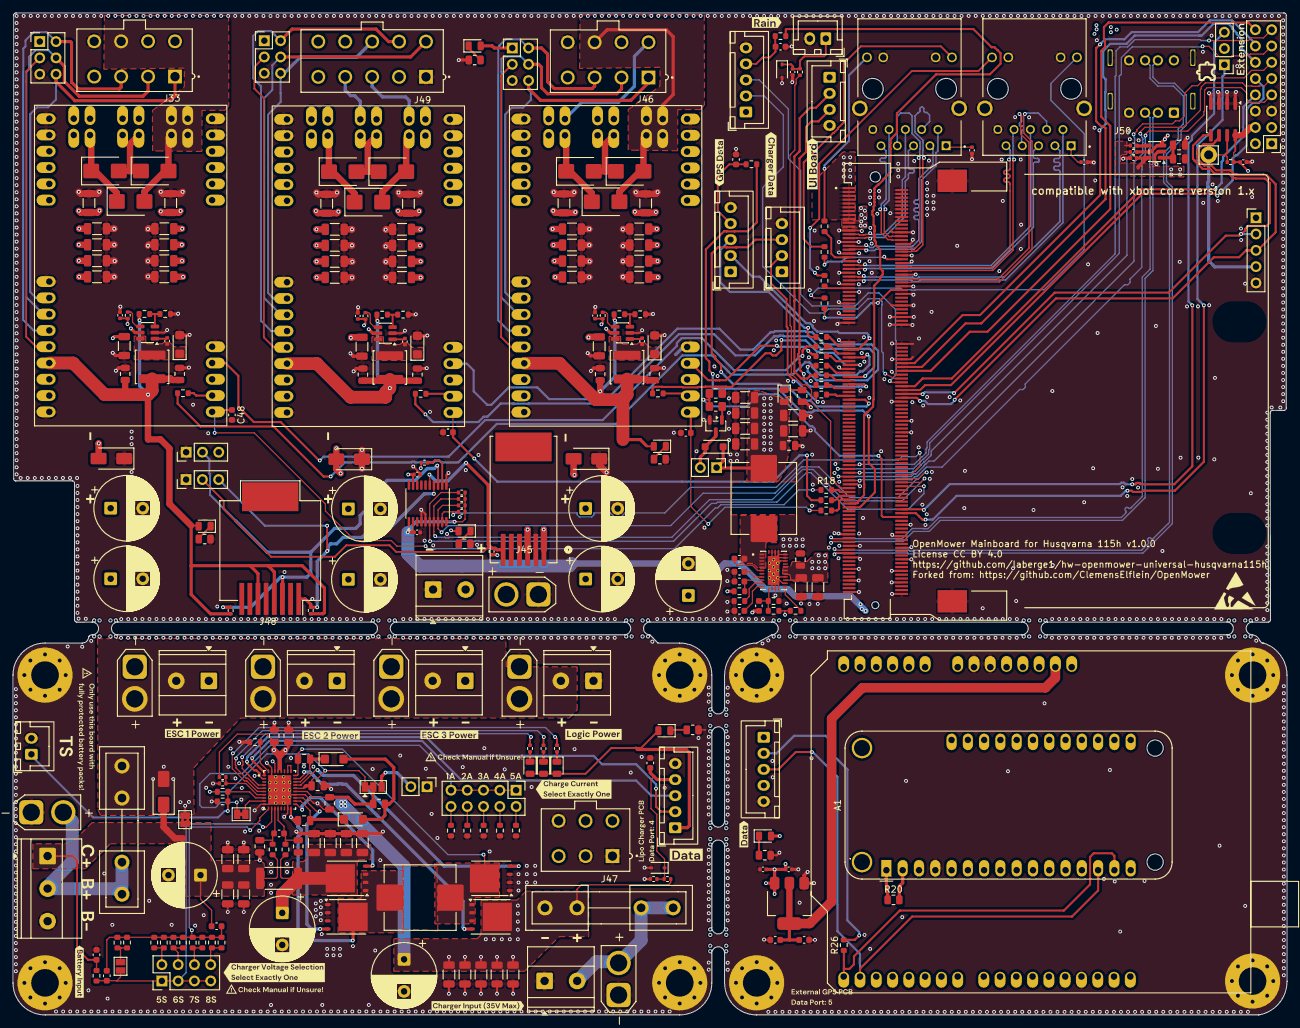
[picture p31: board hw-openmower-universal.kicad_pcb from above]

Board: 4 copper layers, 198.7 x 156.3 mm, 409 parts (0 on the bottom side), 202 nets.

Other parts of the board:
LOGO2: ESD-Logo_6.6x6mm_SilkScreen
kibuzzard-670E8F90: G***; kibuzzard-670E8F90
kibuzzard-670E90ED, kibuzzard-670E90ED#2: G***; kibuzzard-670E90ED
kibuzzard-670E91C7: G***; kibuzzard-670E91C7
kibuzzard-670E91D3: G***; kibuzzard-670E91D3
kibuzzard-670E91D8: G***; kibuzzard-670E91D8
kibuzzard-670E91E3: G***; kibuzzard-670E91E3
kibuzzard-6711AB8A: G***; kibuzzard-6711AB8A
kibuzzard-6853DB1B: G***; kibuzzard-6853DB1B
kibuzzard-6853DB41: G***; kibuzzard-6853DB41
kibuzzard-6853DBB6: G***; kibuzzard-6853DBB6
kibuzzard-67111AE1: G***; kibuzzard-67111AE1
kibuzzard-67111D43: G***; kibuzzard-67111D43
kibuzzard-67111FCC: G***; kibuzzard-67111FCC
kibuzzard-67111FDF: G***; kibuzzard-67111FDF
kibuzzard-67111FEA: G***; kibuzzard-67111FEA
kibuzzard-67111FFB: G***; kibuzzard-67111FFB
kibuzzard-68532E1B, kibuzzard-68532E1B#2, kibuzzard-68532E1B#3, kibuzzard-68532E1B#4, kibuzzard-68532E1B#5, kibuzzard-68532E1B#6, kibuzzard-68532E1B#7, kibuzzard-68532E1B#8, kibuzzard-68532E1B#9: G***; kibuzzard-68532E1B
kibuzzard-68532E12, kibuzzard-68532E12#2, kibuzzard-68532E12#3, kibuzzard-68532E12#4, kibuzzard-68532E12#5, kibuzzard-68532E12#6, kibuzzard-68532E12#7, kibuzzard-68532E12#8, kibuzzard-68532E12#9: G***; kibuzzard-68532E12
kibuzzard-671117D8: G***; kibuzzard-671117D8
kibuzzard-671119EE: G***; kibuzzard-671119EE
kibuzzard-671124D1: G***; kibuzzard-671124D1
kibuzzard-671124D9: G***; kibuzzard-671124D9
kibuzzard-671188B5: G***; kibuzzard-671188B5
kibuzzard-671188C2: G***; kibuzzard-671188C2
kibuzzard-671188D3: G***; kibuzzard-671188D3
kibuzzard-671188DE: G***; kibuzzard-671188DE
kibuzzard-671188EA: G***; kibuzzard-671188EA
kibuzzard-6711201C: G***; kibuzzard-6711201C
kibuzzard-6716385D: G***; kibuzzard-6716385D
kibuzzard-6716388B: G***; kibuzzard-6716388B
kibuzzard-67111882: G***; kibuzzard-67111882
kibuzzard-67111937: G***; kibuzzard-67111937
kibuzzard-67111945: G***; kibuzzard-67111945
kibuzzard-67163896: G***; kibuzzard-67163896
