laberge1/hw-openmower-universal/(commit log)

2026-02-09 New conns for xESC
    Added new connectors into the design for motors.
    [10127820-1022LF.step, Charger.kicad_sch, Connectors.kicad_sch, DCDC.kicad_sch, GPS.kicad_sch, hw-openmower-universal.kicad_sch, subpcb_charger.kicad_sch, subpcb_logic.kicad_sch]
2026-03-07 Routing progress and vertical USB
    [10127820-06xxlfc.stp, 10127820-082XXXLF.stp, 10127820-10xxlfc.stp, 2.FCStd, 855135002.stp, 855135113.stp, Connectors.kicad_sch, PCB_02152026.FCStd]
2026-03-10 Incremental routing updates
    [hw-openmower-universal.kicad_sch, subpcb_logic.kicad_sch, xESC.kicad_sch, xESC_mower.kicad_sch]
2026-03-13 Additional routing
    [subpcb_logic.kicad_sch, xESC.kicad_sch, xESC_mower.kicad_sch]
2026-03-23 Routing progress
    [GPS.kicad_sch, hw-openmower-universal.kicad_pcb, hw-openmower-universal.kicad_sch, subpcb_charger.kicad_sch, xESC.kicad_sch, xESC_mower.kicad_sch]
2026-04-07 Further routing progress
    [Connectors.kicad_sch, hw-openmower-universal.kicad_pcb, hw-openmower-universal.kicad_sch, subpcb_logic.kicad_sch, xESC.kicad_sch, xESC_mower.kicad_sch]
2026-04-20 Review ready layout
    DRC mostly clean. Need to add GND via stitching and GND return vias yet, and general review
    [Charger.kicad_sch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]
2026-05-27 v1.0.0 - released to manufacturing
    Released to manufacturing on 5/27/2026
    [Required_impedance_control.xlsx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]
